stanford-ssi/Aerolotl_KiCAD/README.md

# Aerolotl_KiCAD, make sure to only one person works on it at a time

## Boards in this repo

- Aerolotl SRAD flight computer: the KiCad project at the top level.
- [Battery PCB](BatteryPCB/README.md): the AV bay battery, arming and camera board, with its ordering BOM and Gerbers in `BatteryPCB/fab/`.
