stanford-ssi/Aerolotl_KiCAD/BatteryPCB_30pin/README.md

# Battery PCB, 30-pin ESP32 version — AV bay power, arming and camera board

> **This folder is a copy of [`../BatteryPCB`](../BatteryPCB) made on 11 Oct 2026 for a 30-pin ESP32 DevKit V1**
> (DOIT layout, ESP-WROOM-32, 2 × 15 pins, rows 25.4 mm apart) instead of the 38-pin ESP32-DevKitC. Only the ESP32
> sockets and what connects to them changed: J1/J2 are 1×15 with pin 1 exactly where the DevKitC's was, the six used
> pins (5 V, GND, GPIO34, GPIO17, GPIO16, GPIO2) are re-routed, R7/R8 and C9/C10 moved next to their new pins,
> and the silk and antenna keep-out follow the new board. Same GPIOs, so the firmware is unchanged.
> See [`LAYOUT_NOTES.md`](LAYOUT_NOTES.md), "30-pin version".

The battery board for the SSI IREC AV bay: it holds the cells for both flight computers
(each with its own pin-switch arming plug) and a 2S pack that powers an ESP32 and a
RunCam Split 4 camera on the back. Formerly called CamControl.

Open `battery_pcb_30pin.kicad_pro` in KiCad 10. The board is a 5.72 in (145.3 mm) round, 2-layer disc
for the AV bay, placed and fully routed.

**Status (30-pin version, 11 Oct 2026):** ERC 0 errors · DRC 0 violations (warnings included) under the strict rules below, with full schematic parity
(3 documented exclusions, as on `BatteryPCB`; checked with KiCad 10.0.6, see `battery_pcb_30pin.kicad_dru`) · `tools/layoutA/verify_A.py` ALL PASS (36 checks; its cut-out check now counts the 7 rim
notches and Koichi's 4 square zip-tie cut-outs). Ready to order: see [Ordering](#ordering).
[`LAYOUT_NOTES.md`](LAYOUT_NOTES.md) has the history of every layout decision.

---

## What's on it

| Block | Parts |
|---|---|
| 2S pack for camera + ESP32 | BT1, BT2 in series → 7.4 V nom / 8.4 V max |
| Input protection | F1 2 A polyfuse → SW1 (camera power switch plug) → Q1 AO3407A reverse-polarity PMOS (gate to GND, ~0.05 V drop) → D1 SMBJ12A TVS |
| Buck 8.4 V → 5.0 V | U1 LMR51430 (500 kHz) + L1 6.8 µH + FB divider; input caps C1 100 nF (at U1's pins) + C2, C11 10 µF |
| Low-battery cut-off | R9 402k / R10 100k on U1's EN: on above 6.2 V, off below 5.4 V at VIN (about 2.7 V per cell), so the 2S pack is never run flat |
| 30-pin ESP32 DevKit V1 socket | J1, J2 — 2 × 1×15 female headers |
| Camera harness | J3 — JST GH 5-pin (+5V, GND, RX, TX, VIDEO), on the back |
| Camera mount | H7–H10 — four M2 × 5 mm SMT standoffs on a 25.5 mm square, on the back |
| Status LED | R6 + D2 on GPIO2 |
| Pack voltage telemetry | R4 100k / R5 39k divider + C8 → GPIO34 (`VBAT_SENSE = VIN × 39/139`, ≤ 2.36 V) |
| Test points | 2 mm through-hole pads, open on both sides. **Right-edge block** (front, between the right rod and the lower zip-tie cut-out, top row / bottom row): TP1 +5V / TP3 GND, TP5 COTS cell + / TP6 COTS cell −, TP7 SRAD cell + / TP8 SRAD cell −. **Lower left** by the camera switch: TP2 VBAT+ (2S pack, before the fuse) / TP4 GND |
| COTS supply | BT3 → SW2 (COTS pin switch plug) → J5 XT30 to the TeleMetrum |
| SRAD supply | BT4 → SW3 (SRAD pin switch plug) → J6 XT30 to the Aerolotl |

Harness connectors are latching Molex Micro-Fit 3.0 for the switch leads (SW1–SW3) and JST GH for the
camera (J3). The two battery outputs, J5 and J6, are **AMASS XT30** (male XT30UPB-M on the board):
**pin 1 is minus, pin 2 is plus**, as moulded on the housing and printed beside each one. The cables take an
XT30U-F female plug. The footprint retains its legacy XT30UPB-F name; order XT30UPB-M (C428721). XT30 holds by friction, so tape or tie the plugs for flight. The male pins are exposed and plus is live when its arming switch closes; keep the mating plug connected or cover the pins when armed.

---

## Three design decisions worth knowing

### 1. The Split 4 has no GPIO shutter line

Its harness is **VCC / GND / Video**. Recording start/stop is done over **UART**
using the RunCam Device Protocol on the TX/RX pads, not a single logic pin.

So the schematic wires **UART2** (GPIO17 TX, GPIO16 RX) to the camera through
series resistors: R7 100 Ω on the ESP32's TX, R8 1 kΩ on the camera's TX (so a 5 V camera
output can't push more than about 1 mA into GPIO16). UART0 is left free so you can still
program and debug over USB. On the original DOIT DevKit V1 design, VIN is fed from USB through an SS14 Schottky, so
USB and this board's 5 V can be connected at the same time. Clones vary: until you have checked yours (USB only:
VIN should read about 4.6–4.8 V, one diode drop below USB), switch the camera pack off before plugging USB in.

The camera connects to this board through the 5-pin J3 harness only (no
button-pad wiring).

**The camera harness is a straight cable.** The Split 4 has five solder pads, in this order with Side B
facing you: RX, TX, Video, GND, VCC. J3 is in the same order (pin 5 … pin 1), so each wire goes straight across,
no crossing (J3's pins 3 and 5 were swapped on 11 Oct 2026 to make this so):

| J3 pin | Net | Camera pad |
|---|---|---|
| 1 | +5V | VCC |
| 2 | GND | GND |
| 3 | VIDEO | Video, or leave unconnected (nothing on this board uses it) |
| 4 | CAM_TX (to ESP32 RX through R8) | TX |
| 5 | CAM_RX (ESP32 TX through R7) | RX |

Note: the original `BatteryPCB` still has the old order (3 = RX, 5 = Video), so its harness is wired by label.

### 2. Everything runs off one 5 V buck

The camera accepts 5–20 V, so 2S could feed it directly — but RunCam explicitly
warns to power it from a regulator rather than a raw battery bus.

Feeding the ESP32 8.4 V directly would also be a problem: the devkit's onboard
AMS1117 would drop 8.4 → 3.3 V and burn about **1.3 W** in a SOT-223. It would
run very hot.

One LMR51430 at 5 V solves both. The ESP32's regulator then only drops 5 → 3.3 V,
and the camera gets a clean supply.

Feedback divider: `Vout = 0.6 × (1 + 100k / 13k) = 5.22 V` (5.05–5.39 V worst case over resistor and reference tolerance, so the camera always sees ≥ 5.0 V)

### 3. COTS and SRAD grounds are deliberately isolated

`COTS_BAT-` and `SRAD_BAT-` are **not** tied to `GND`.

DTEG §6.9.1 requires completely independent recovery systems — separate power
supplies included. Tying the returns together would create a shared failure path
and defeat that. Each of those two cells is its own island: own cell, own switch,
own two-wire output.

Do not "clean this up" by merging the grounds.

---

## Which ESP32

A **30-pin ESP32 DevKit V1** with the DOIT pinout and a WROOM module (the team's USB-C / CP2102 board is one): 2 × 15 pins,
rows 1.0 in (25.4 mm) apart, header order EN, VP, VN, D34 … D13, GND, VIN on one side and D23, D22, TX0 … D15, GND, 3V3 on
the other (antenna at the top). The sockets are wired to that order pin for pin.

- **Check the row spacing before you solder the sockets:** 25.4 mm between the centres of two facing pins. A few narrow
  clones are 22.9 mm; they won't fit.
- **Not a WROVER module:** it uses GPIO16/17 for its PSRAM, and this board uses them for the camera UART.
- **Not the 38-pin ESP32-DevKitC:** that one needs `../BatteryPCB` (2 × 19 sockets).
- It plugs in from the **back**, components facing away from this board, antenna end toward the top: **EN** and **D23**
  go at the "ANTENNA END" silkscreen, **VIN** and **3V3** at the USB end (both labelled on the back silk).
- The board sits inside the area the DevKitC used (51.3 × 28 mm vs 54.3 × 27.9 mm), so nothing new is in its way. Its
  module doesn't overhang: the antenna ends about 5.4 mm past pin 1, about 1.9 mm further in than the DevKitC's.
- **Antenna clearance.** Espressif recommends at least 15 mm of clearance in every direction around the module's PCB
  antenna. The devkit hangs about 13.4 mm under this board, so the back copper has a keep-out (no pour, tracks or vias)
  15 mm to each side of the antenna and past its end, outlined on the back silk (extended 1.9 mm toward the centre for
  this board's antenna). Everything on the front, cells and pin-switch stack included, is at least 15 mm away through
  the board. **Use a nylon M3 bolt and nut in H5**: it is the pin-switch stack bolt right over the antenna.
  [Espressif: positioning a module on a base board](https://docs.espressif.com/projects/esp-hardware-design-guidelines/en/latest/esp32/pcb-layout-design.html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)
- The AVBay1 Onshape model already shows a 2 × 15 DevKit, which matches this version.

## ESP32 pin map

| Function | Pin | Net |
|---|---|---|
| 5 V in | J1-15 (VIN) | `+5V` |
| GND | J1-14, J2-14 | `GND` |
| Camera UART TX | J2-9 (TX2, GPIO17) | `ESP_TX2` → R7 → `CAM_RX` |
| Camera UART RX | J2-10 (RX2, GPIO16) | `ESP_RX2` → R8 → `CAM_TX` |
| Status LED | J2-12 (D2, GPIO2) | `LED_GPIO` → R6 → D2 |
| Pack voltage | J1-4 (D34, GPIO34, ADC1) | `VBAT_SENSE` |

J1 is the devkit's EN … VIN header and J2 its D23 … 3V3 header,
both counted from the **antenna end**, which faces the top of the board. Same GPIOs as the DevKitC version.

Every unused header pin is broken out to a named net (`L06_IO35`, `R09_IO18`, …)
so you can see what's free. Those produce 24 `isolated_pin_label` ERC warnings —
expected and harmless, they're spare breakouts by design.

The 30-pin board doesn't break out GPIO6–11 (the module's SPI flash) or GPIO0. Of the strapping pins it does break out,
keep GPIO12 (`L12_IO12`) low at boot; GPIO2 (the LED, pulled low through R6/D2) and GPIO15 are fine as wired.

---

## Camera mounting

The RunCam Split 4 board (29 × 29 mm, M2 holes on a 25.5 mm square) sits on four Würth
9774050243R M2 × 5 mm SMT standoffs (H7–H10) on the back of this board, next to its J3 harness.
Each standoff has a 1.4 mm locating pin on its base that drops into a 3.0 mm hole in the board (Würth's land pattern);
the pin stays inside the 1.6 mm board, so nothing reaches the battery side. Use M2 screws 4–6 mm long.
`battery_pcb.pretty/RunCam_Split4_OnStandoffs.kicad_mod` places its 3D outline; it has no pads
and is excluded from the BOM.

Source: [RunCam Split 4 manual](https://www.runcam.com/download/split4k/RC_Split_4k_Manual_EN.pdf)

---

## Open items

1. **The ESP32's Bluetooth is a 2.4 GHz transmitter.** DTEG §4.3.5 forbids
   powering transmitting electronics in the pit area without authorization, and
   2.4 GHz is not in ESRA's Student Band Plan. SW1 exists partly so you can keep
   it off until the pad. Declare this radio in your progress reports.
2. **No SD card module** is on this schematic — you mentioned one for the plate
   but didn't list it in the brief. Easy to add on SPI (GPIO5/18/19/23).
3. **Confirm the camera's logic level** before connecting RX/TX: power the camera and
   measure its TX pad to GND. About 3.3 V: wire it straight on. About 5 V: R8 (1 kΩ)
   protects the ESP32's input, but the camera may not read the ESP32's 3.3 V TX; add a
   level shifter then.

Layout-specific items are in [`LAYOUT_NOTES.md`](LAYOUT_NOTES.md).

---

## Mechanical dimensions

Front view (battery side), origin at the board centre, **x right, y up toward the pin-switch stack** (the Onshape frame).
All in mm unless noted.

| Feature | Size | Position |
|---|---|---|
| Board | Ø 145.29 (5.720 in), 1.6 thick FR-4 | centred |
| Rod holes H1/H2 (3/8 in threaded rod) | Ø 10.32 (13/32 in) | (−60, 0), (60, 0): 120 apart |
| Rod washer keep-out (no copper, both faces) | Ø 21.2 | around H1/H2 |
| TeleMetrum sled screw holes H3/H4 (M4) | Ø 4.5 | (−8.7, −50), (8.7, −50): 17.4 apart |
| Sled screw keep-out (no copper) | Ø 9.6 | around H3/H4 |
| Pin-switch stack bolt holes H5/H6 (M3) | Ø 3.2 | (18.5, 41.88), (−18.5, 48.88) |
| Pin-switch stack footprint (silk outline) | 45 wide, from y 36.88 out to the pin faces at 68.88 | x −22.5 … 22.5 |
| Camera standoffs H7–H10 (back, Würth M2 × 5 mm SMT) | 25.5 square | centre (−35.5, 30): upper left, near the rim |
| Battery holders BT1–BT4 (Keystone 1042) | 14.9 tall | centres x −36.5, −14.3, 11.1, 36.5; y −2.25 |
| ESP32 sockets J1/J2 (back, 1×15, 8.5 tall) | columns 25.4 apart | x 23.8 and −1.6; pin 1 at y 35.12, pin 15 at y −0.44 |
| ESP32 antenna (devkit hangs ~14 mm below) | 18 × 6 | x 2.1 … 20.1, y 34.5 … 40.5; back-copper keep-out 15 mm around |
| Edge cut-outs (W × D, centre angle CCW from +x) | 40 × 14 at 270° (COTS mount); 10 × 6 at 230° and 327°; 12 × 7 at 30°, 120°, 150°, 200° | on the rim |

Connectors (pad centres): J5 XT30 COTS OUT (22.5/27.5, −51.5), J6 XT30 SRAD OUT (37.5/42.5, −51.5), SW1 CAM PWR
(−30.5/−27.5, −55.1), SW2 COTS ARM (28.3/31.3, 50.4), SW3 SRAD ARM (39.6/42.6, 50.4), J3 camera on the back
(pins −1.5 … −6.5, −20.45). Test points: block at x 51.5 / 56.5 / 61.5, y −15.5 (top row) / −20.5: TP1 +5V, TP5 COTS +, TP7 SRAD +
over TP3 GND, TP6 COTS −, TP8 SRAD −; TP2 VBAT+ (−36.5, −49.5), TP4 GND (−40.5, −49.5).

Heights above the board: front: holder 14.9 (the cell sits a little higher), pin-switch stack ~20.4 (two 10 mm
carriers + 0.4 shim), Micro-Fit 10.2, XT30 about 11. Back: ESP32 socket 8.5, the 30-pin DevKit about 14–16 including its module,
camera standoffs 5 + the camera, JST GH 4.2.

## Design rules

Stricter than the fab's minimums, to leave margin (all in `battery_pcb_30pin.kicad_pro`):

| Rule | Value |
|---|---|
| Copper clearance | 0.25 mm signals, 0.3 mm power and ground, 0.4 mm for the isolated COTS/SRAD battery nets |
| Track width (min) | 0.25 mm; pyro paths ≥ 1.0 mm, 2S power ≥ 1.5 mm (checked by `verify_A.py`) |
| Copper to board edge | 0.5 mm |
| Hole clearance / hole to hole | 0.3 mm / 0.5 mm |
| Via | ≥ 0.6 mm pad, 0.3 mm drill (0.15 mm ring); power vias 0.8 / 0.4 mm |
| Silkscreen | 0.15 mm to other silk and to the edge; text ≥ 0.8 mm |

DRC runs with every check as an error (`tools/drc.sh`).

---

## Ordering

Everything to order is in `fab/`:

| File | What it is |
|---|---|
| `fab/battery_pcb_30pin_BOM.csv` | Ordering BOM: every soldered part with manufacturer + MPN (paste the MPNs into the DigiKey or Mouser BOM tool), plus the camera standoffs, plug-in modules, cells, cable-side connectors and the PCB. "Order qty" covers 2 boards plus spares. The "LCSC #" column has a checked LCSC part for everything LCSC sells; "Other supplier" covers the rest (battery holders, camera standoffs, ESP32). |
| `fab/battery_pcb_30pin_JLCPCB_BOM.csv`, `fab/battery_pcb_30pin_JLCPCB_CPL.csv` | Only if JLCPCB assembles it: their BOM (LCSC part numbers) and placement files. Parts on both sides; check rotations in JLC's preview. The battery holders and camera standoffs are not at LCSC, so solder those yourself. |
| `fab/battery_pcb_30pin_gerbers.zip` | Gerbers + drill files (plated and non-plated separately). Upload as-is to JLCPCB (or any fab): 2 layers, 1.6 mm FR-4, 1 oz copper. |
| `fab/battery_pcb_30pin_schematic.pdf` | The schematic, for review and for soldering. |
| `fab/battery_pcb_30pin_kicad_project.zip` | The whole KiCad project in one file, to share: unzip it and open `battery_pcb_30pin.kicad_pro` (KiCad 10). Downloading only `battery_pcb_30pin.kicad_sch` gives a blank schematic, because its six pages live in `sheets/`. |

`cad/battery_pcb_30pin.step` is the board with all parts for CAD.
`cad/avbay1_board_30pin_and_pin_switch_stack.step` is the board plus the exact pin-switch stack,
raised 18 mm into the Onshape stack frame; it is what the SSI AVBay1 Onshape document imports.

---

## Hand assembly

Everything is hand-solderable (0603 passives, SOT-23-6, one 1.25 mm-pitch JST GH). Use flux, a fine conical tip for the
small parts and a big chisel tip at ~400 °C for the holder tabs and connector pins. **The order matters**: the ESP32
socket pins come up on the front in narrow channels between the battery holders, so solder them before the holders.

1. Back, small SMD: U1, the buck caps/resistors, R4/R5/C8, R6/D2, R7/R8, R9/R10, C9/C10/C11, D1, Q1, F1, then L1
   (hot air helps; its pads run under the body).
2. Back: J3 (JST GH, fine pitch: tack one mounting tab, then the pins), then the four camera standoffs H7–H10 (steel:
   drop each pin into its 3 mm hole, then solder paste + hot air, or flux and the big tip around the base; keep them square).
3. J1/J2 sockets: insert from the back, solder on the front. **Before the holders.** Plug the ESP32 board in while
   soldering so the two rows stay parallel.
4. Front through-hole connectors (soldered on the back): SW1–SW3 Micro-Fit, J5/J6 XT30 (XT30 pins need a lot of heat).
5. Battery holders BT1–BT4 last (big tip, plenty of solder; check the + marks).
6. Bench test before cells or modules: 7–8 V, ~0.3 A limit into TP2 (+) / TP4 (GND); TP1 should read ~5.0 V against TP3.
   With cells in: the COTS cell reads across TP5 (+) / TP6 (−) and the SRAD cell across TP7 (+) / TP8 (−), whether or not
   their pin switches are armed. Those two cells are isolated from GND: always measure each across its own pair, never to TP3/TP4.

## Rebuilding

The layout is generated by scripts so it can be rebuilt after a change. Close KiCad first
(it rewrites project files when it quits), and use KiCad 10 on macOS (the scripts call its
bundled Python and `kicad-cli`).

```
tools/layoutA/build_A.sh /tmp/new.kicad_pcb   # place, route, labels, fields, refill, DRC, verify
cp /tmp/new.kicad_pcb battery_pcb_30pin.kicad_pcb
python3 tools/annotate_mpn.py                 # after changing a part: edit PARTS in it first
python3 tools/make_bom.py                     # rewrites fab/battery_pcb_30pin_BOM.csv
tools/make_fab.sh                             # BOM, schematic PDF, Gerbers + drills, project zip
tools/make_step.sh                            # cad/ STEPs (board centred) for Onshape AVBay1
```

`tools/layoutA/` starts from `seed_user_1224.kicad_pcb`, the hand-placed version, so hand edits
to `battery_pcb_30pin.kicad_pcb` are lost on the next rebuild: make changes in the scripts instead.
`tools/kc.py` holds the shared dimensions (disc size, battery and connector offsets). The one-shot
generators that made the very first versions are archived in `tools/obsolete/`; don't re-run them.

## Final order comparison — 11 October 2026

Use `fab/order-package/` for the partial back-side assembly quote: 5 fabricated boards, 2 assembled, 27 placements per assembled board. Upload its Gerber ZIP, `BOM-quote.csv` and `CPL-bottom.csv`. The legacy full `fab/battery_pcb_30pin_JLCPCB_BOM.csv` includes additional hand-fit connectors and is not the partial assembly BOM.

C1 is now C49678, C4/C5 C45783 (22 uF / 25 V), and D2 C84256. The schematic and PCB part fields are synchronized. Q1 remains AO3407A. JLC matched all 18 part types: $33.51 bare boards or $75.10 with two partially assembled, before shipping/tax. See the package README for substitutions and remaining mechanical/placement review limitations, including U1's DDC land-pattern compatibility.

The saved board includes the current square zip-tie cutouts. Previous CAD/renders/project-sharing archives may predate these latest edits; use the current KiCad project and current fabrication ZIP for ordering.
