stanford-ssi/Aerolotl_KiCAD/BatteryPCB_30pin/renders/battery_pcb_top.png

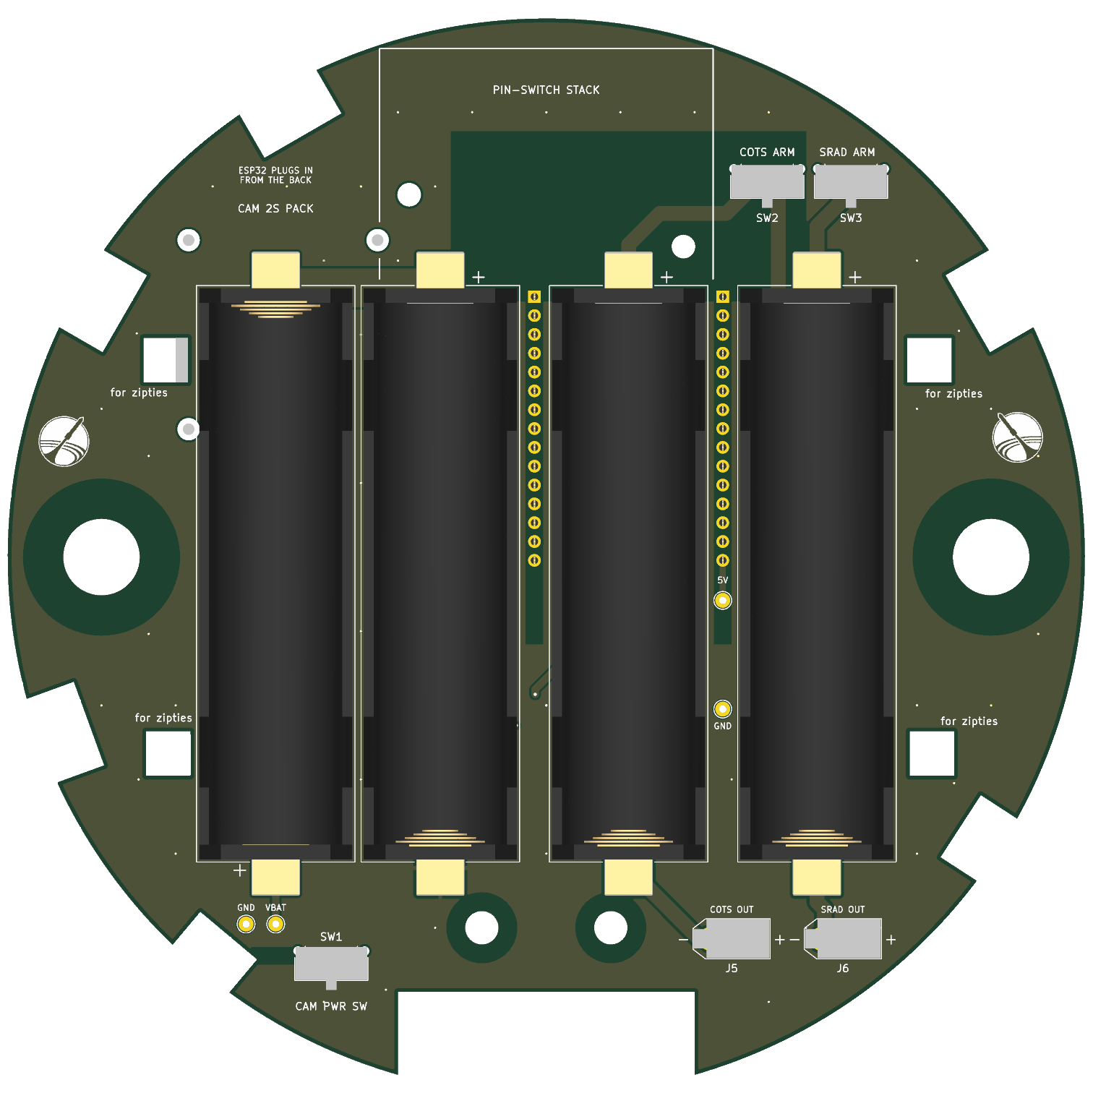
BatteryPCB_30pin/renders/battery_pcb_top.png
