stanford-ssi/Aerolotl_KiCAD/BatteryPCB/3dmodels/AMASS_XT30UPB-F_1x02_P5.0mm_Vertical.step

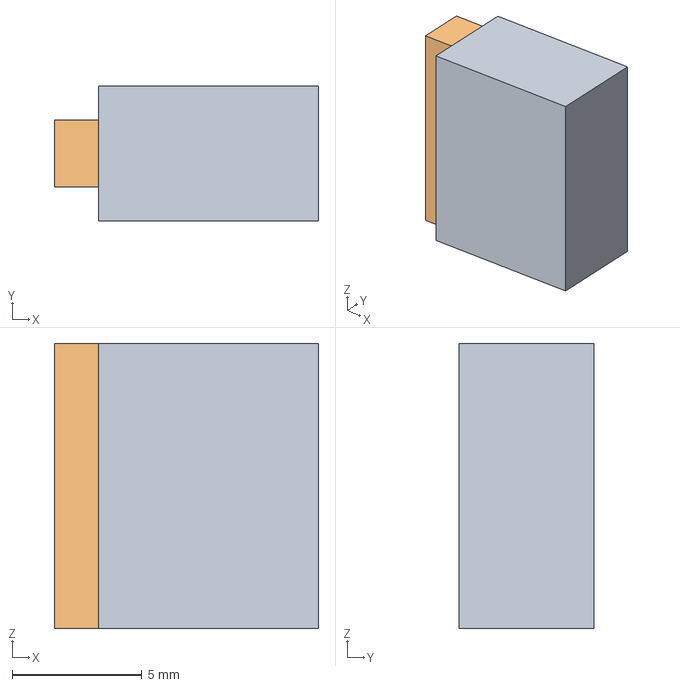
[picture p3: CAD file, 2026-10-08]
BatteryPCB/3dmodels/AMASS_XT30UPB-F_1x02_P5.0mm_Vertical.step
10.2 x 5.20 x 11.0 mm
