stanford-ssi/Aerolotl_KiCAD/BatteryPCB_30pin/3dmodels/Molex_Micro-Fit_3.0_43650-0215_1x02_P3.00mm_Vertical.step

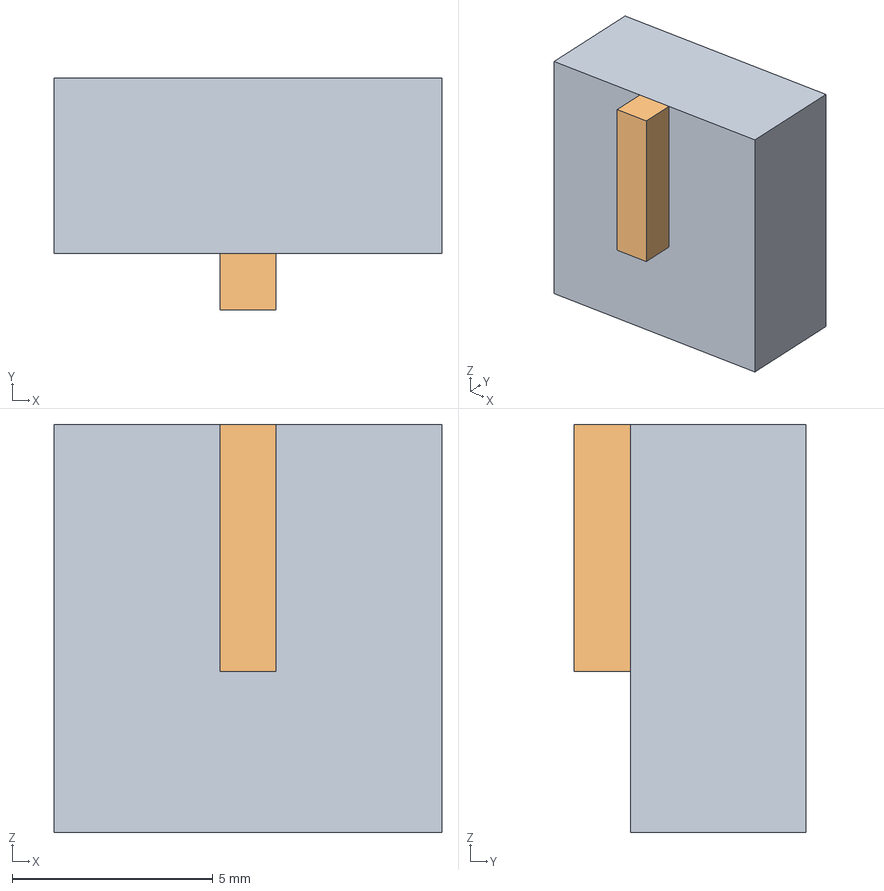
[picture p5: CAD file, 2026-10-06]
BatteryPCB_30pin/3dmodels/Molex_Micro-Fit_3.0_43650-0215_1x02_P3.00mm_Vertical.step
9.65 x 5.77 x 10.2 mm
