stanford-ssi/Aerolotl_KiCAD/BatteryPCB/3dmodels/RunCam_Split4_placeholder.step

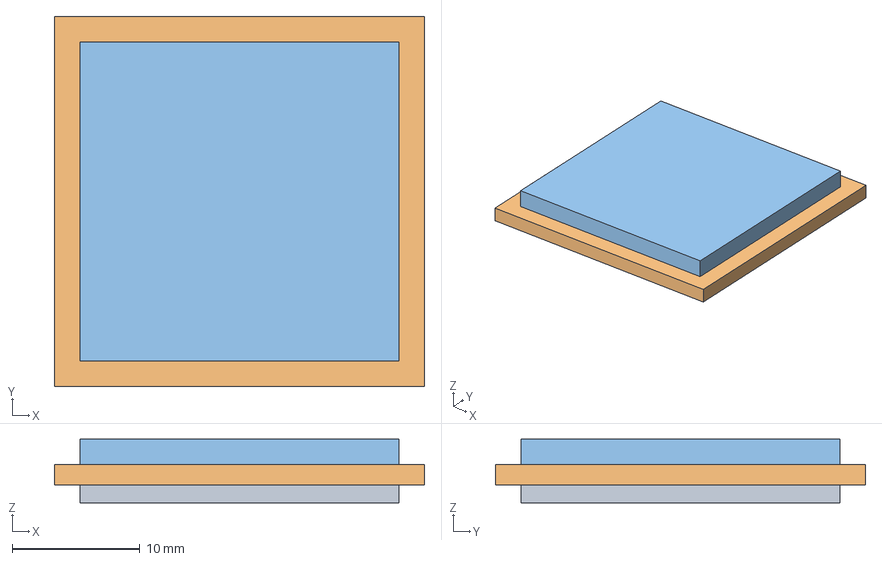
[picture p7: CAD file, 2026-10-06]
BatteryPCB/3dmodels/RunCam_Split4_placeholder.step
29.0 x 29.0 x 5.00 mm
