stanford-ssi/Aerolotl_KiCAD/BatteryPCB/cad/avbay1_board_and_pin_switch_stack.step

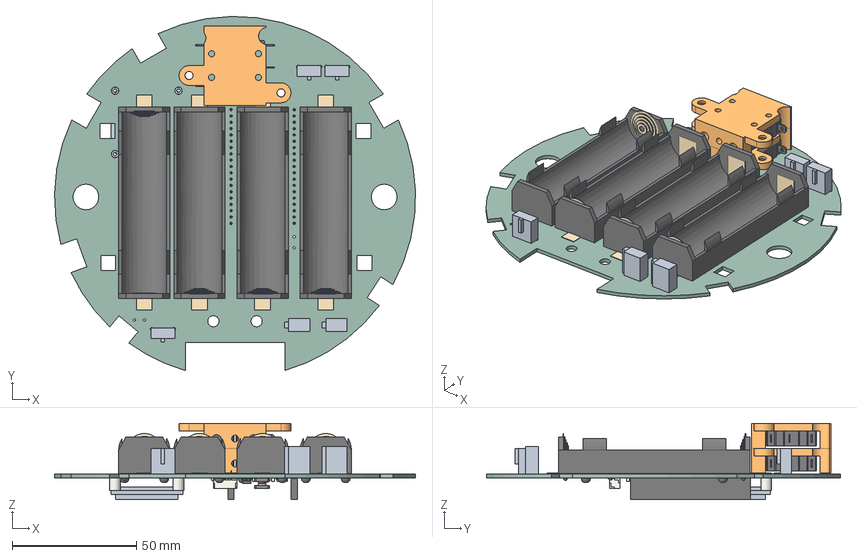
[picture p8: CAD file, 2026-10-12]
BatteryPCB/cad/avbay1_board_and_pin_switch_stack.step
145.2 x 142.5 x 30.6 mm
Molex_Micro-Fit_3.0_43650-0215_1x02_P3.00mm_Vertical x 3
BatteryHolder_Keystone_1042_1x18650 x 4
AMASS_XT30UPB-F_1x02_P5.0mm_Vertical x 2
C_0805_2012Metric x 6
Mounting_Wuerth_WA-SMSI-M2_H5mm_9774050243 x 4
JST_GH_BM05B-GHS-TBT_1x05-1MP_P1.25mm_Vertical
LED_0805_2012Metric
C_0603_1608Metric x 5
R_0603_1608Metric x 9
PinSocket_1x19_P2.54mm_Vertical x 2
SOT-23-3
RunCam_Split4_placeholder
D_SMB
SOT-23-6
L_Bourns_SRN6045TA
battery_pcb_PCB
