stanford-ssi/Aerolotl_KiCAD/BatteryPCB/cad/pin_switch_stack_8parts_mm.step

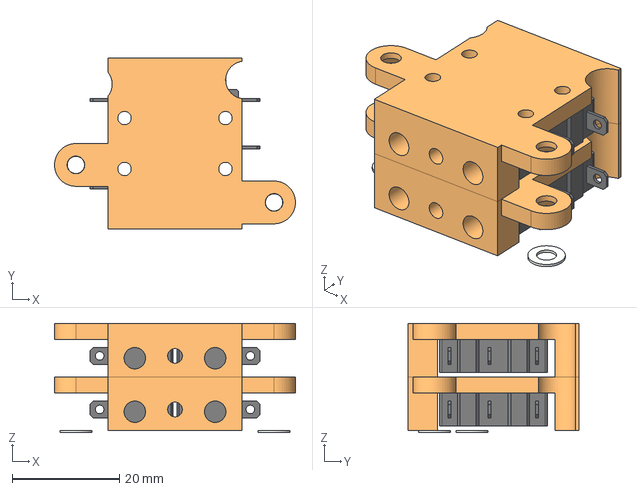
[picture p9: CAD file, 2026-10-06]
BatteryPCB/cad/pin_switch_stack_8parts_mm.step
45.0 x 32.0 x 20.4 mm
