stanford-ssi/Aerolotl_KiCAD/(list of files, cad)

Other CAD files:
BatteryPCB_30pin/cad/avbay1_board_30pin_and_pin_switch_stack.step
