stanford-ssi/Aerolotl_KiCAD/BatteryPCB/fab/battery_pcb_schematic.pdf

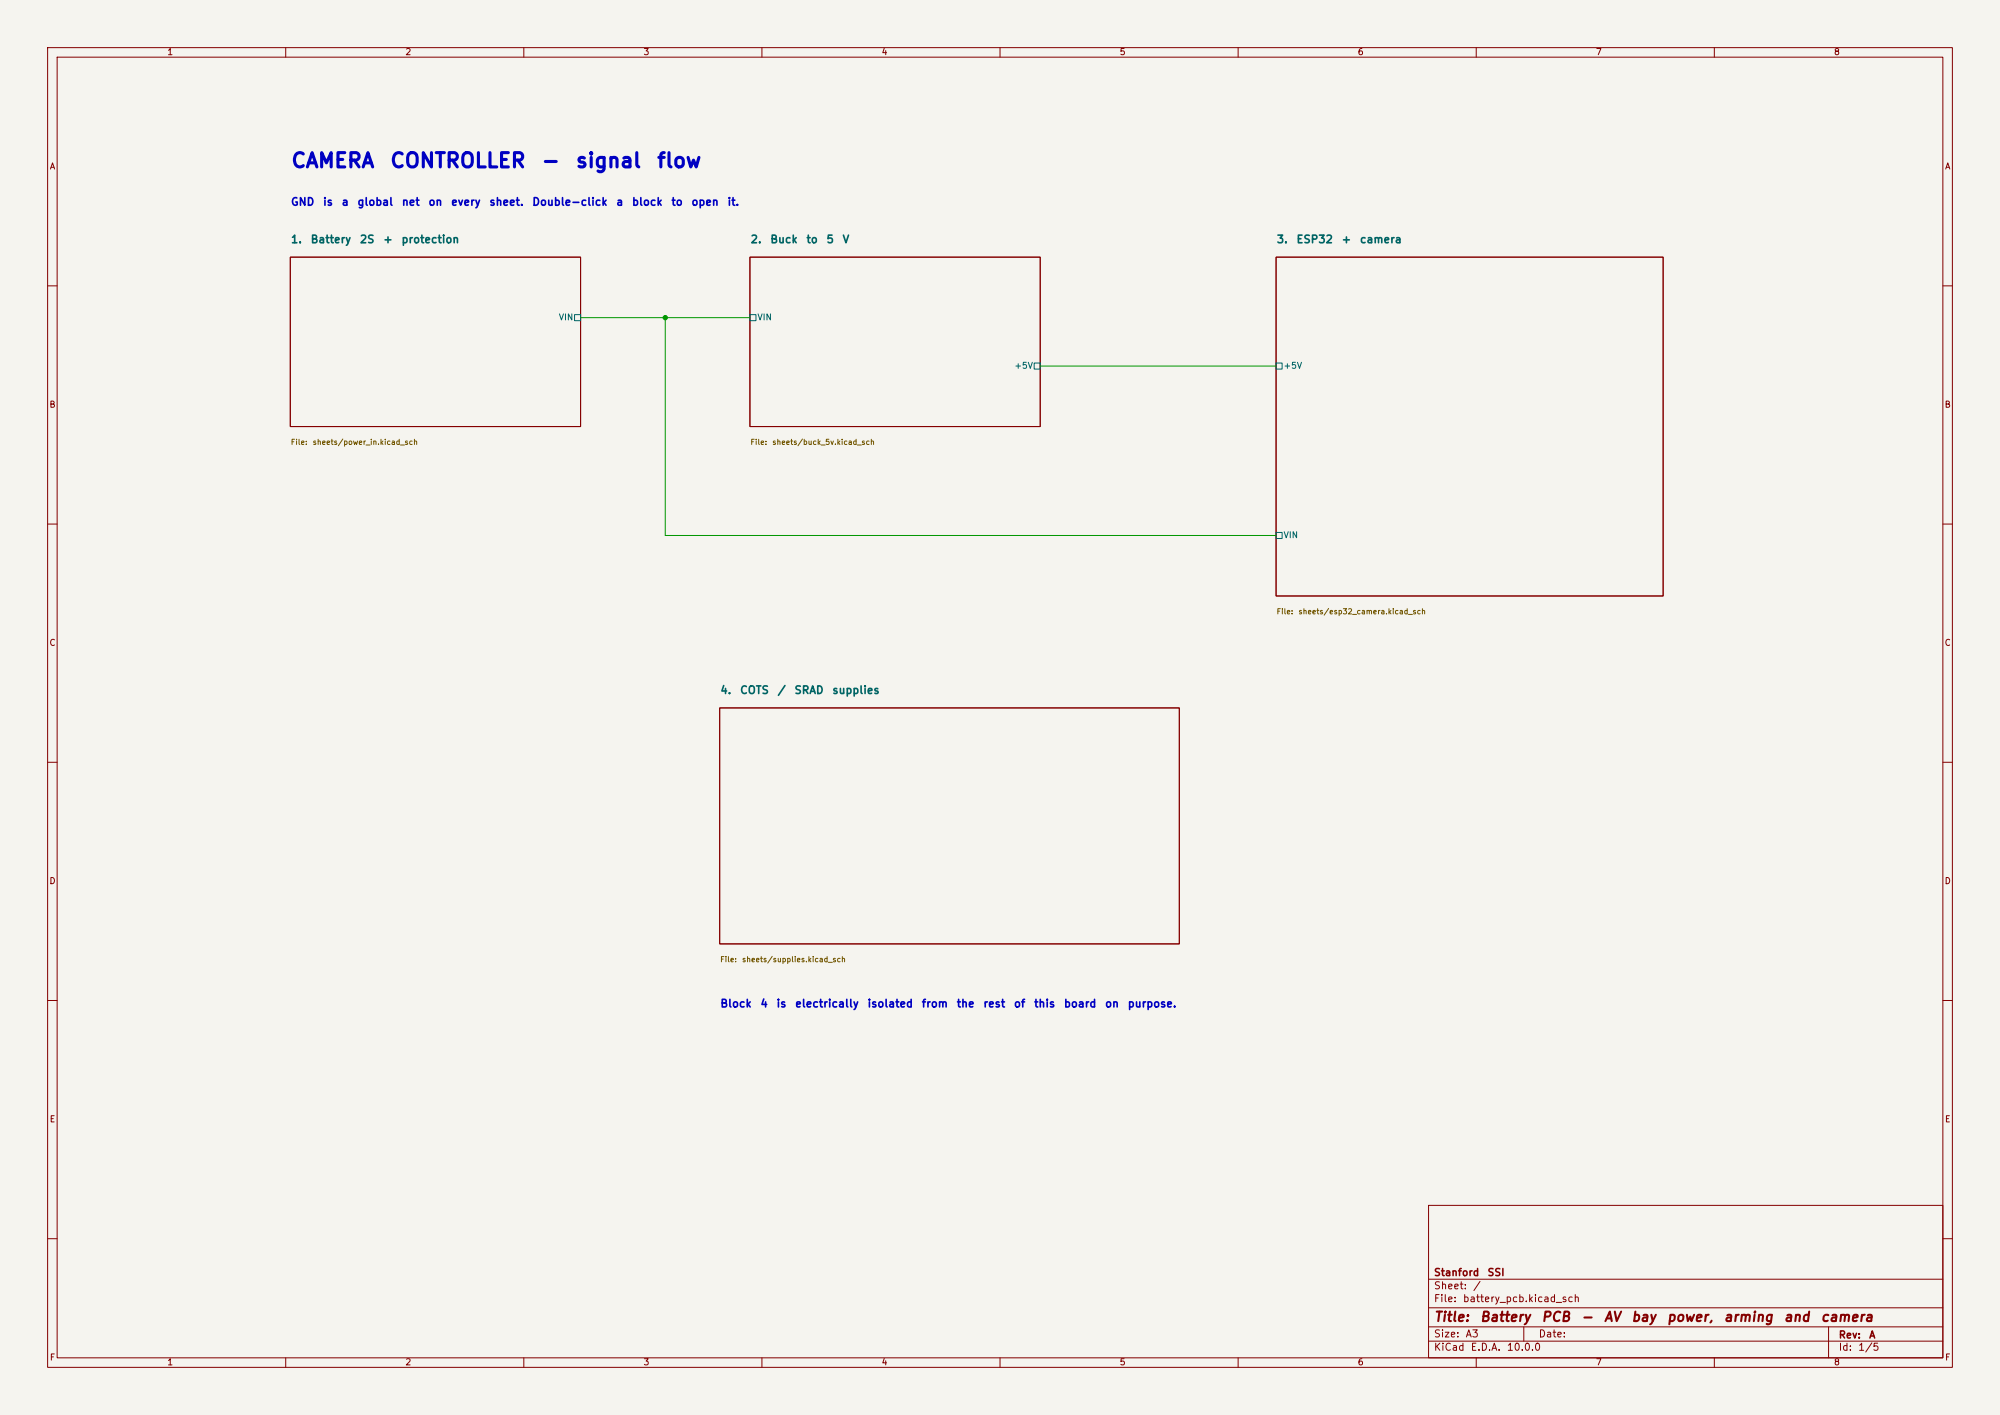
[picture p15: page 1]

File: sheets/supplies.kicad_sch CAMERA CONTROLLER - signal flow

GND is a global net on every sheet. Double-click a block to open it.

File: sheets/esp32_camera.kicad_sch 4. COTS / SRAD supplies

Block 4 is electrically isolated from the rest of this board on purpose.

Stanford SSI
Sheet: /
File: battery_pcb.kicad_sch
Title: Battery PCB - AV bay power, arming and camera

Size: A3 | Rev: A | F Date:
KiCad E.D.A. 10.0.0 | Id: 1/5


2 x 18650 in series: 7.4 V nominal, 8.4 V full. Charge the cells off the board, one at a time, in a Li-ion charger. TP2

D1: TVS, 12 V standoff (above the 8.4 V full pack), clamps below 20 V; everything on VIN is rated 25 V or more. Low-battery cut-off: U1's EN divider on sheet 2 (about 2.7 V per cell).

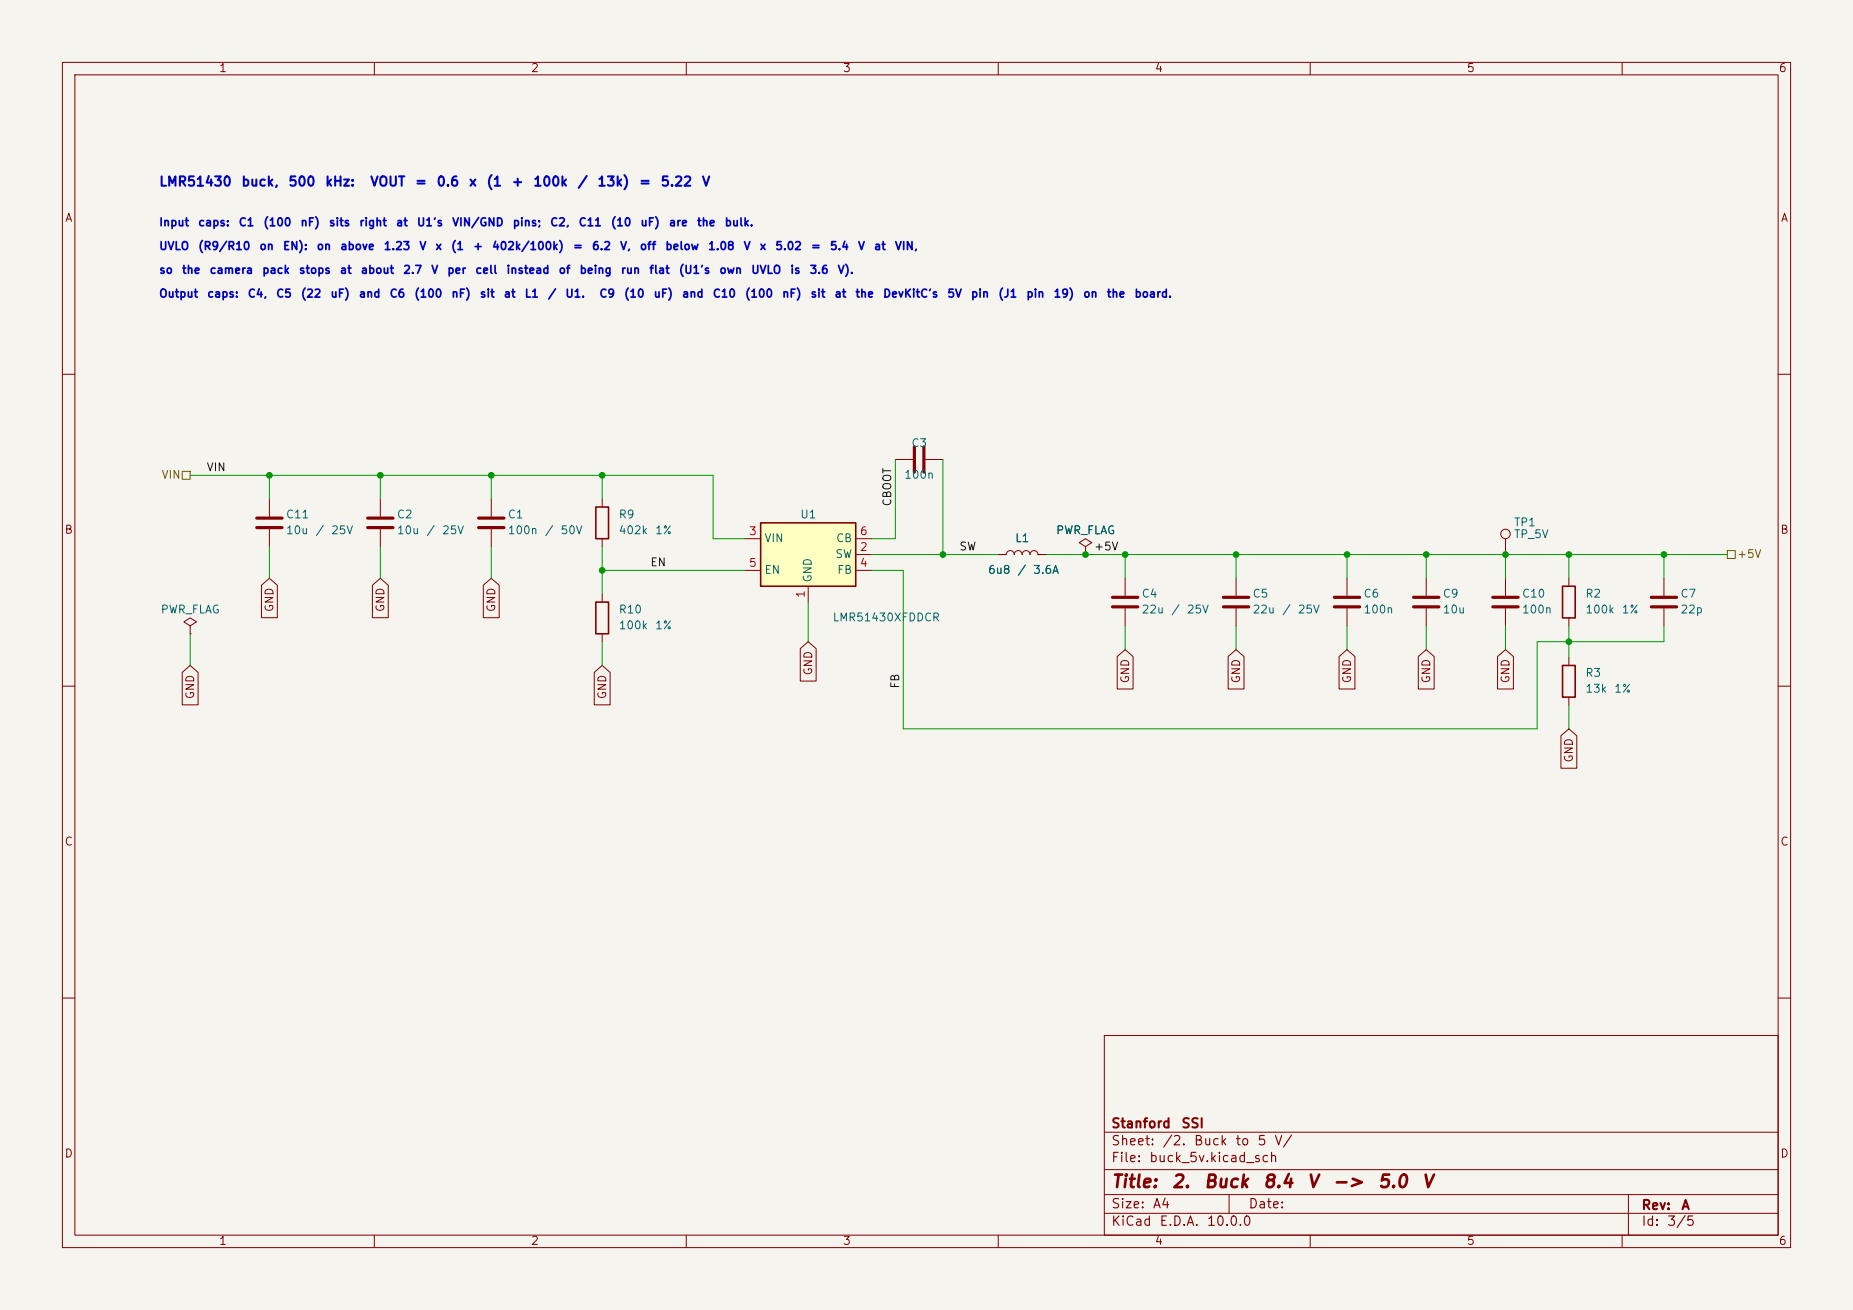
[picture p16: page 3]

Input caps: C1 (100 nF) sits right at U1's VIN/GND pins; C2, C11 (10 uF) are the bulk. so the camera pack stops at about 2.7 V per cell instead of being run flat (U1's own UVLO is 3.6 V).

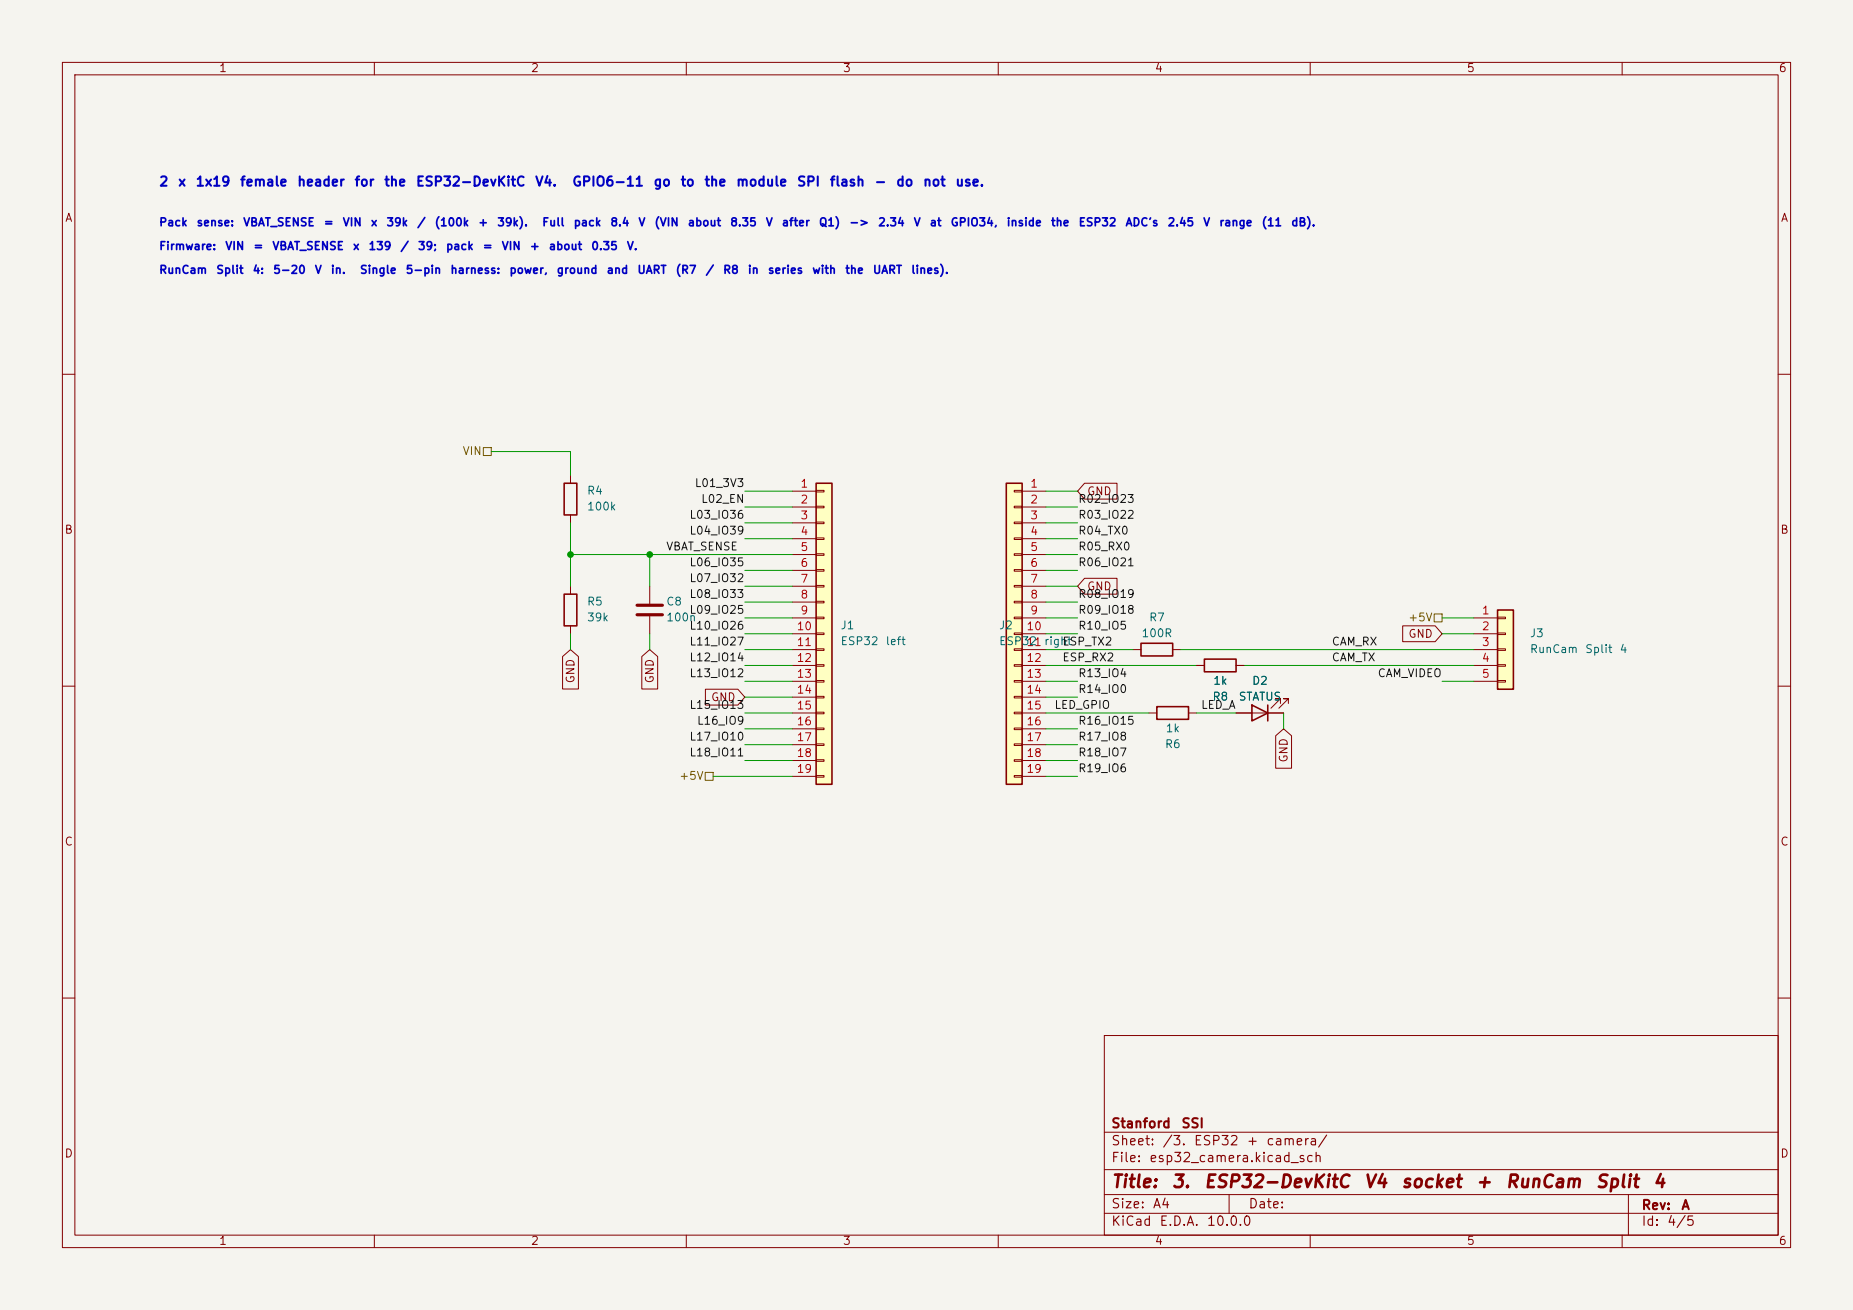
[picture p17: page 4]

Sheet: /3. ESP32 + camera/
File: esp32_camera.kicad_sch
Title: 3. ESP32-DevKitC V4 socket + RunCam Split 4

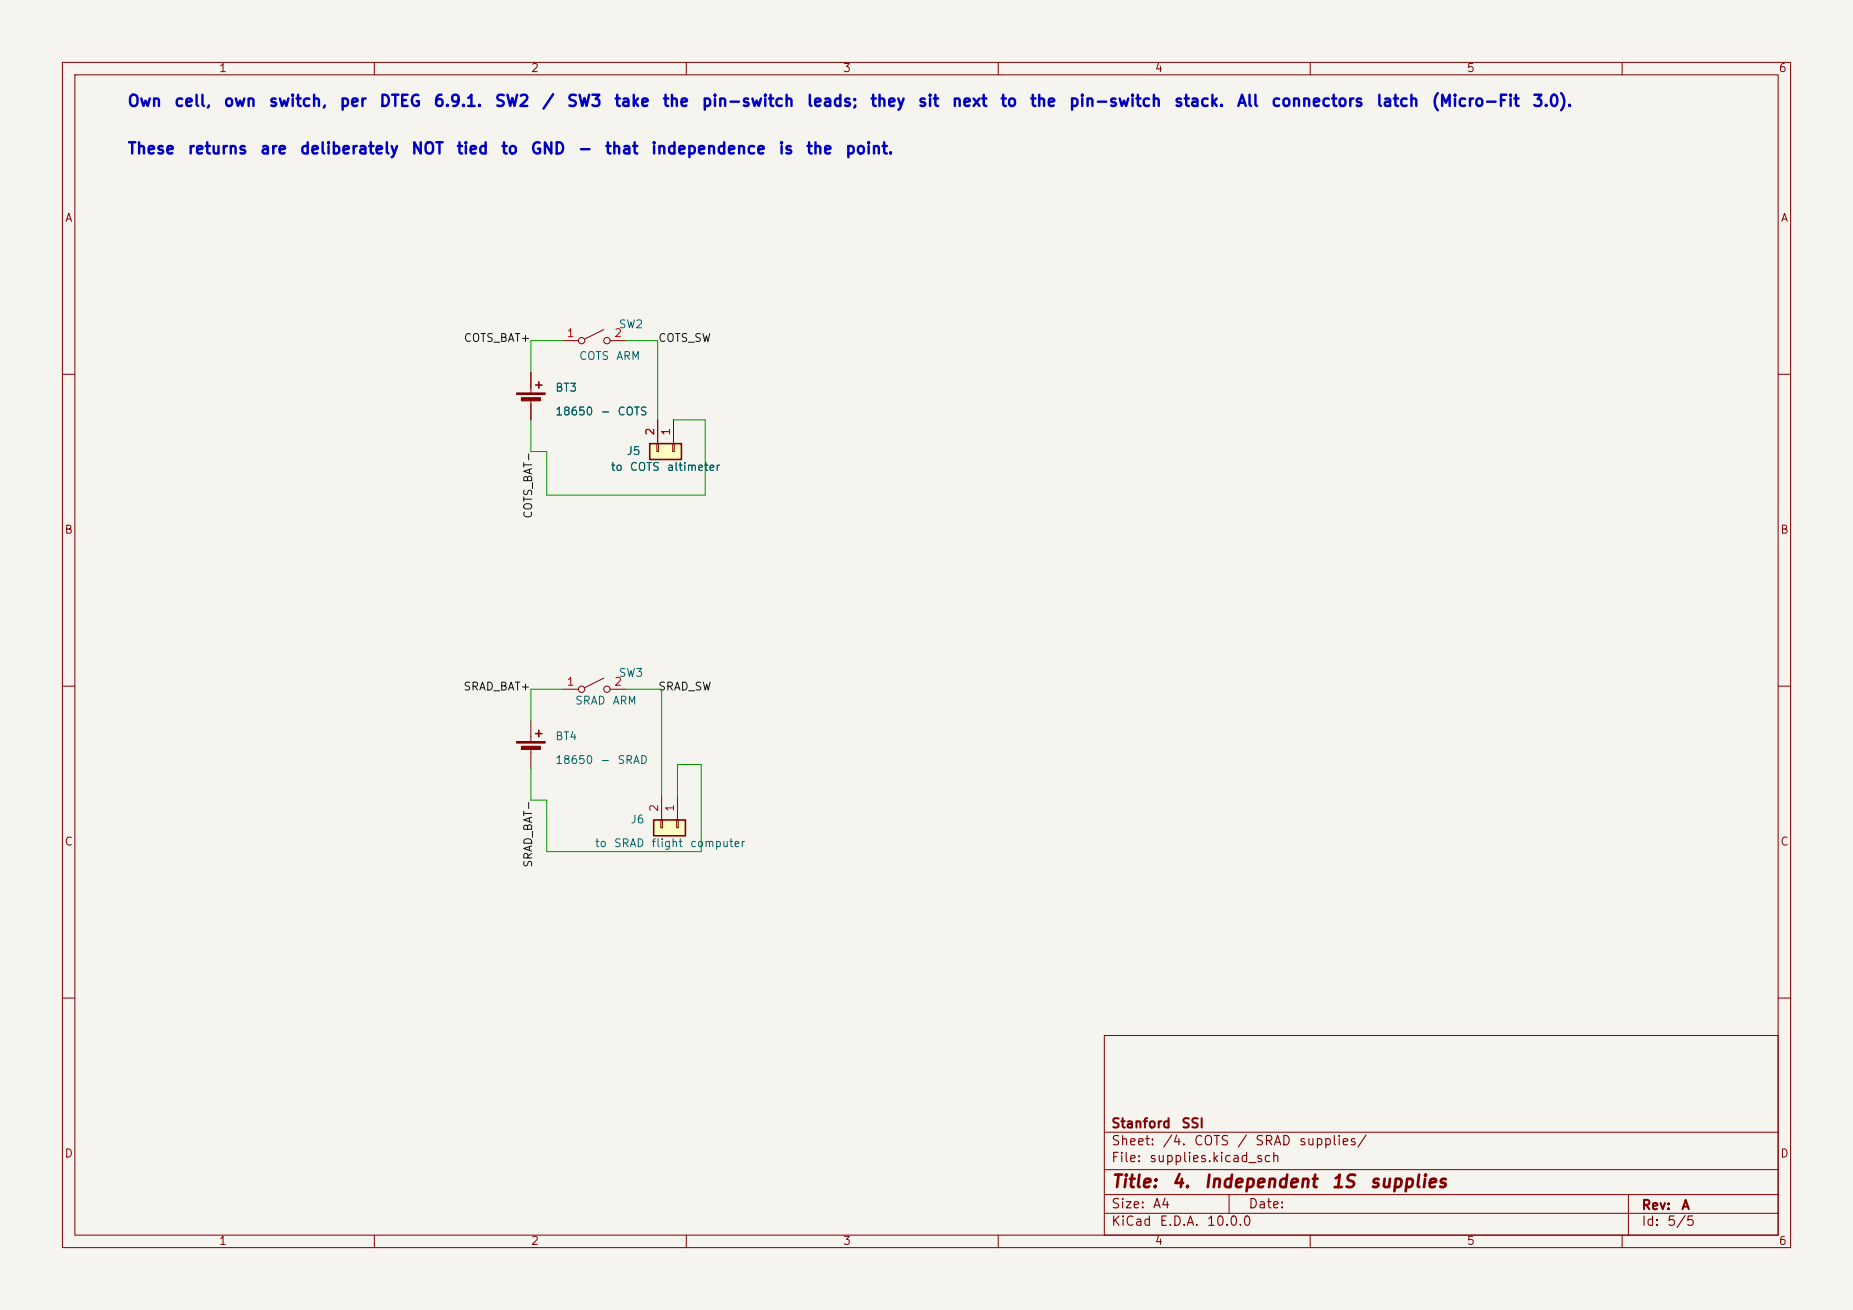
[picture p18: page 5]

Own cell, own switch, per DTEG 6.9.1. SW2 / SW3 take the pin-switch leads; they sit next to the pin-switch stack. All connectors latch (Micro-Fit 3.0). BT3

These returns are deliberately NOT tied to GND - that independence is the point.

to SRAD flight computer SRAD_BAT-

Sheet: /4. COTS / SRAD supplies/
File: supplies.kicad_sch
Title: 4. Independent 1S supplies
