stanford-ssi/Aerolotl_KiCAD/revs/aerolotl.pdf

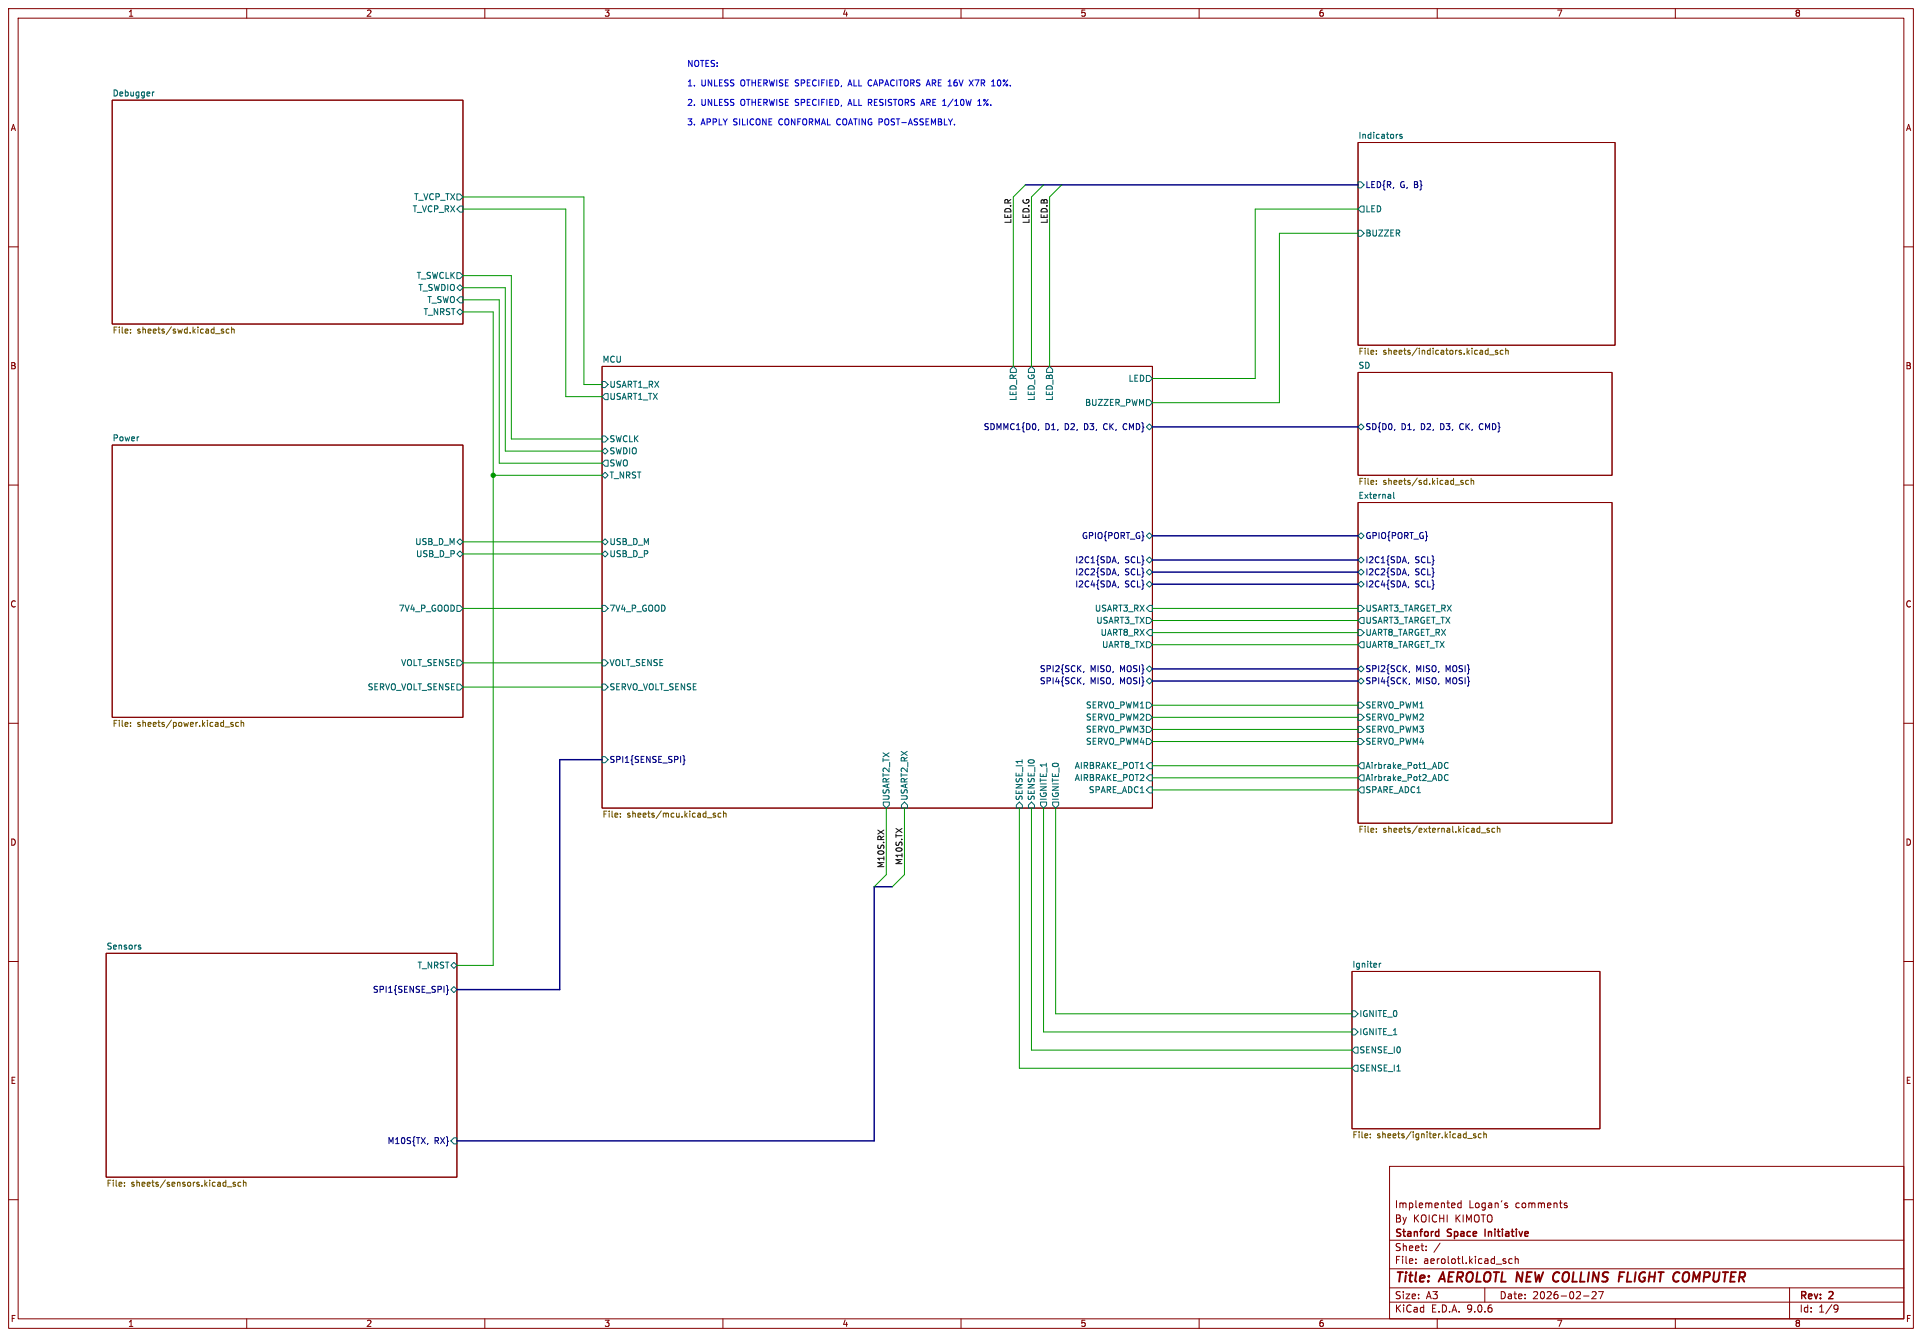
[picture p19: page 1]

T_NRST Debugger File: sheets/swd.kicad_sch

Power File: sheets/power.kicad_sch

SD{D0, D1, D2, D3, CK, CMD} SD
I2C1{SDA, SCL} SERVO_PWM3 SERVO_PWM4 External File: sheets/external.kicad_sch
I2C4{SDA, SCL} Airbrake_Pot1_ADC

SPI4{SCK, MISO, MOSI} UART8_TARGET_RX UART8_TARGET_TX USART3_TARGET_RX USART3_TARGET_TX GPIO{PORT_G}

M10S{TX, RX} T_NRST Sensors File: sheets/sensors.kicad_sch

Igniter File: sheets/igniter.kicad_sch

Id: 1/9 Title: AEROLOTL NEW COLLINS FLIGHT COMPUTER

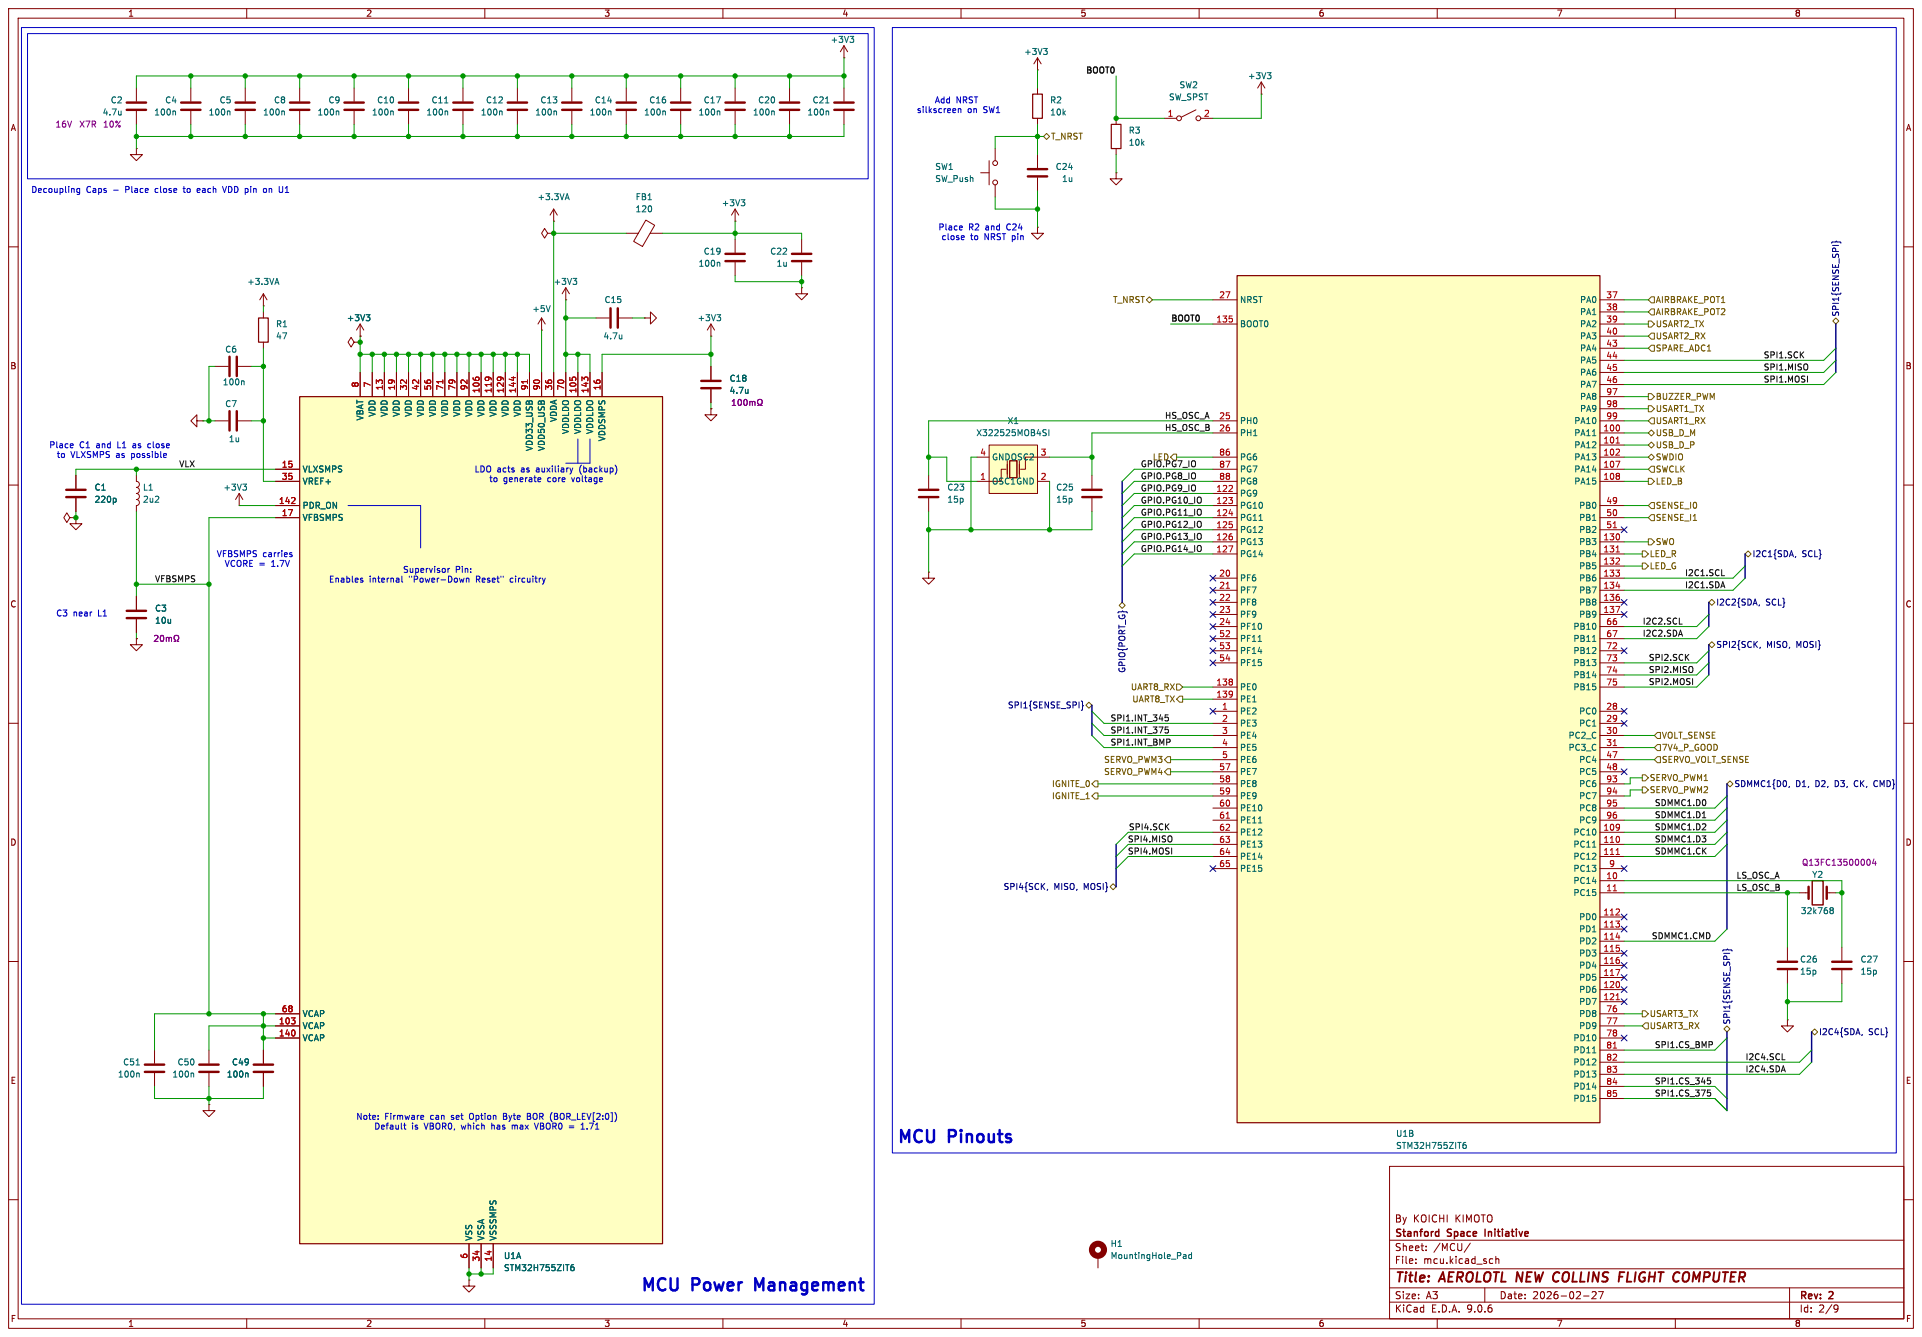
[picture p20: page 2]

7 VDD 13 VDD 19 VDD 32 VDD 42 VDD 56 VDD 71 VDD 79 VDD 92 VSS

6 VDD 106 VSSA 34 VDD 119 VSSSMPS 14 VDD 129 VDD 144 VDD33_USB 91 VDD50_USB 90 VDDA 36 VDDLDO 70 VDDLDO 105 VDDLDO 143 VDDSMPS 16 U1A

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

to generate core voltage C3 near L1 Place C1 and L1 as close

Id: 2/9 Title: AEROLOTL NEW COLLINS FLIGHT COMPUTER

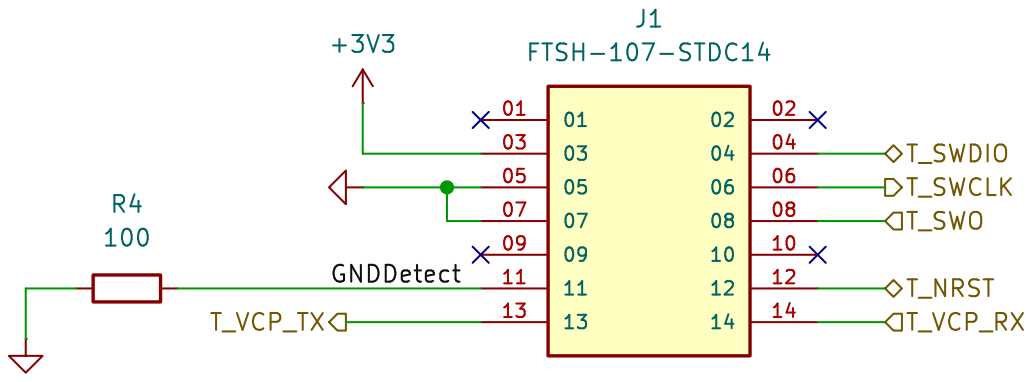
[picture p21: page 3]

Id: 3/9 Title: File: swd.kicad_sch Sheet: /Debugger/

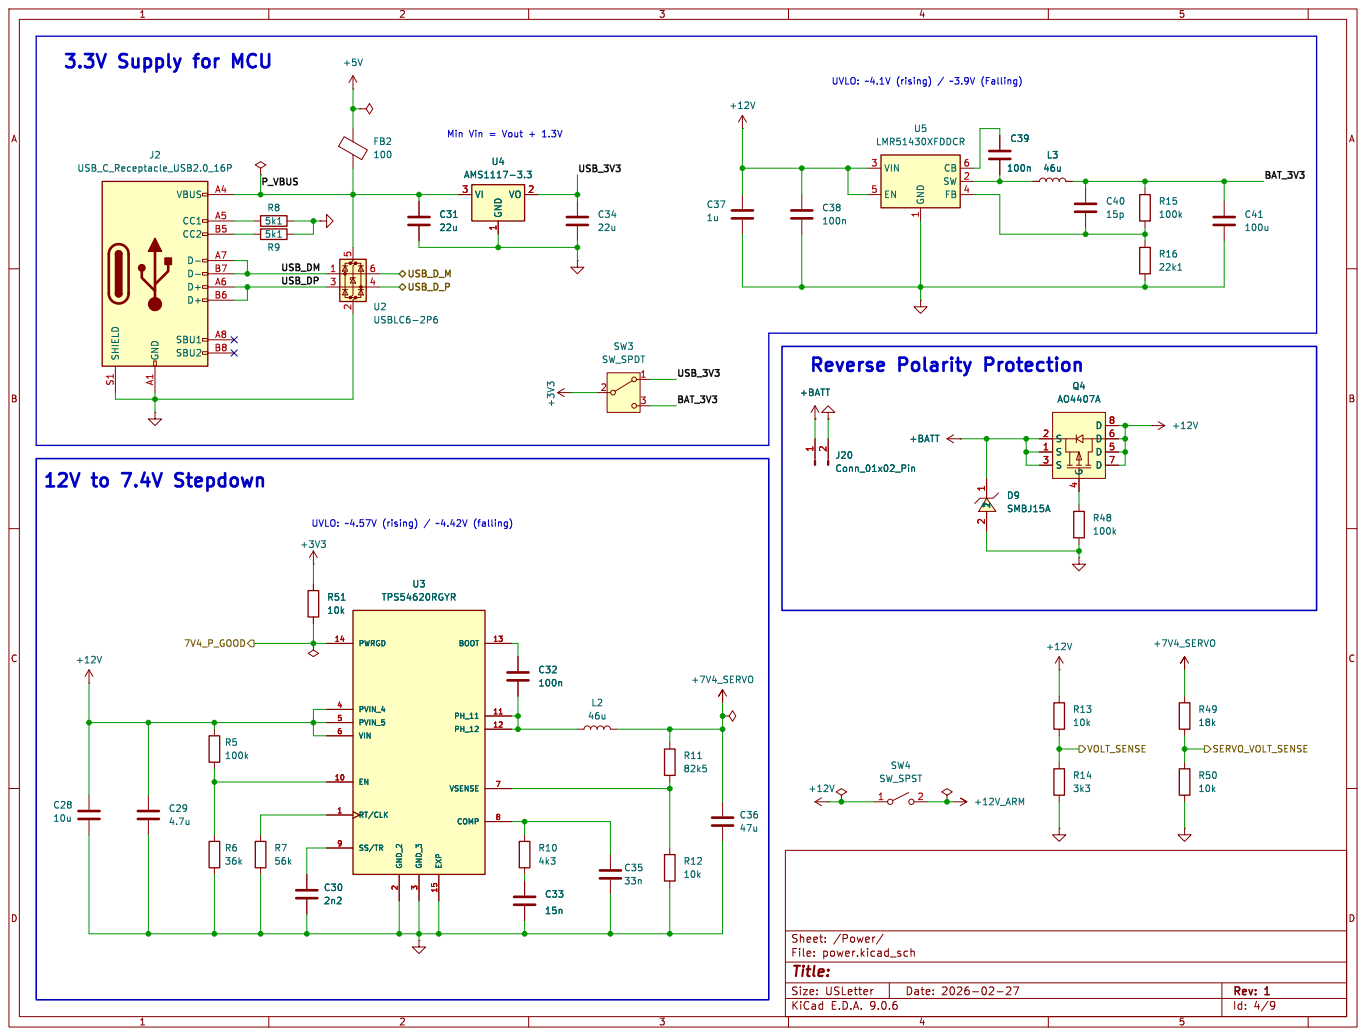
[picture p22: page 4]

3 EXP 15 BOOT 13 PH_11 11 VSENSE 7 COMP 8 PH_12 12 U3 TPS54620RGYR

3 EXP 15 BOOT 13 PH_11 11 VSENSE 7 COMP 8 PH_12 12 R51

Id: 4/9 Title: File: power.kicad_sch Sheet: /Power/

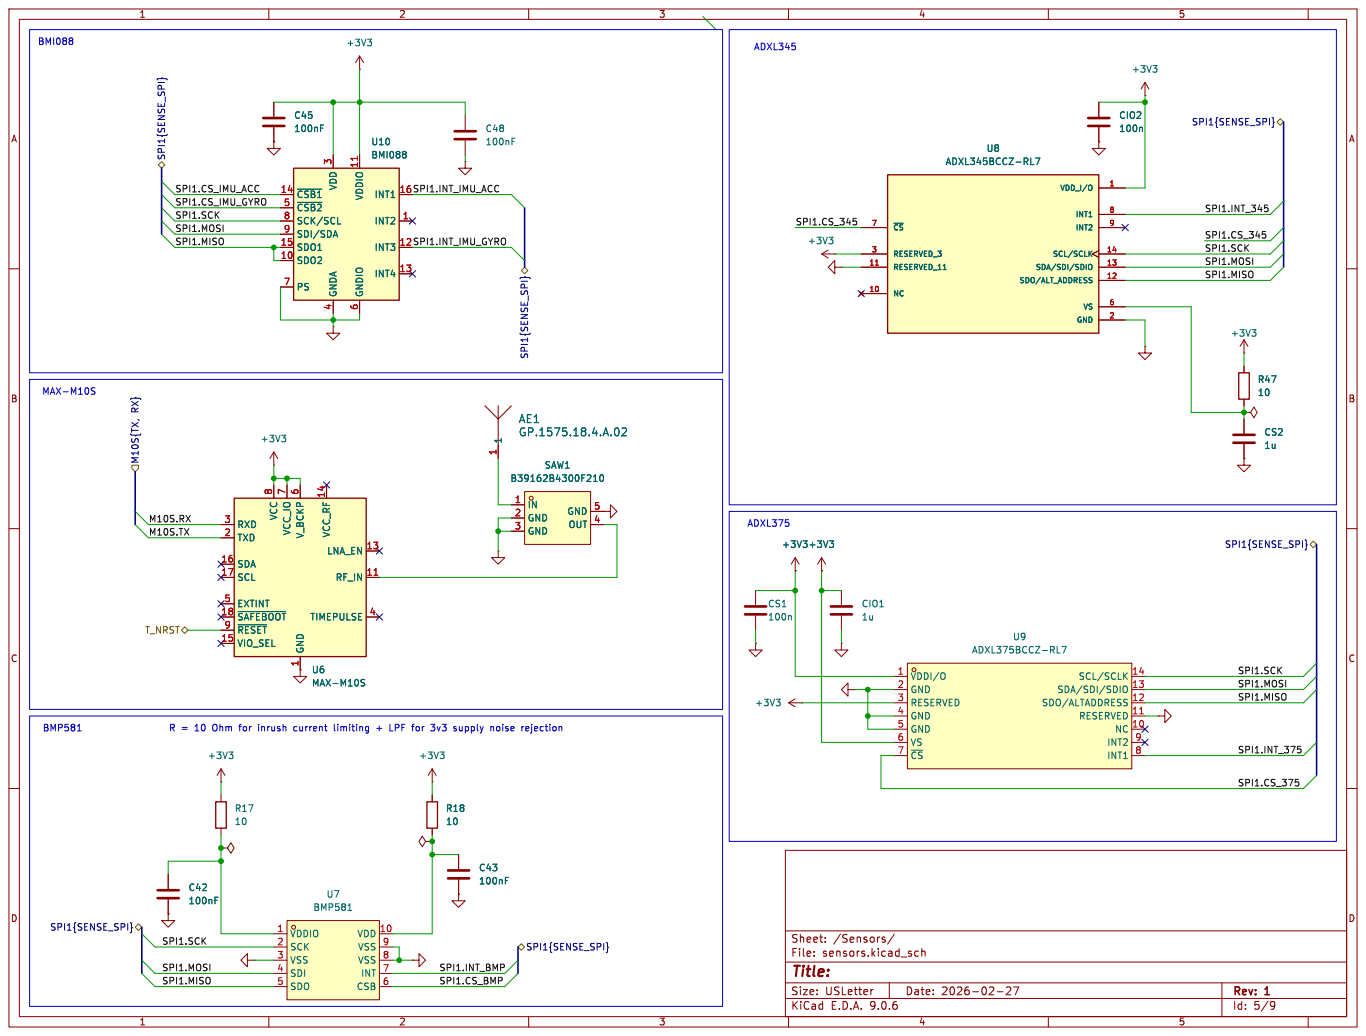
[picture p23: page 5]

Id: 5/9 Title: File: sensors.kicad_sch Sheet: /Sensors/ +3V3 R17

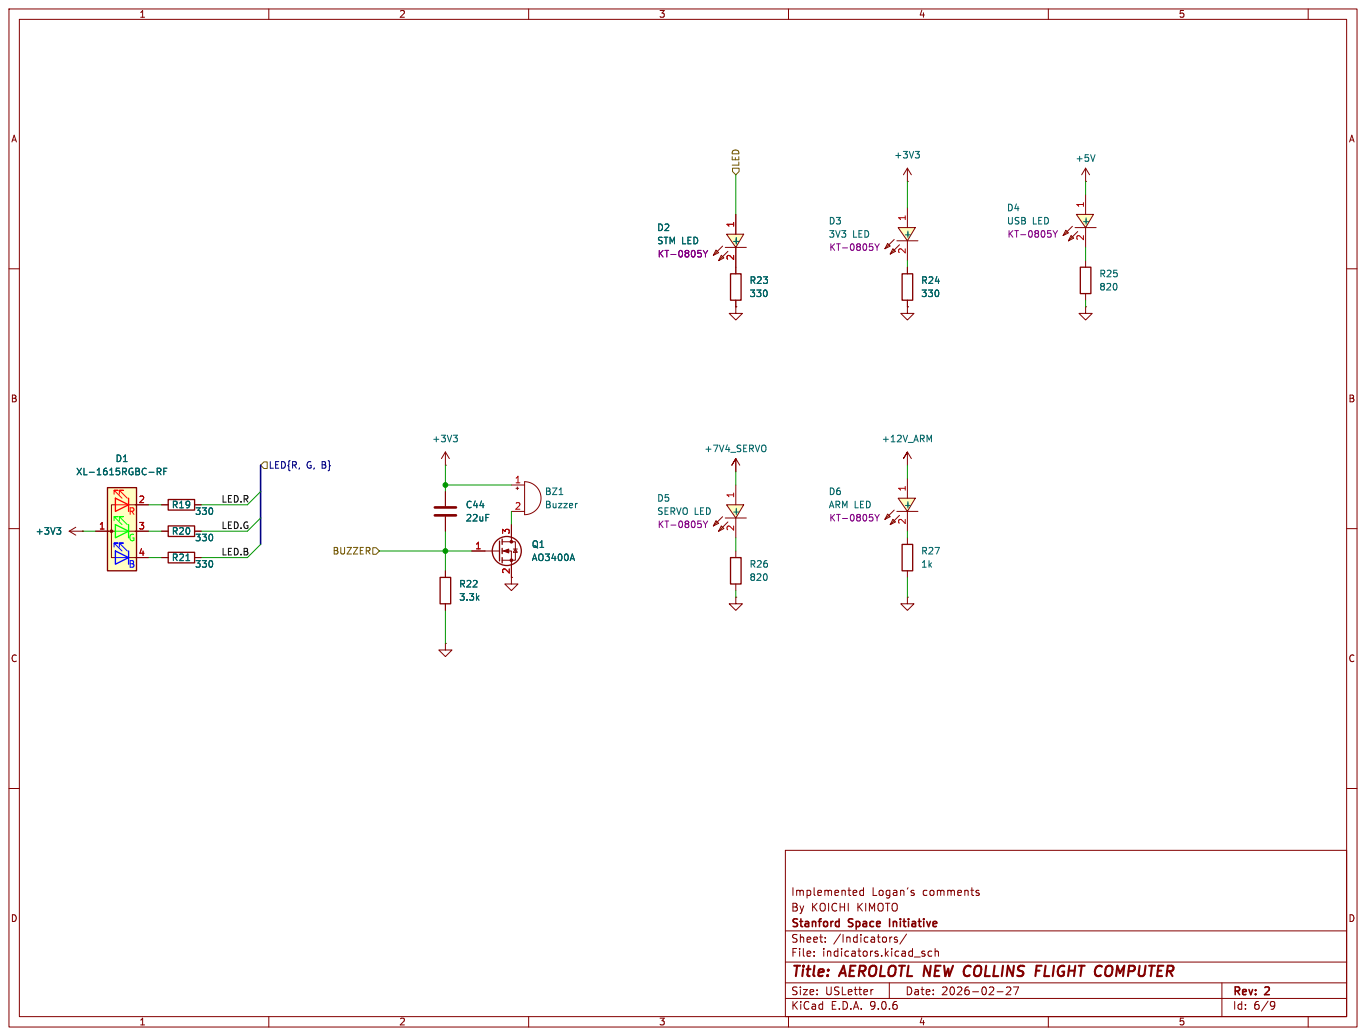
[picture p24: page 6]

Id: 6/9 Title: AEROLOTL NEW COLLINS FLIGHT COMPUTER

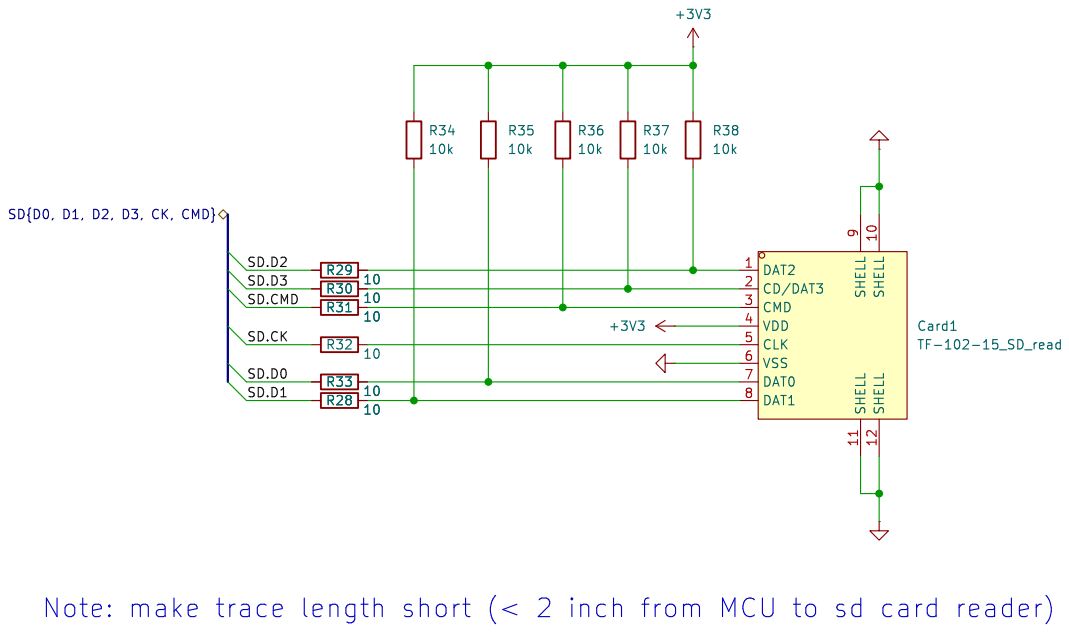
[picture p25: page 7]

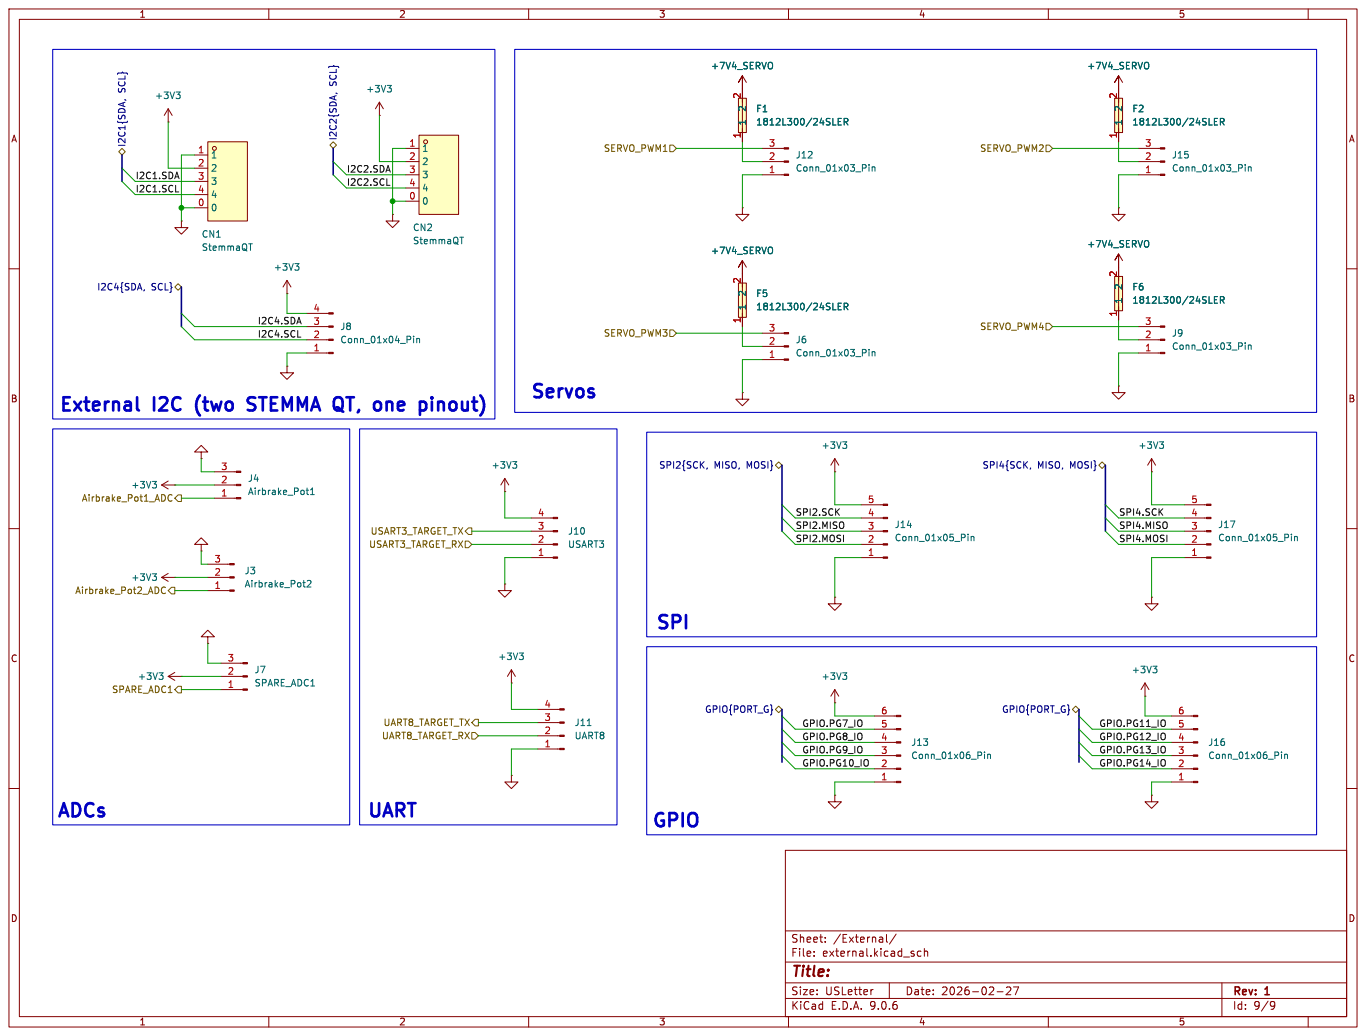
[picture p26: page 8]

External I2C (two STEMMA QT, one pinout)

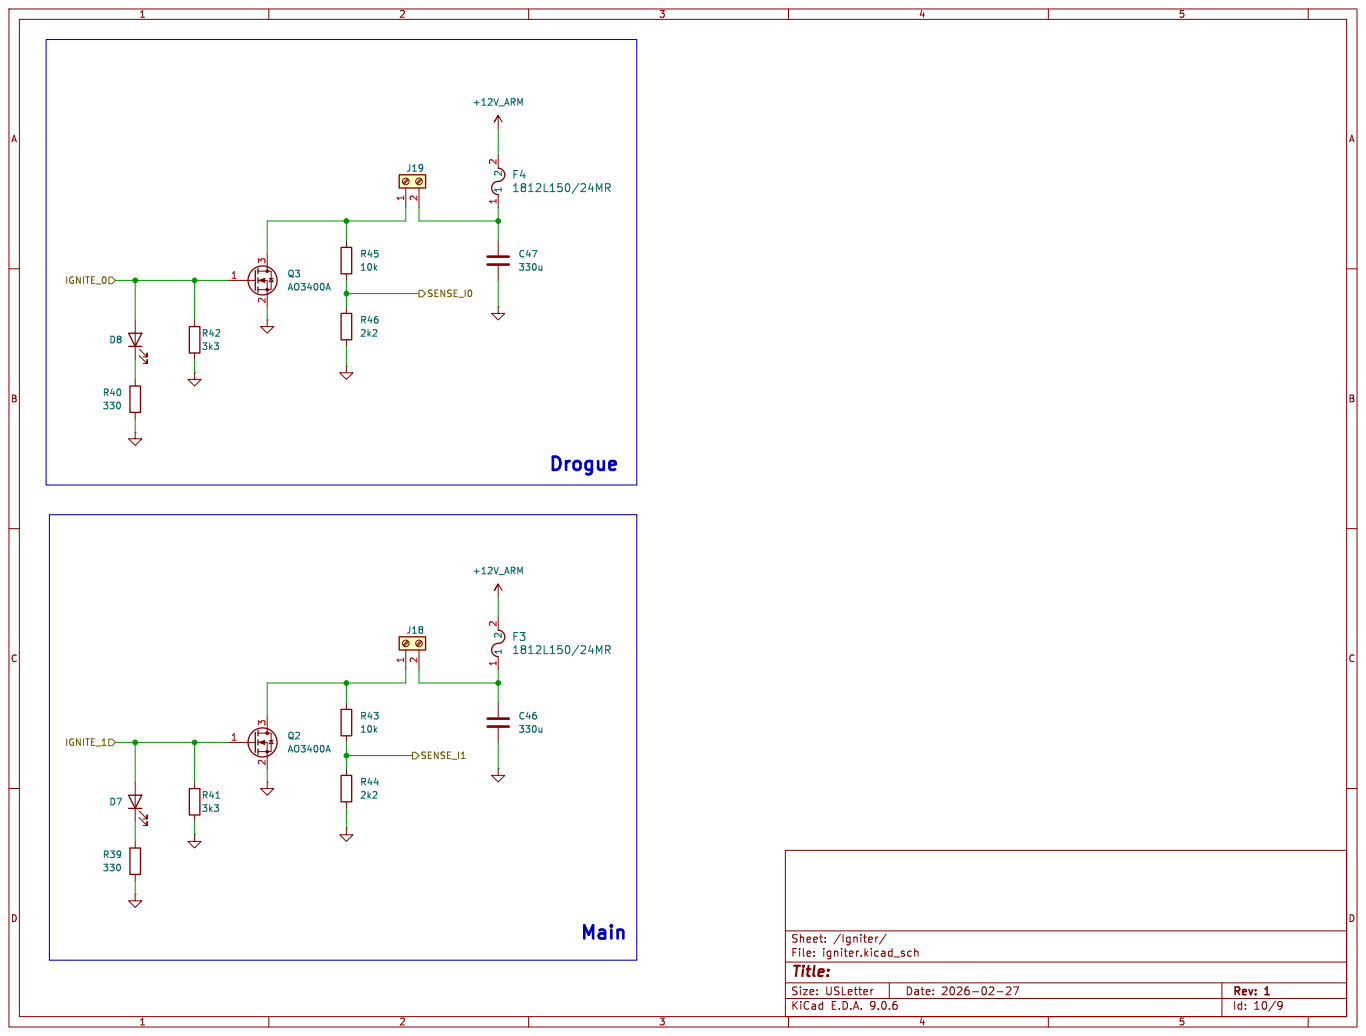
[picture p27: page 9]

Id: 10/9 Title: File: igniter.kicad_sch Sheet: /Igniter/ C46
