stanford-ssi/Aerolotl_KiCAD/revs/aerolotl_rev1.pdf

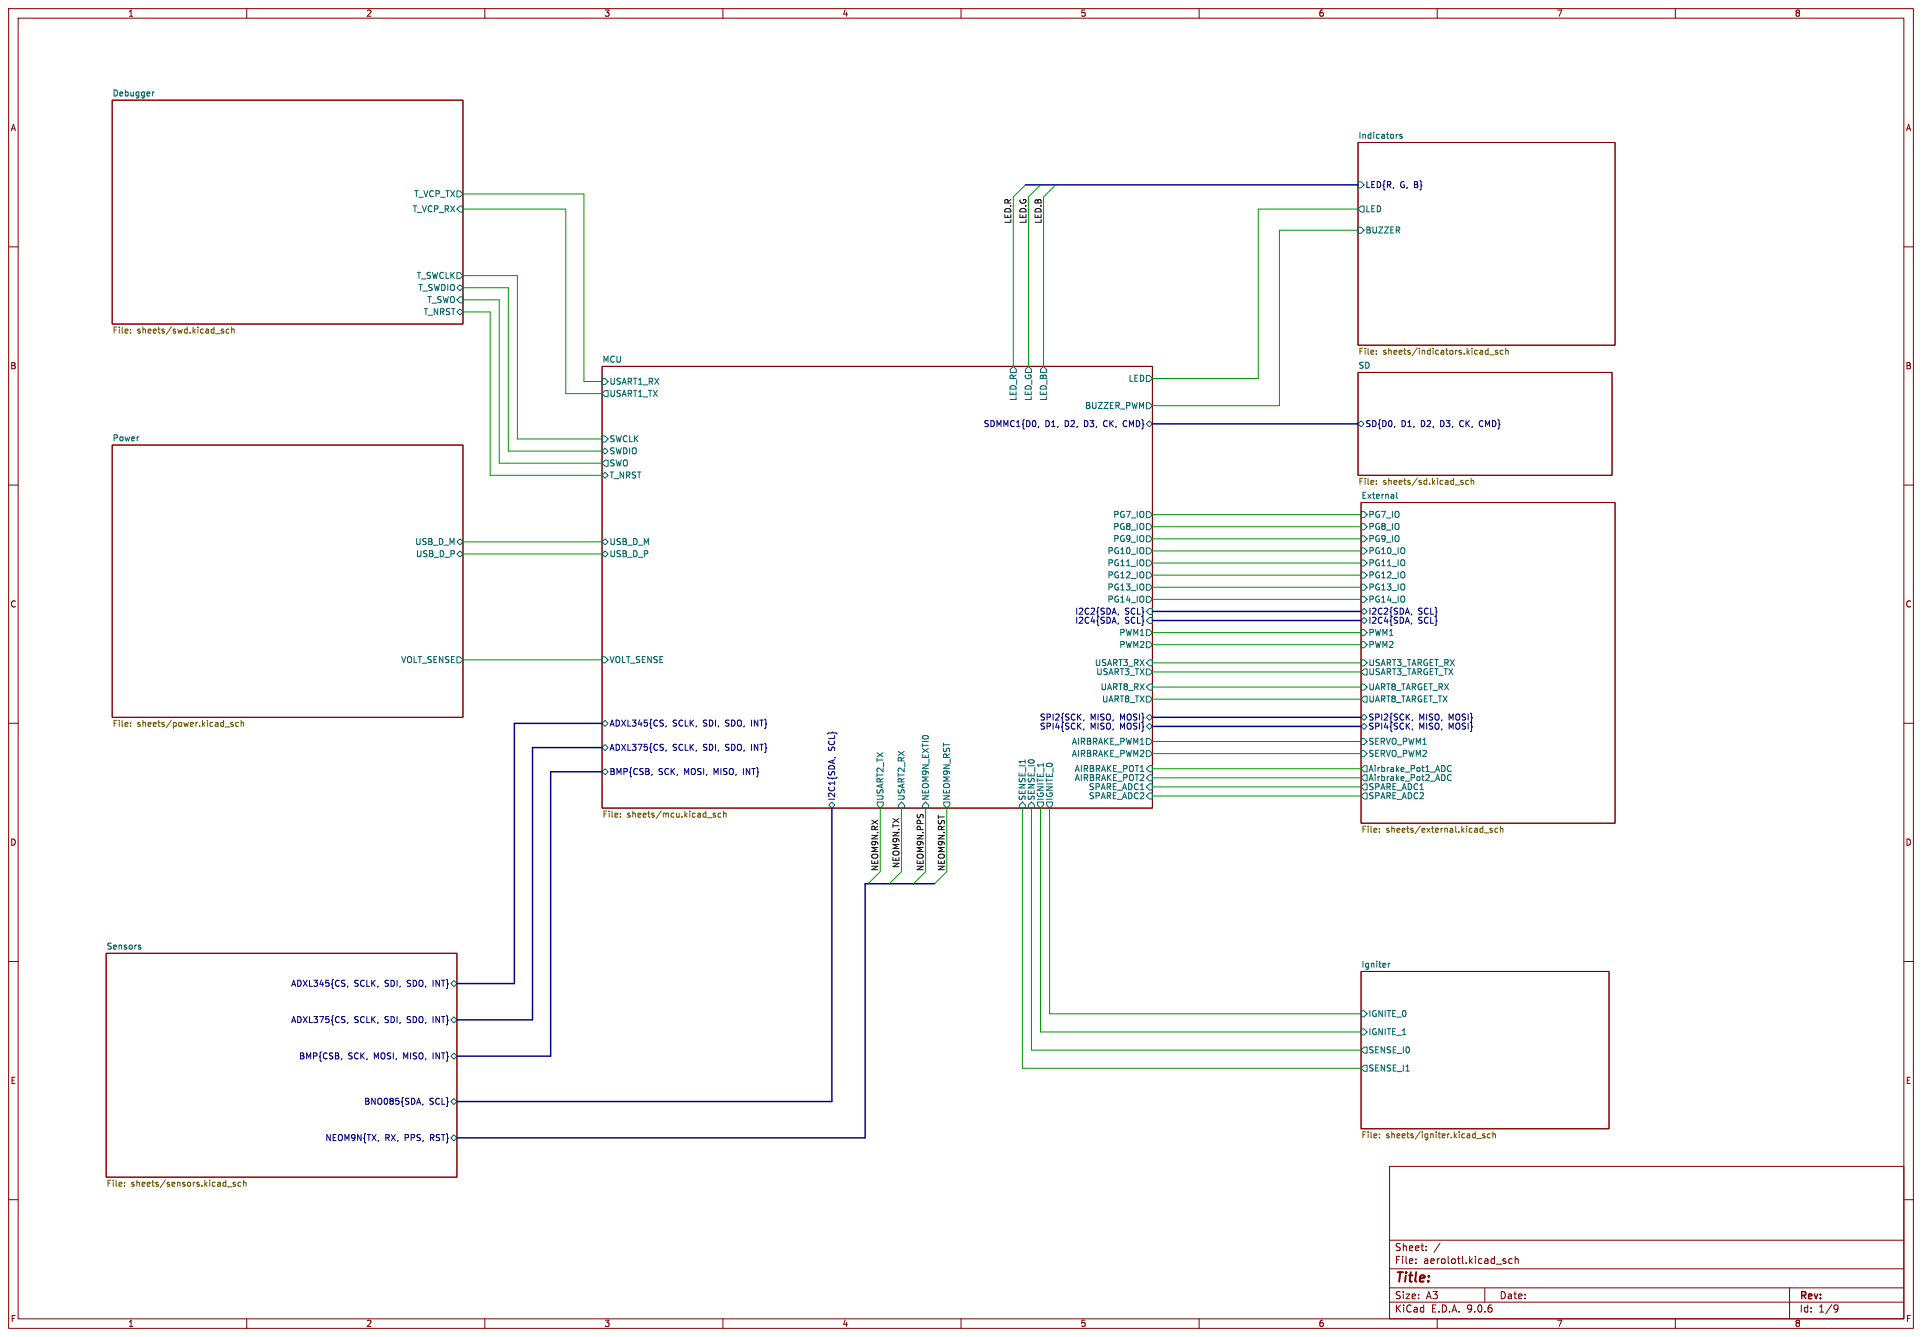
[picture p28: page 1]

Indicators File: sheets/indicators.kicad_sch SD{D0, D1, D2, D3, CK, CMD} SD
SPI4{SCK, MISO, MOSI} LED_R LED_G LED_B
AIRBRAKE_PWM1 AIRBRAKE_PWM2 BUZZER_PWM
SDMMC1{D0, D1, D2, D3, CK, CMD} SENSE_I1 SENSE_I0

ADXL375{CS, SCLK, SDI, SDO, INT} SWCLK
SWDIO
SWO

ADXL345{CS, SCLK, SDI, SDO, INT}

BMP{CSB, SCK, MOSI, MISO, INT}

File: sheets/mcu.kicad_sch BNO085{SDA, SCL}

NEOM9N{TX, RX, PPS, RST} Sensors File: sheets/sensors.kicad_sch

Igniter File: sheets/igniter.kicad_sch

ADXL375{CS, SCLK, SDI, SDO, INT}

Id: 1/9 Title: File: aerolotl.kicad_sch Sheet: /

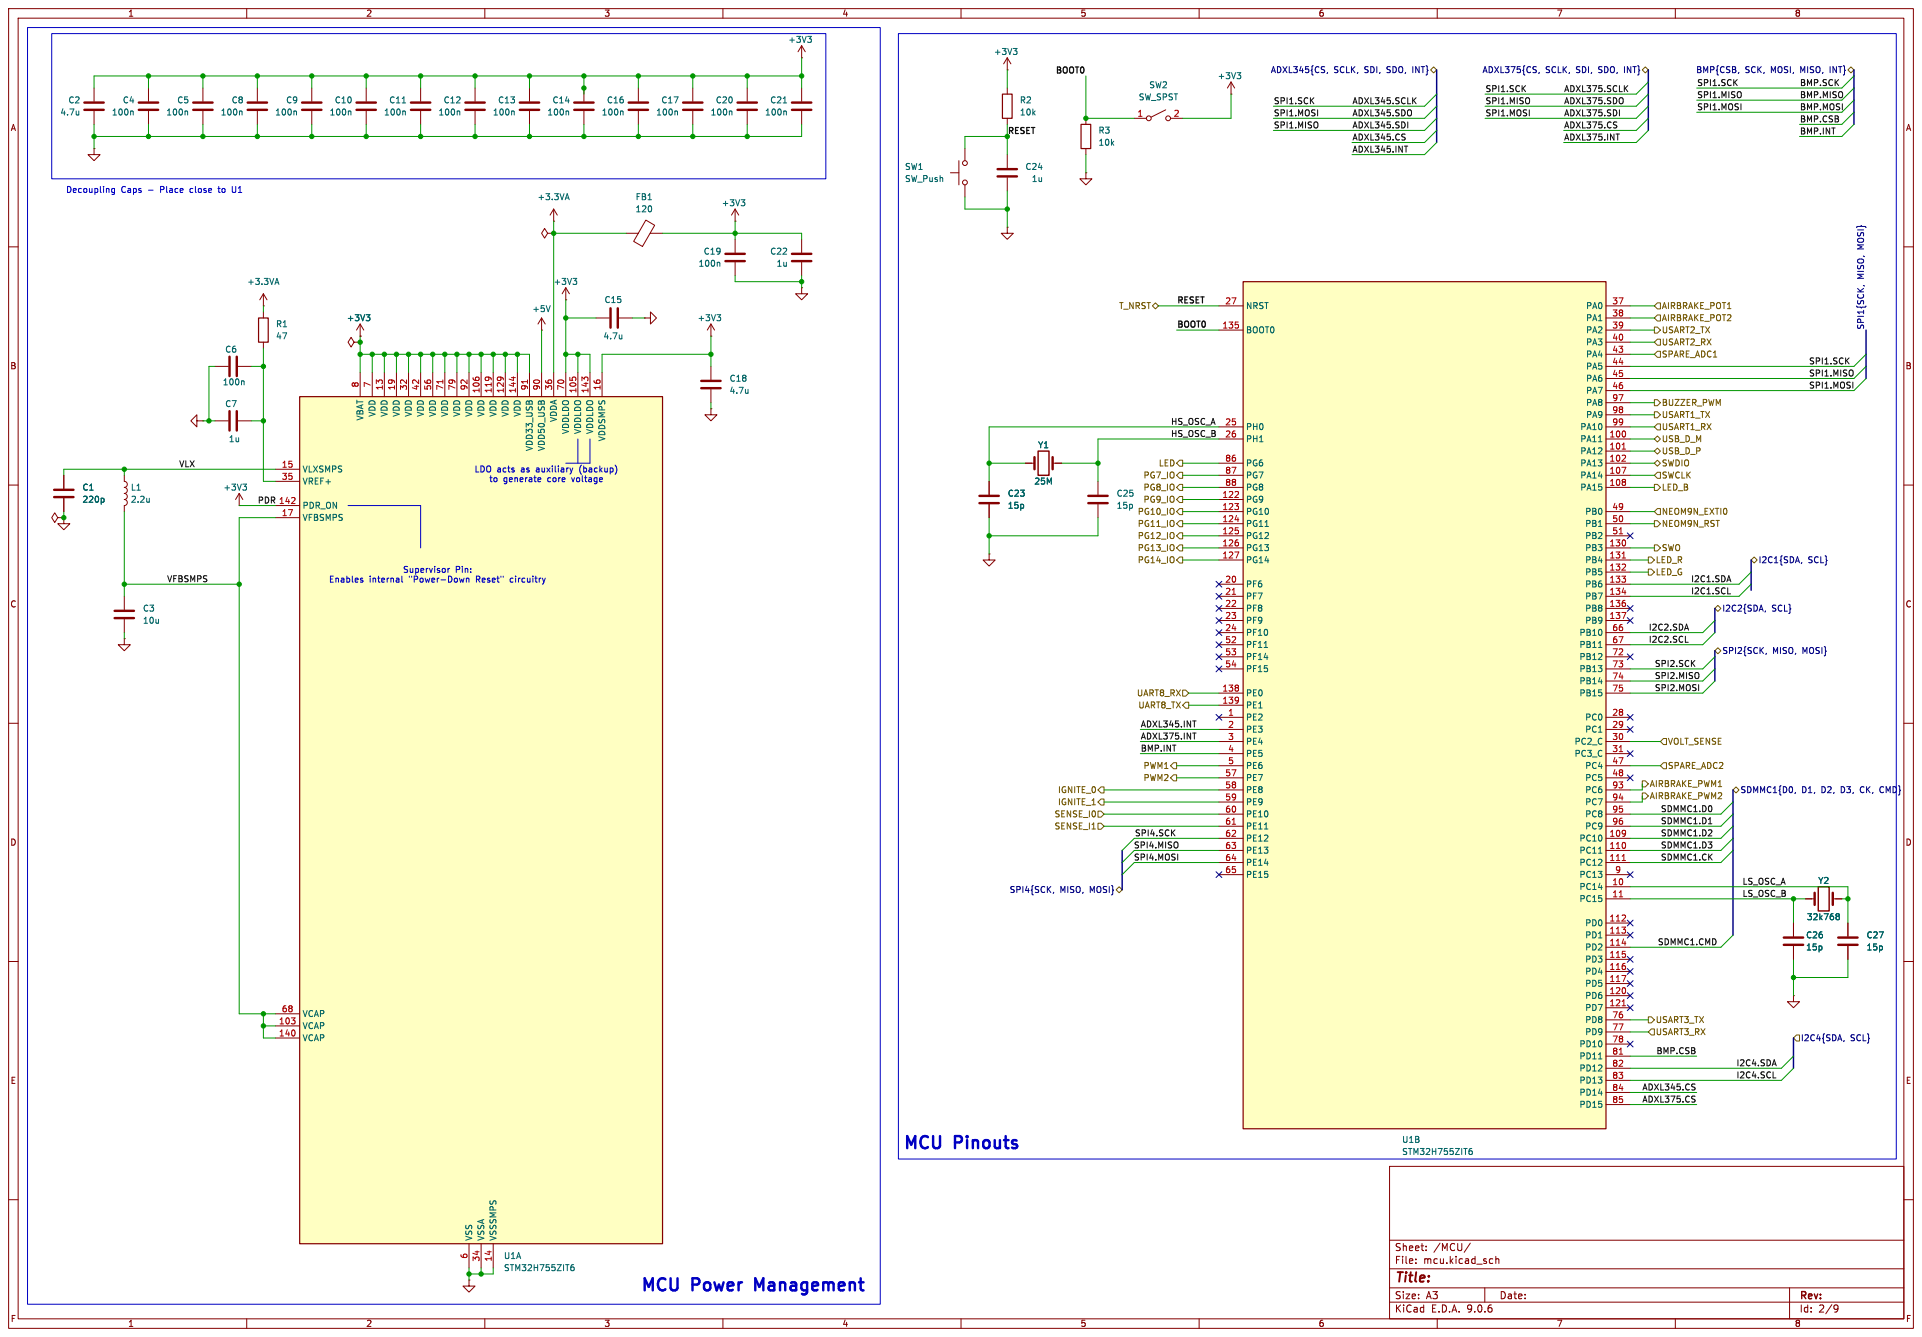
[picture p29: page 2]

ADXL345{CS, SCLK, SDI, SDO, INT} PG7_IO

ADXL375{CS, SCLK, SDI, SDO, INT}
SPI1.SCK
SPI1.MISO

BMP{CSB, SCK, MOSI, MISO, INT} AIRBRAKE_POT1 SWO

7 VDD 13 VDD 19 VDD 32 VDD 42 VDD 56 VDD 71 VDD 79 VDD 92 VSS

6 VDD 106 VSSA 34 VDD 119 VSSSMPS 14 VDD 129 VDD 144 VDD33_USB 91 VDD50_USB 90 VDDA 36 VDDLDO 70 VDDLDO 105 VDDLDO 143 VDDSMPS 16 U1A

to generate core voltage

Id: 2/9 Title: File: mcu.kicad_sch Sheet: /MCU/

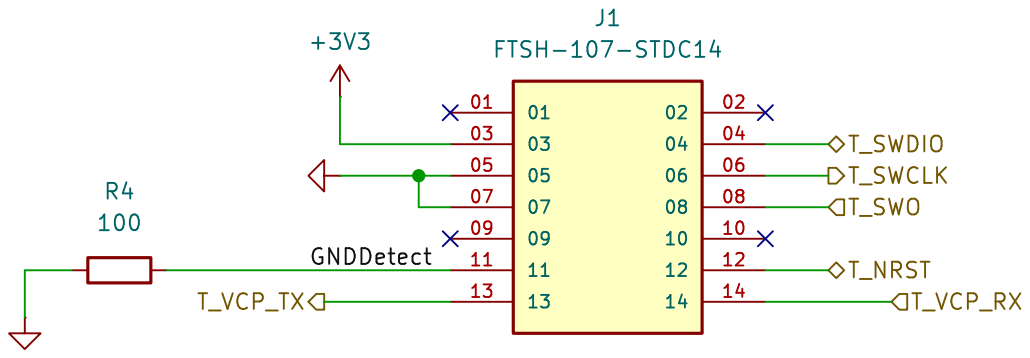
[picture p30: page 3]

Id: 3/9 Title: File: swd.kicad_sch Sheet: /Debugger/

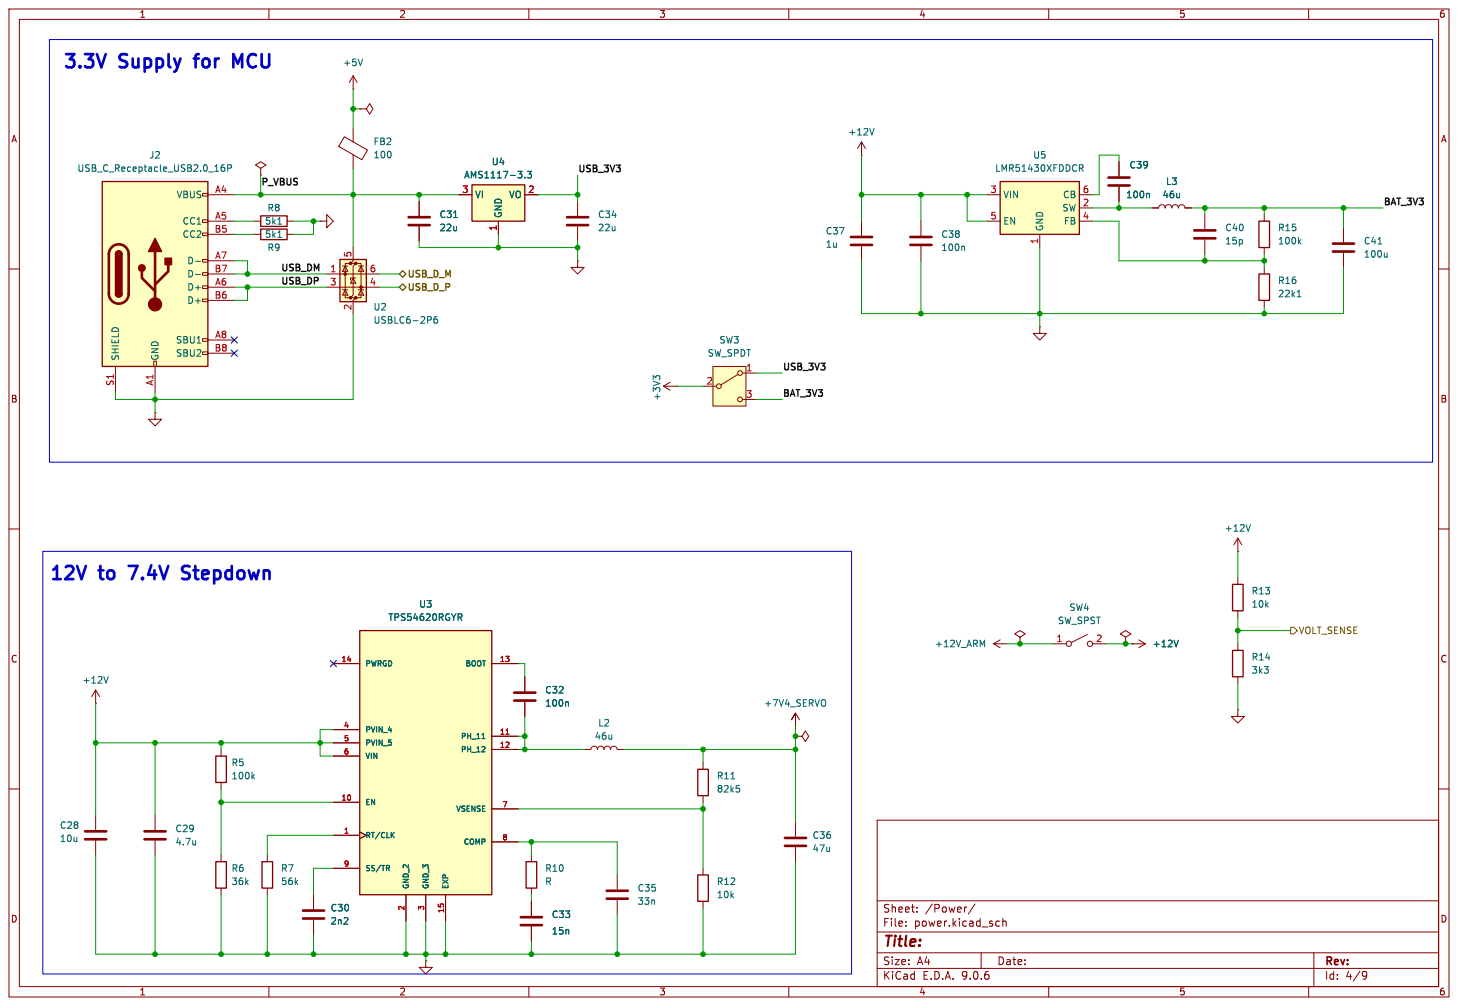
[picture p31: page 4]

3 EXP 15 BOOT 13 PH_11 11 VSENSE 7 COMP 8 PH_12 12 U3 TPS54620RGYR

3 EXP 15 BOOT 13 PH_11 11 VSENSE 7 COMP 8 PH_12 12 C32

Id: 4/9 Title: File: power.kicad_sch Sheet: /Power/

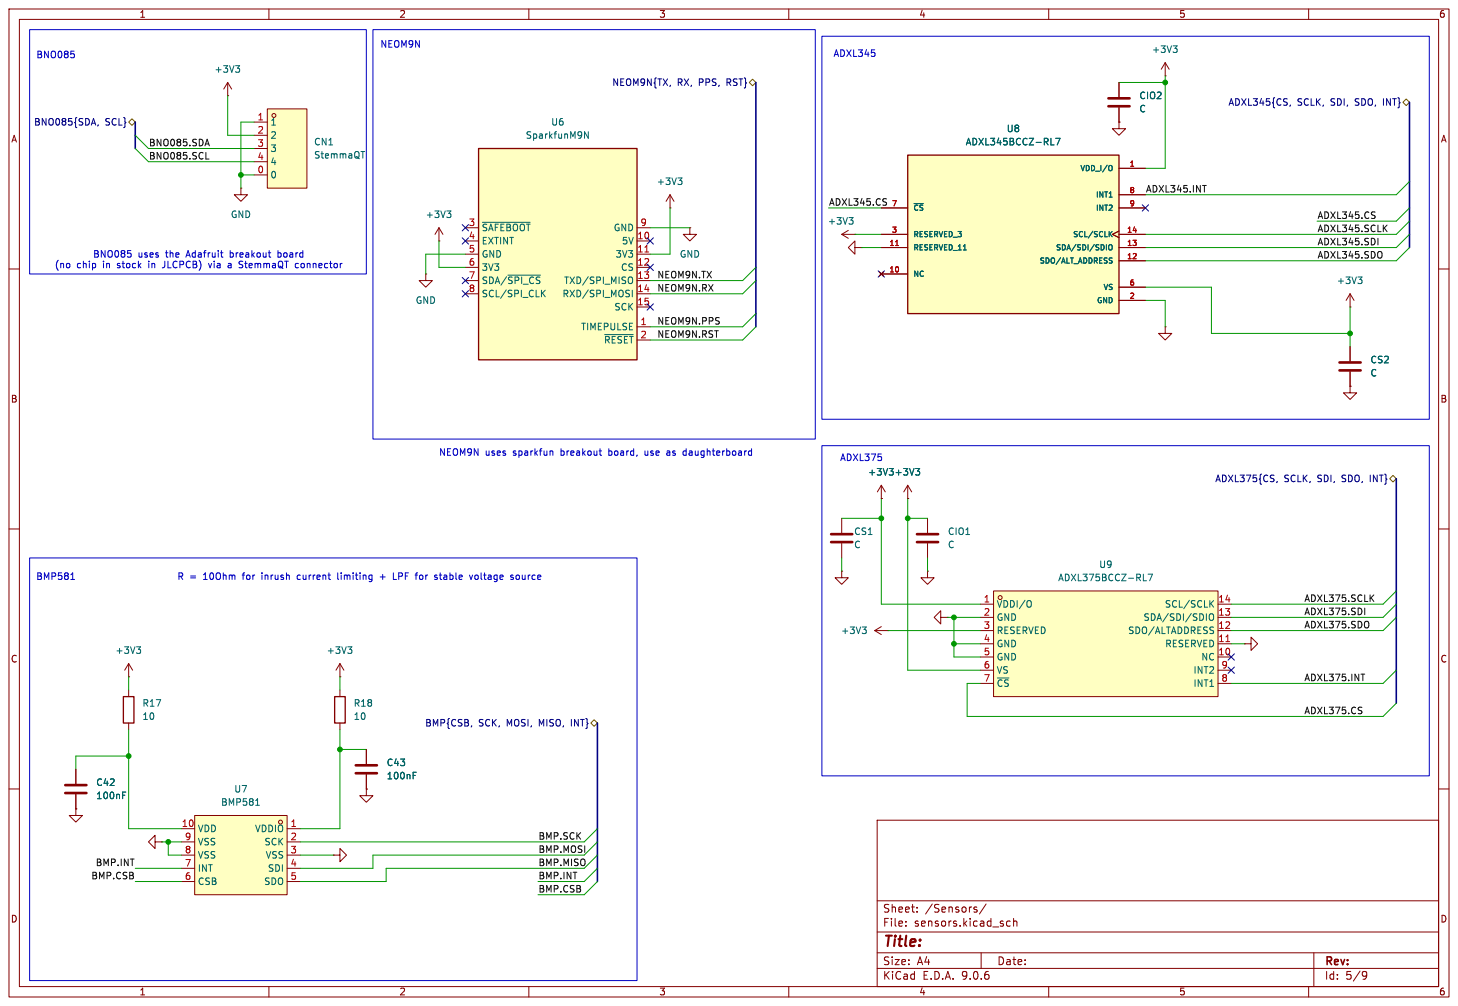
[picture p32: page 5]

ADXL345{CS, SCLK, SDI, SDO, INT}

ADXL375{CS, SCLK, SDI, SDO, INT}

ADXL375.INT BMP.MOSI BMP.MISO

BMP{CSB, SCK, MOSI, MISO, INT}

Id: 5/9 Title: File: sensors.kicad_sch Sheet: /Sensors/

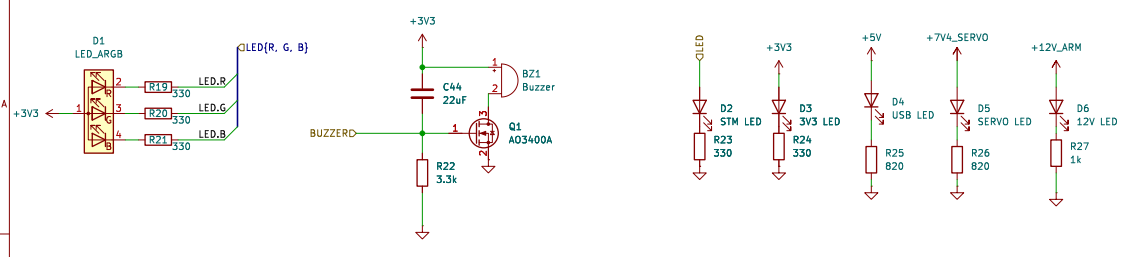
[picture p33: page 6]

Id: 6/9 Title: File: indicators.kicad_sch Sheet: /Indicators/

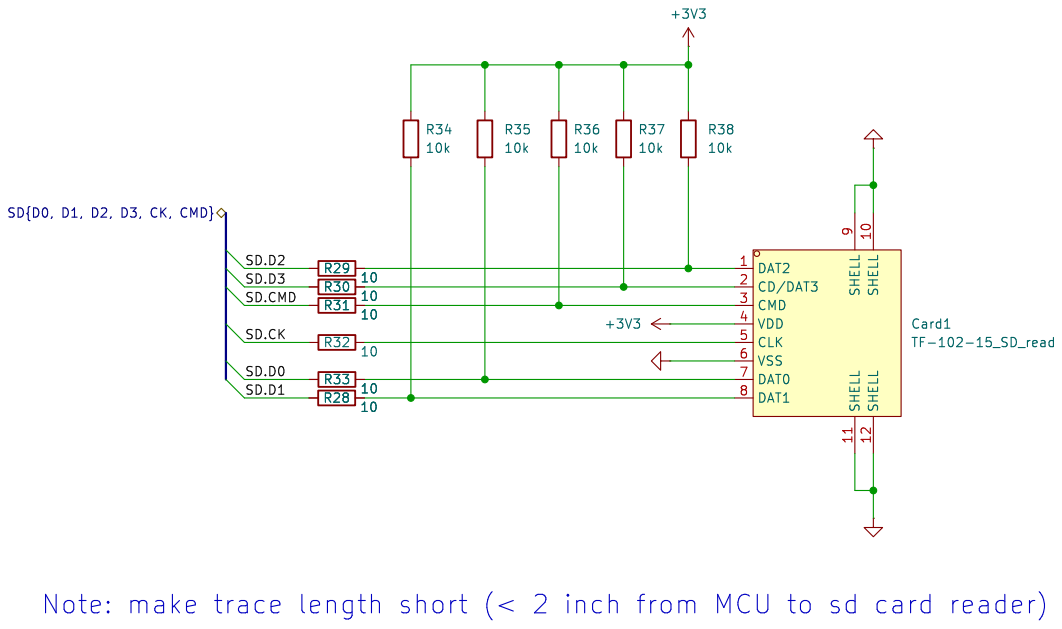
[picture p34: page 7]

9 SHELL 11 SHELL 10 SHELL 12 Card1 TF-102-15_SD_read R29
Id: 8/9 Title: File: sd.kicad_sch Sheet: /SD/ R31

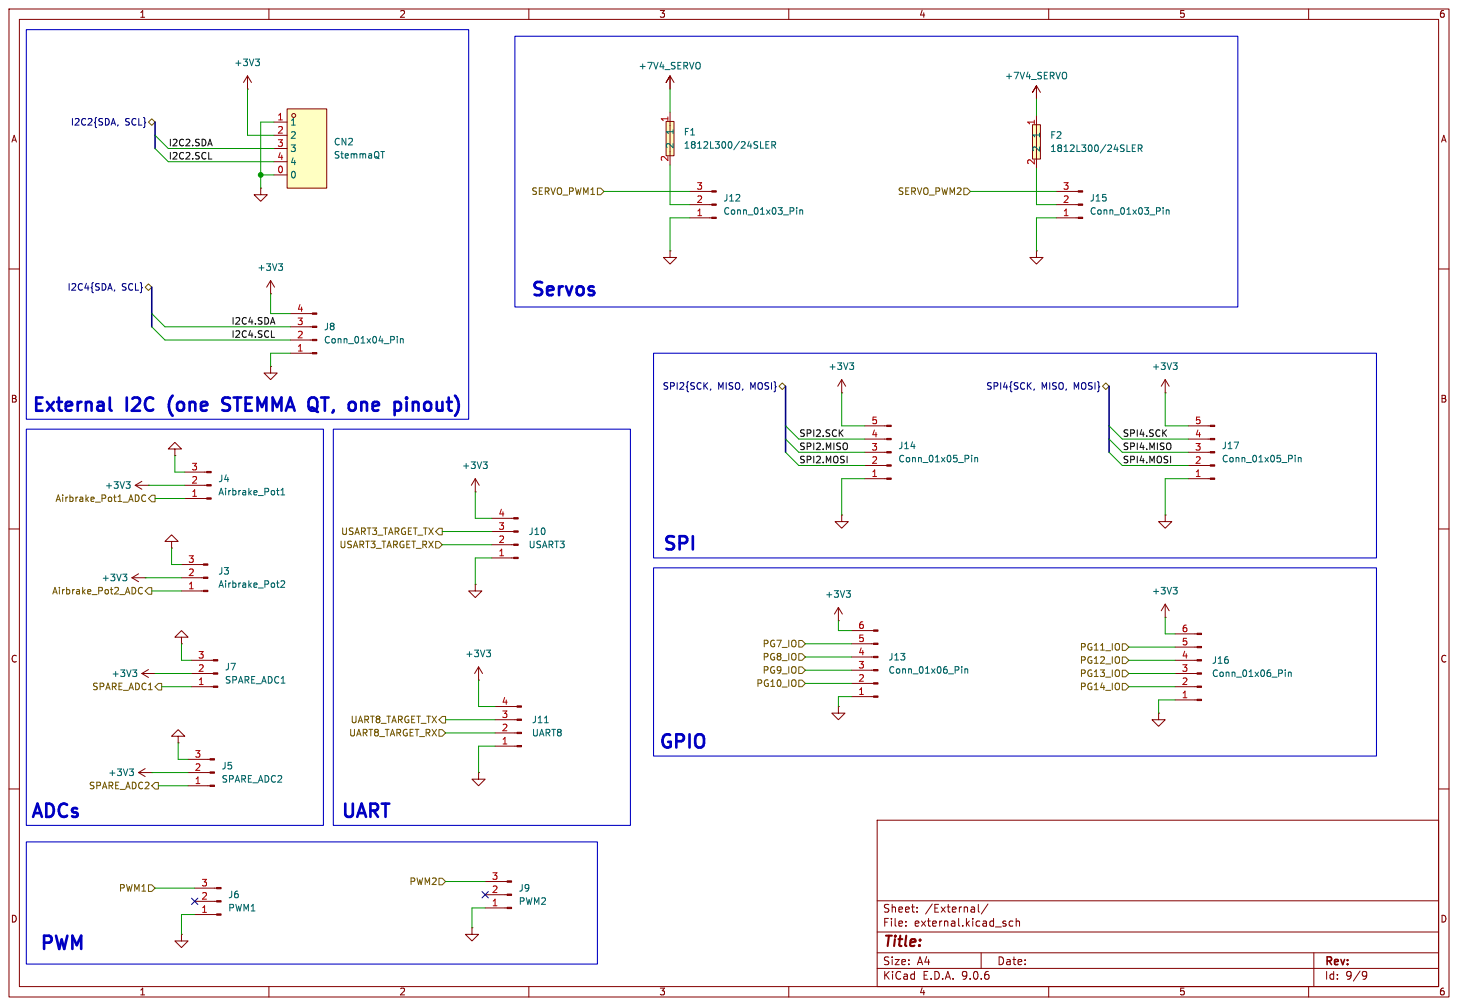
[picture p35: page 8]

External I2C (one STEMMA QT, one pinout)

Id: 9/9 Title: File: external.kicad_sch Sheet: /External/

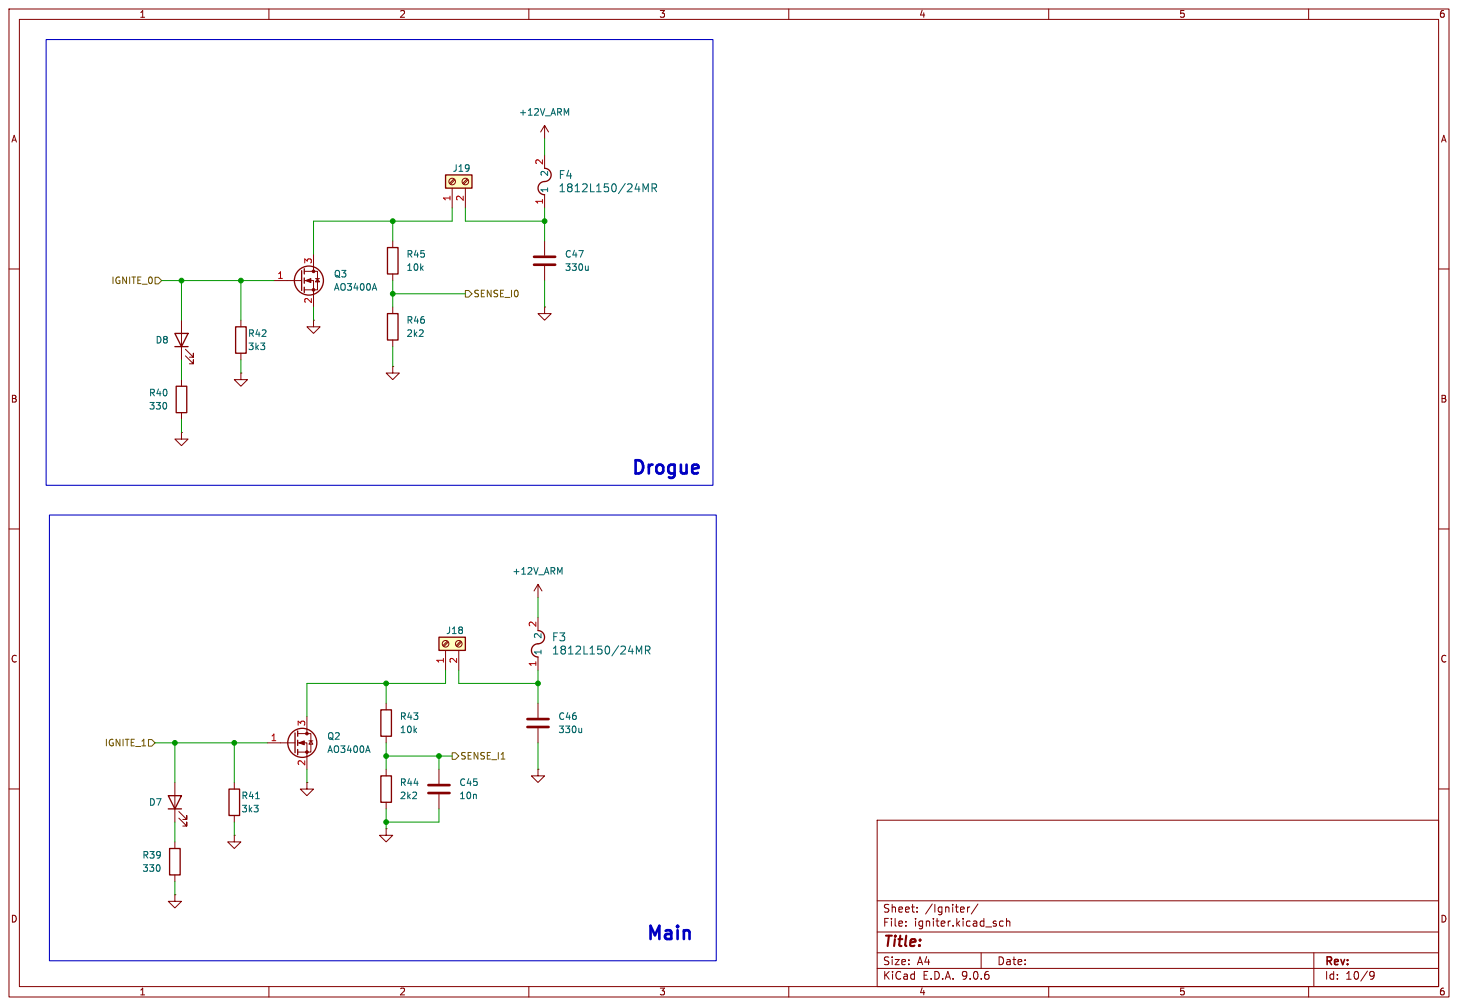
[picture p36: page 9]

Id: 10/9 Title: File: igniter.kicad_sch Sheet: /Igniter/
