stanford-ssi/Aerolotl_KiCAD/BatteryPCB_30pin/battery_pcb_30pin.kicad_pcb

## KiCad design BatteryPCB_30pin/battery_pcb_30pin.kicad_pcb (2026-10-12)

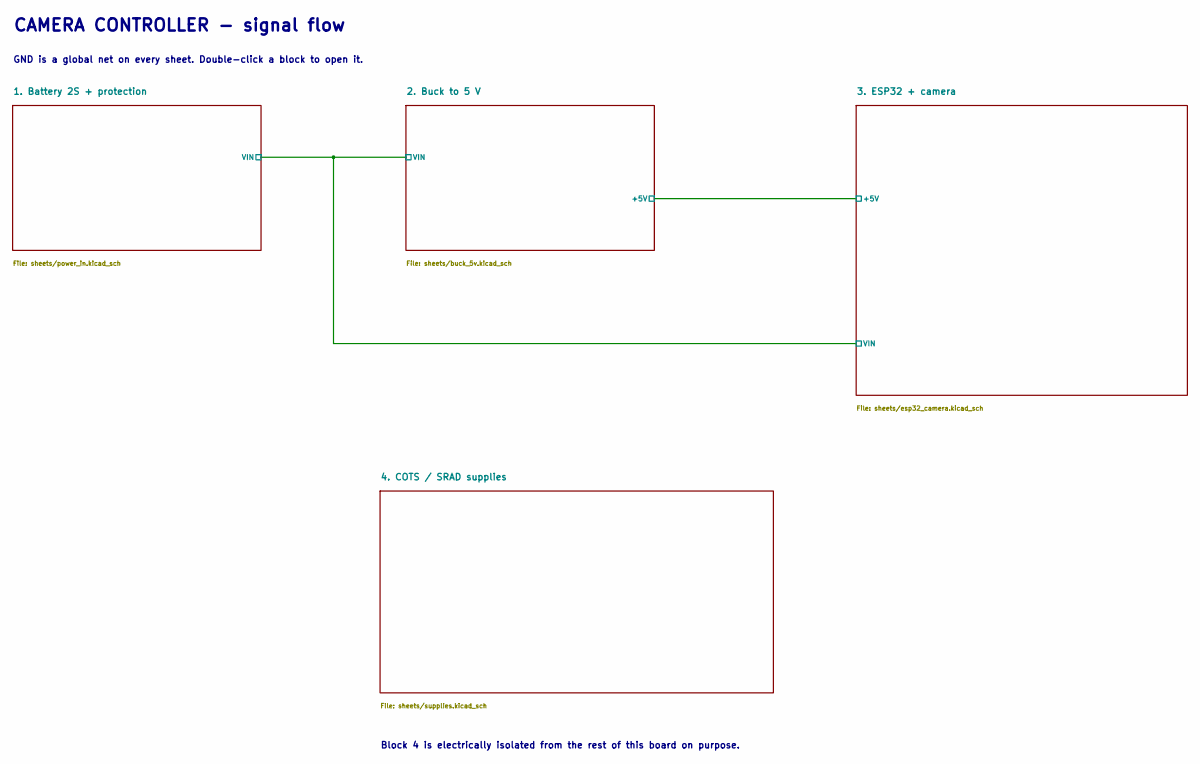
[picture p37: schematic battery_pcb_30pin.kicad_sch, Battery PCB - AV bay power, arming and camera]

Notes on the sheet:
CAMERA CONTROLLER - signal flow
GND is a global net on every sheet. Double-click a block to open it.
Block 4 is electrically isolated from the rest of this board on purpose.

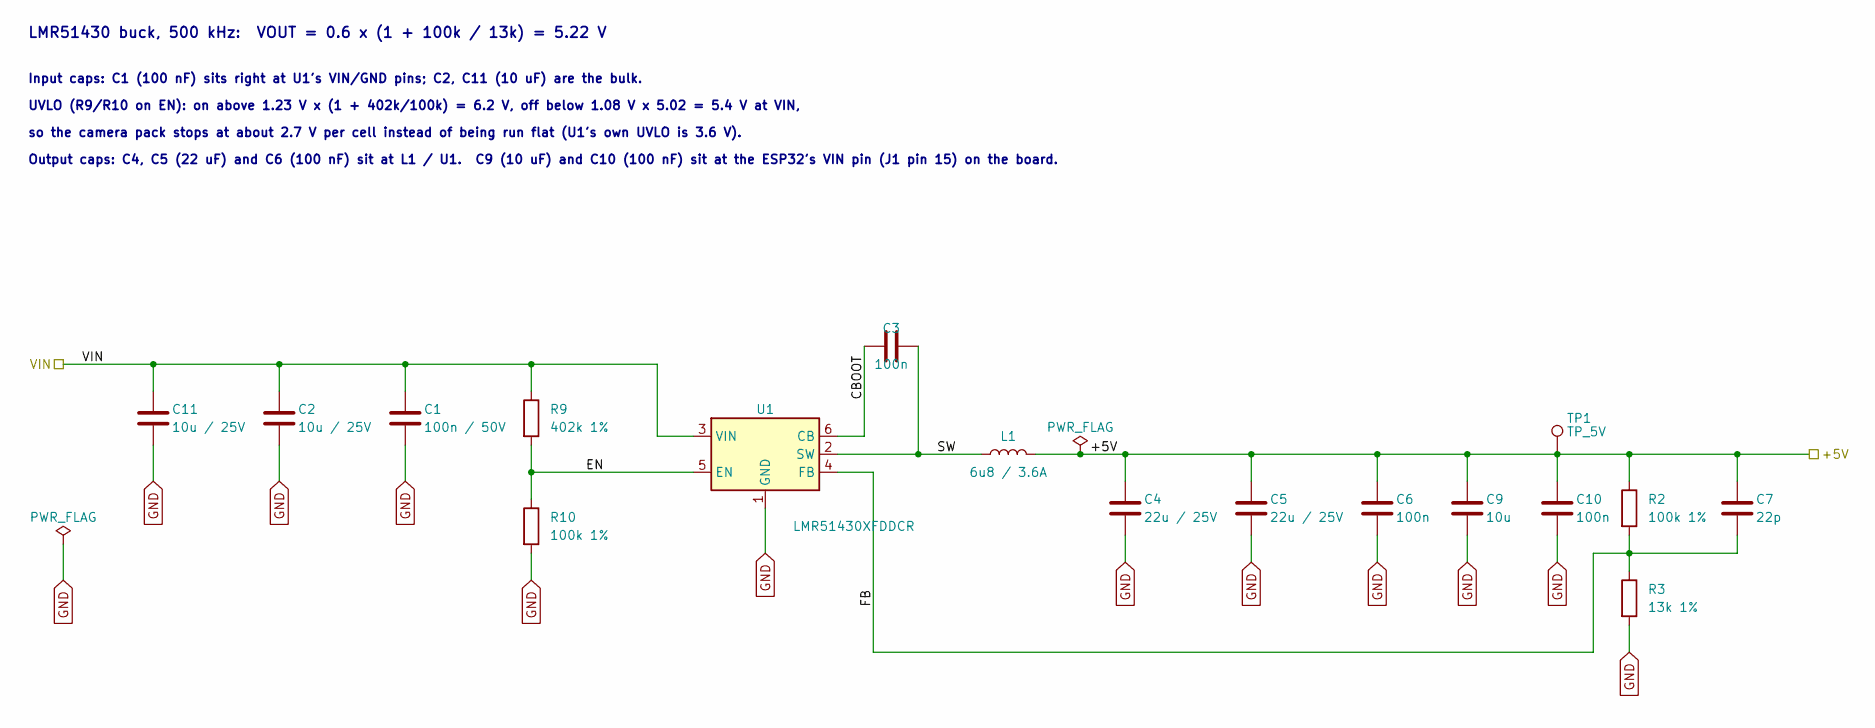
[picture p38: schematic buck_5v.kicad_sch, 2. Buck 8.4 V -> 5.0 V]

Parts:
C1: 100n / 50V; C_0805_2012Metric; MPN CC0805KRX7R9BB104; LCSC C49678
C2, C11: 10u / 25V; C_0805_2012Metric; MPN CL21A106KAYNNNE
C3, C6, C10: 100n; C_0603_1608Metric; MPN CL10B104KB8NNNC
C4, C5: 22u / 25V; C_0805_2012Metric; MPN CL21A226MAQNNNE; LCSC C45783
C7: 22p; C_0603_1608Metric; MPN CL10C220JB8NNNC
C9: 10u; C_0805_2012Metric; MPN CL21A106KAYNNNE
L1: 6u8 / 3.6A; L_Bourns_SRN6045TA; MPN SRN6045TA-6R8M
R2, R10: 100k 1%; R_0603_1608Metric; MPN RC0603FR-07100KL
R3: 13k 1%; R_0603_1608Metric; MPN RC0603FR-0713KL
R9: 402k 1%; R_0603_1608Metric; MPN RC0603FR-07402KL
TP1: TP_5V; TestPoint_THTPad_D2.0mm_Drill1.0mm
U1: LMR51430XFDDCR; SOT-23-6; MPN LMR51430XFDDCR

Connections:
/1. Battery 2S + protection/VIN: C1.1, C2.1, C11.1, R9.1, U1.3 (VIN); also elsewhere on the board
/2. Buck to 5 V/+5V: C4.1, C5.1, C6.1, C7.1, C9.1, C10.1, L1.2, R2.1, TP1.1 (1_1); also elsewhere on the board
/2. Buck to 5 V/CBOOT: C3.1, U1.6 (CB)
/2. Buck to 5 V/EN: R9.2, R10.1, U1.5 (EN)
/2. Buck to 5 V/FB: C7.2, R2.2, R3.1, U1.4 (FB)
/2. Buck to 5 V/SW: C3.2, L1.1, U1.2 (SW)
GND: C1.2, C2.2, C4.2, C5.2, C6.2, C9.2, C10.2, C11.2, R3.2, R10.2, U1.1 (GND); also elsewhere on the board

Notes on the sheet:
UVLO (R9/R10 on EN): on above 1.23 V x (1 + 402k/100k) = 6.2 V, off below 1.08 V x 5.02 = 5.4 V at VIN,
LMR51430 buck, 500 kHz: VOUT = 0.6 x (1 + 100k / 13k) = 5.22 V
Output caps: C4, C5 (22 uF) and C6 (100 nF) sit at L1 / U1. C9 (10 uF) and C10 (100 nF) sit at the ESP32's VIN pin (J1 pin 15) on the board.
so the camera pack stops at about 2.7 V per cell instead of being run flat (U1's own UVLO is 3.6 V).
Input caps: C1 (100 nF) sits right at U1's VIN/GND pins; C2, C11 (10 uF) are the bulk.

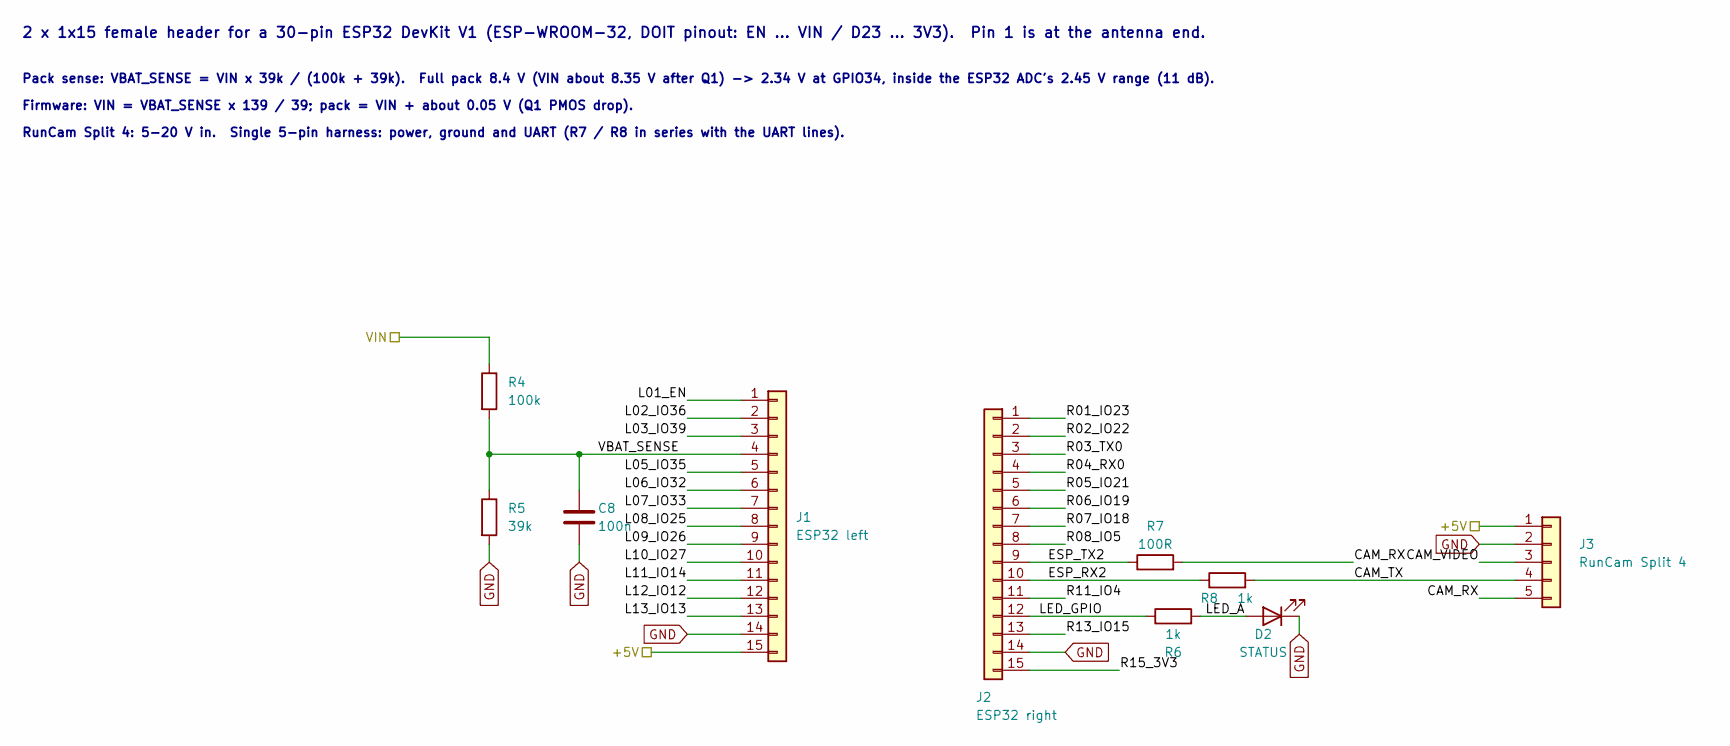
[picture p39: schematic esp32_camera.kicad_sch, 3. ESP32 DevKit V1 (30-pin) socket + RunCam Split 4]

Parts:
C8: 100n; C_0603_1608Metric; MPN CL10B104KB8NNNC
D2: STATUS; LED_0805_2012Metric; MPN NCD0805R1; LCSC C84256
J1: ESP32 left; PinSocket_1x15_P2.54mm_Vertical; MPN PPTC151LFBN-RC
J2: ESP32 right; PinSocket_1x15_P2.54mm_Vertical; MPN PPTC151LFBN-RC
J3: RunCam Split 4; JST_GH_BM05B-GHS-TBT_1x05-1MP_P1.25mm_Vertical; MPN BM05B-GHS-TBT
R4: 100k; R_0603_1608Metric; MPN RC0603FR-07100KL
R5: 39k; R_0603_1608Metric; MPN RC0603FR-0739KL
R6, R8: 1k; R_0603_1608Metric; MPN RC0603FR-071KL
R7: 100R; R_0603_1608Metric; MPN RC0603FR-07100RL

Connections:
/1. Battery 2S + protection/VIN: R4.1; also elsewhere on the board
/2. Buck to 5 V/+5V: J1.15, J3.1; also elsewhere on the board
/3. ESP32 + camera/CAM_RX: J3.5, R7.2
/3. ESP32 + camera/CAM_TX: J3.4, R8.2
/3. ESP32 + camera/CAM_VIDEO: J3.3
/3. ESP32 + camera/ESP_RX2: J2.10, R8.1
/3. ESP32 + camera/ESP_TX2: J2.9, R7.1
/3. ESP32 + camera/L01_EN: J1.1
/3. ESP32 + camera/L02_IO36: J1.2
/3. ESP32 + camera/L03_IO39: J1.3
/3. ESP32 + camera/L05_IO35: J1.5
/3. ESP32 + camera/L06_IO32: J1.6
/3. ESP32 + camera/L07_IO33: J1.7
/3. ESP32 + camera/L08_IO25: J1.8
/3. ESP32 + camera/L09_IO26: J1.9
/3. ESP32 + camera/L10_IO27: J1.10
/3. ESP32 + camera/L11_IO14: J1.11
/3. ESP32 + camera/L12_IO12: J1.12
/3. ESP32 + camera/L13_IO13: J1.13
/3. ESP32 + camera/LED_A: D2.2 (A), R6.2
/3. ESP32 + camera/LED_GPIO: J2.12, R6.1
/3. ESP32 + camera/R01_IO23: J2.1
/3. ESP32 + camera/R02_IO22: J2.2
/3. ESP32 + camera/R03_TX0: J2.3
/3. ESP32 + camera/R04_RX0: J2.4
/3. ESP32 + camera/R05_IO21: J2.5
/3. ESP32 + camera/R06_IO19: J2.6
/3. ESP32 + camera/R07_IO18: J2.7
/3. ESP32 + camera/R08_IO5: J2.8
/3. ESP32 + camera/R11_IO4: J2.11
/3. ESP32 + camera/R13_IO15: J2.13
/3. ESP32 + camera/R15_3V3: J2.15
/3. ESP32 + camera/VBAT_SENSE: C8.1, J1.4, R4.2, R5.1
GND: C8.2, D2.1 (K), J1.14, J2.14, J3.2, R5.2; also elsewhere on the board

Notes on the sheet:
Firmware: VIN = VBAT_SENSE x 139 / 39; pack = VIN + about 0.05 V (Q1 PMOS drop).
RunCam Split 4: 5-20 V in. Single 5-pin harness: power, ground and UART (R7 / R8 in series with the UART lines).
Pack sense: VBAT_SENSE = VIN x 39k / (100k + 39k). Full pack 8.4 V (VIN about 8.35 V after Q1) -> 2.34 V at GPIO34, inside the ESP32 ADC's 2.45 V range (11 dB).
2 x 1x15 female header for a 30-pin ESP32 DevKit V1 (ESP-WROOM-32, DOIT pinout: EN ... VIN / D23 ... 3V3). Pin 1 is at the antenna end.

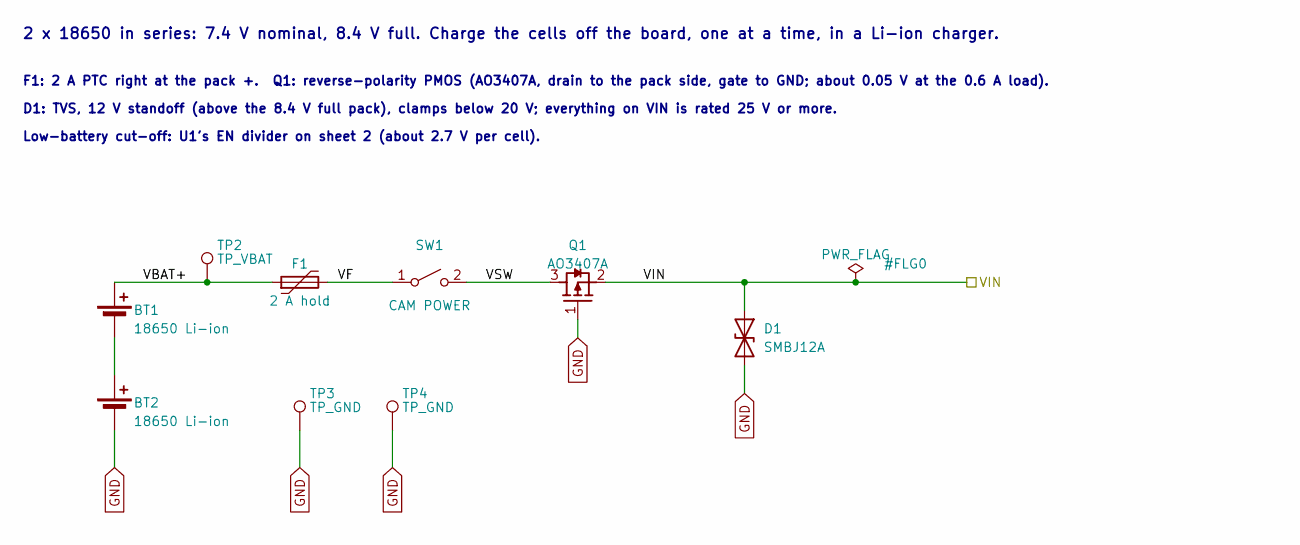
[picture p40: schematic power_in.kicad_sch, 1. Camera + ESP32 supply (2S)]

Parts:
BT1, BT2: 18650 Li-ion; BatteryHolder_Keystone_1042_1x18650; MPN 1042
D1: SMBJ12A; D_SMB; MPN SMBJ12A
F1: 2 A hold; Fuse_1812_4532Metric; MPN 1812L200/12DR
Q1: AO3407A; SOT-23-3; MPN AO3407A
SW1: CAM POWER; Molex_Micro-Fit_3.0_43650-0215_1x02_P3.00mm_Vertical; MPN 0436500215
TP2: TP_VBAT; TestPoint_THTPad_D2.0mm_Drill1.0mm
TP3, TP4: TP_GND; TestPoint_THTPad_D2.0mm_Drill1.0mm

Connections:
/1. Battery 2S + protection/VBAT+: BT1.1 (+), F1.1, TP2.1 (1_1)
/1. Battery 2S + protection/VF: F1.2, SW1.1 (A)
/1. Battery 2S + protection/VIN: D1.1 (A1), Q1.2 (S); also elsewhere on the board
/1. Battery 2S + protection/VSW: Q1.3 (D), SW1.2 (B)
GND: BT2.2 (-), D1.2 (A2), Q1.1 (G), TP3.1 (1_1), TP4.1 (1_1); also elsewhere on the board
unnamed: BT1.2 (-), BT2.1 (+)

Notes on the sheet:
2 x 18650 in series: 7.4 V nominal, 8.4 V full. Charge the cells off the board, one at a time, in a Li-ion charger.
Low-battery cut-off: U1's EN divider on sheet 2 (about 2.7 V per cell).
D1: TVS, 12 V standoff (above the 8.4 V full pack), clamps below 20 V; everything on VIN is rated 25 V or more.
F1: 2 A PTC right at the pack +. Q1: reverse-polarity PMOS (AO3407A, drain to the pack side, gate to GND; about 0.05 V at the 0.6 A load).

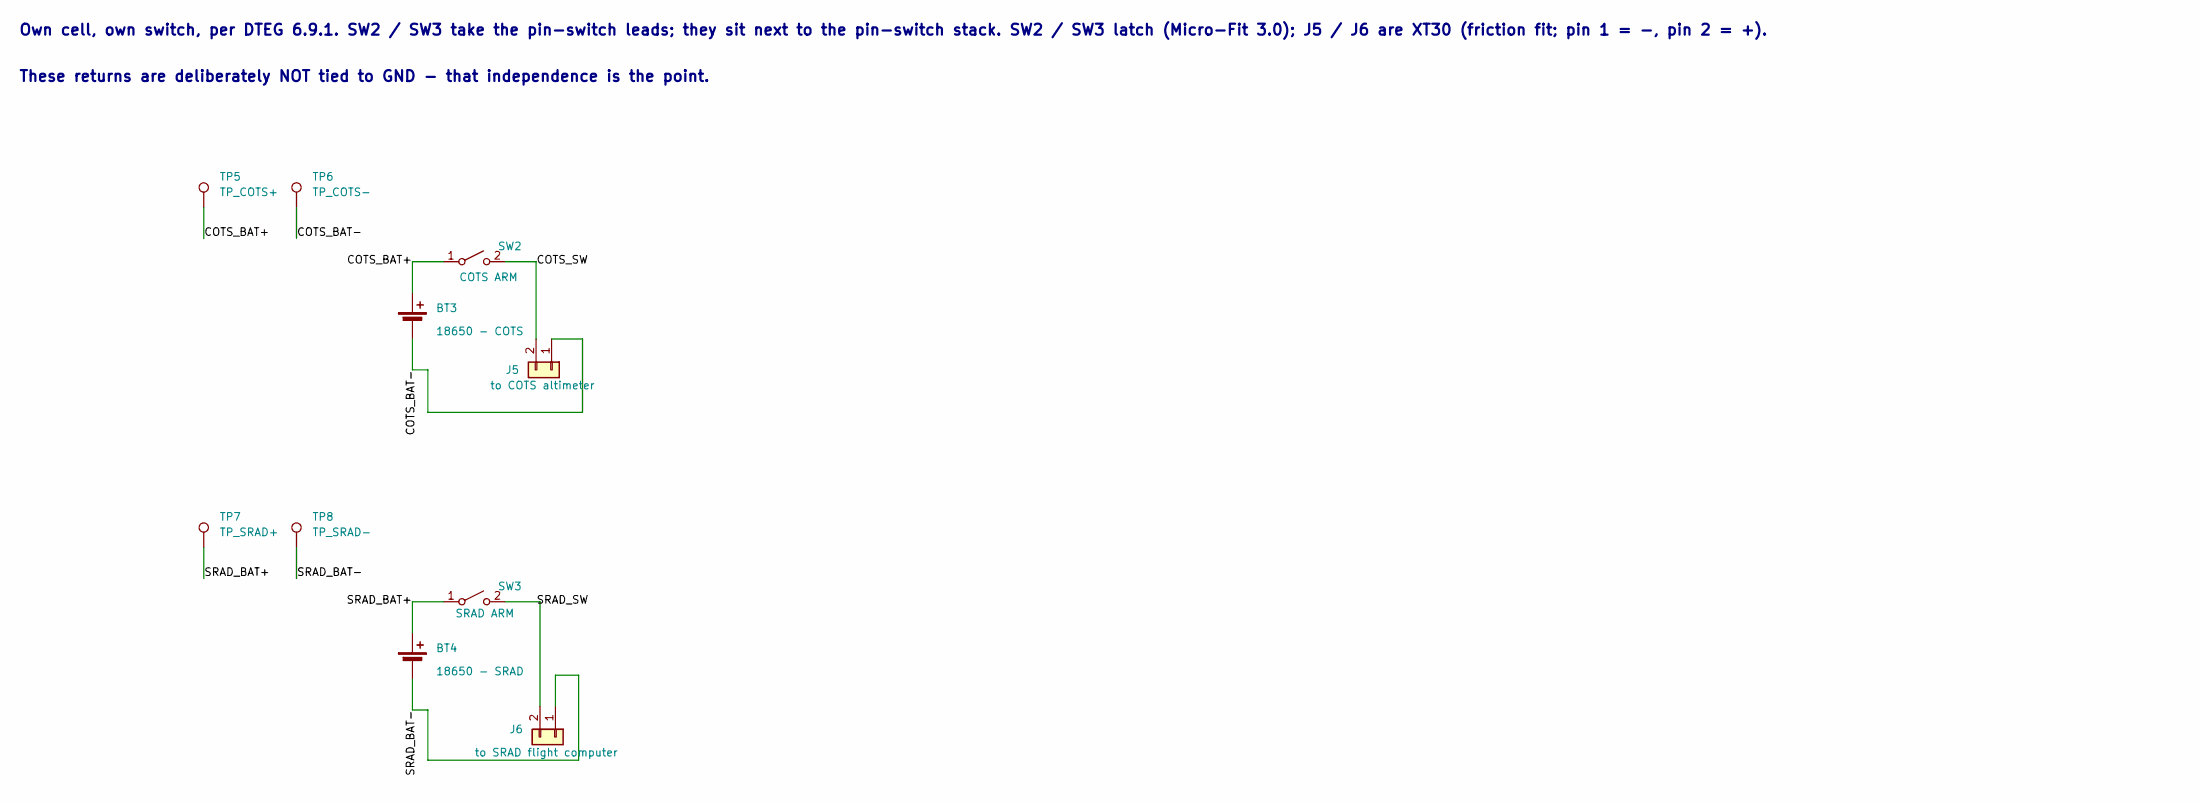
[picture p41: schematic supplies.kicad_sch, 4. Independent 1S supplies]

Parts:
BT3: 18650 - COTS; BatteryHolder_Keystone_1042_1x18650; MPN 1042
BT4: 18650 - SRAD; BatteryHolder_Keystone_1042_1x18650; MPN 1042
J5: to COTS altimeter; AMASS_XT30UPB-F_1x02_P5.0mm_Vertical; MPN XT30UPB-M
J6: to SRAD flight computer; AMASS_XT30UPB-F_1x02_P5.0mm_Vertical; MPN XT30UPB-M
SW2: COTS ARM; Molex_Micro-Fit_3.0_43650-0215_1x02_P3.00mm_Vertical; MPN 0436500215
SW3: SRAD ARM; Molex_Micro-Fit_3.0_43650-0215_1x02_P3.00mm_Vertical; MPN 0436500215
TP5: TP_COTS+; TestPoint_THTPad_D2.0mm_Drill1.0mm
TP6: TP_COTS-; TestPoint_THTPad_D2.0mm_Drill1.0mm
TP7: TP_SRAD+; TestPoint_THTPad_D2.0mm_Drill1.0mm
TP8: TP_SRAD-; TestPoint_THTPad_D2.0mm_Drill1.0mm

Connections:
/4. COTS / SRAD supplies/COTS_BAT+: BT3.1 (+), SW2.1 (A), TP5.1
/4. COTS / SRAD supplies/COTS_BAT-: BT3.2 (-), J5.1, TP6.1
/4. COTS / SRAD supplies/COTS_SW: J5.2, SW2.2 (B)
/4. COTS / SRAD supplies/SRAD_BAT+: BT4.1 (+), SW3.1 (A), TP7.1
/4. COTS / SRAD supplies/SRAD_BAT-: BT4.2 (-), J6.1, TP8.1
/4. COTS / SRAD supplies/SRAD_SW: J6.2, SW3.2 (B)

Notes on the sheet:
Own cell, own switch, per DTEG 6.9.1. SW2 / SW3 take the pin-switch leads; they sit next to the pin-switch stack. SW2 / SW3 latch (Micro-Fit 3.0); J5 / J6 are XT30 (friction fit; pin 1 = -, pin 2 = +).
These returns are deliberately NOT tied to GND - that independence is the point.

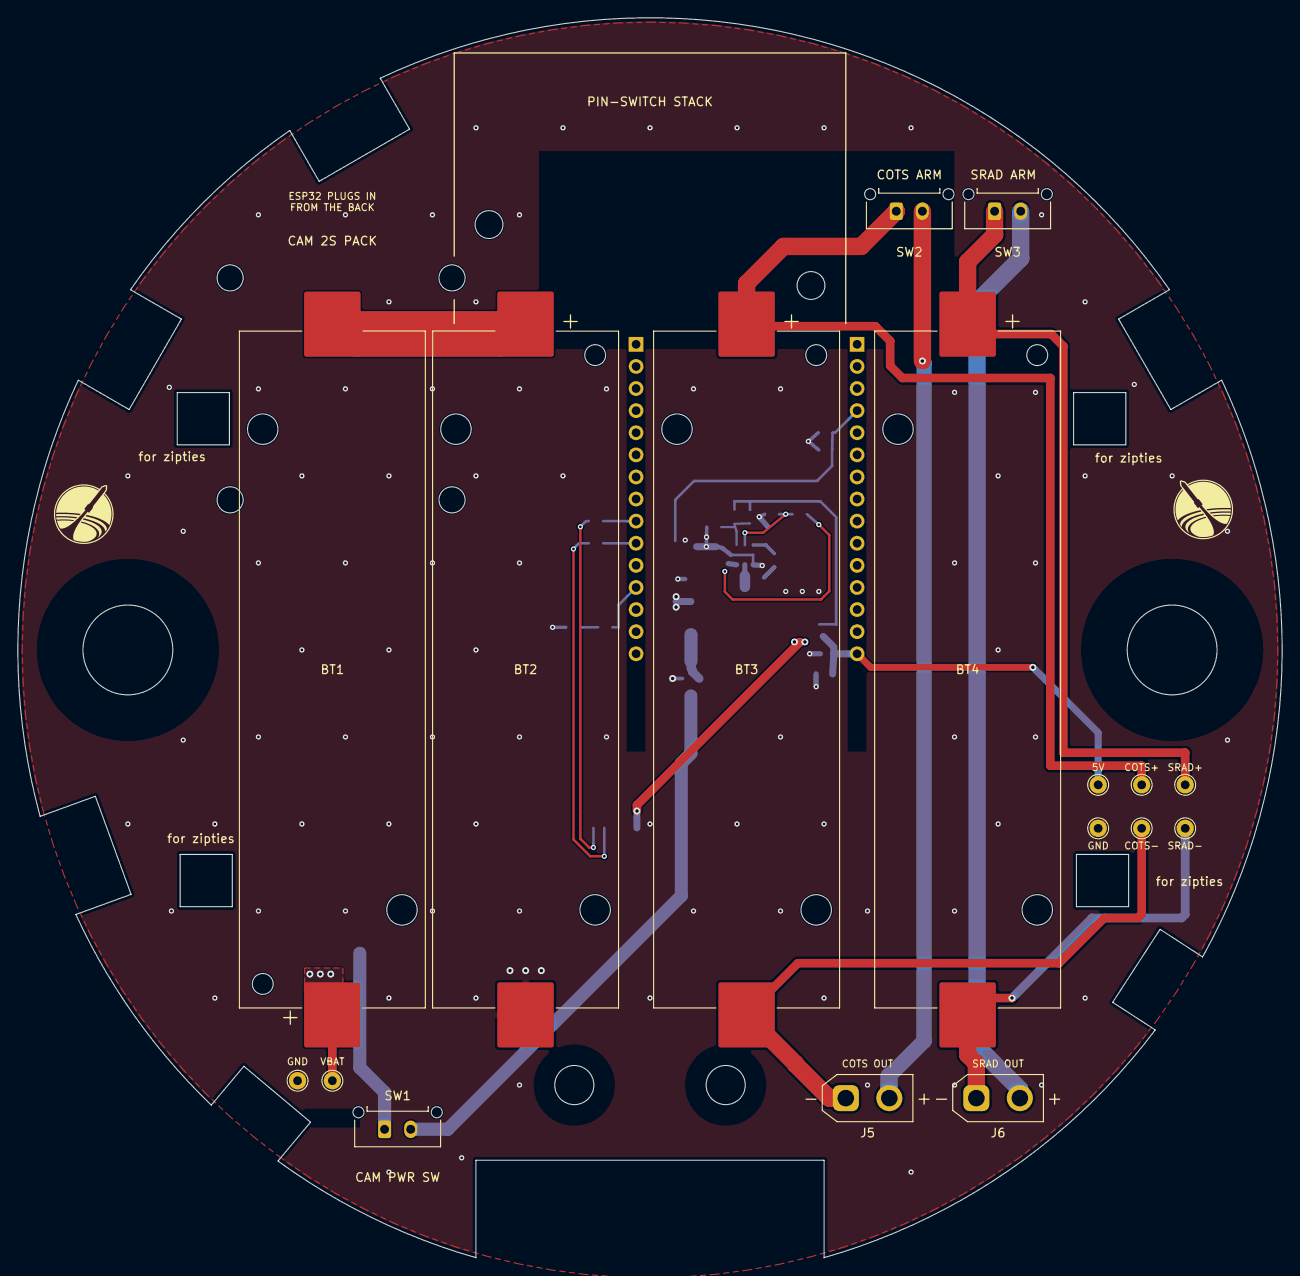
[picture p42: board battery_pcb_30pin.kicad_pcb from above]

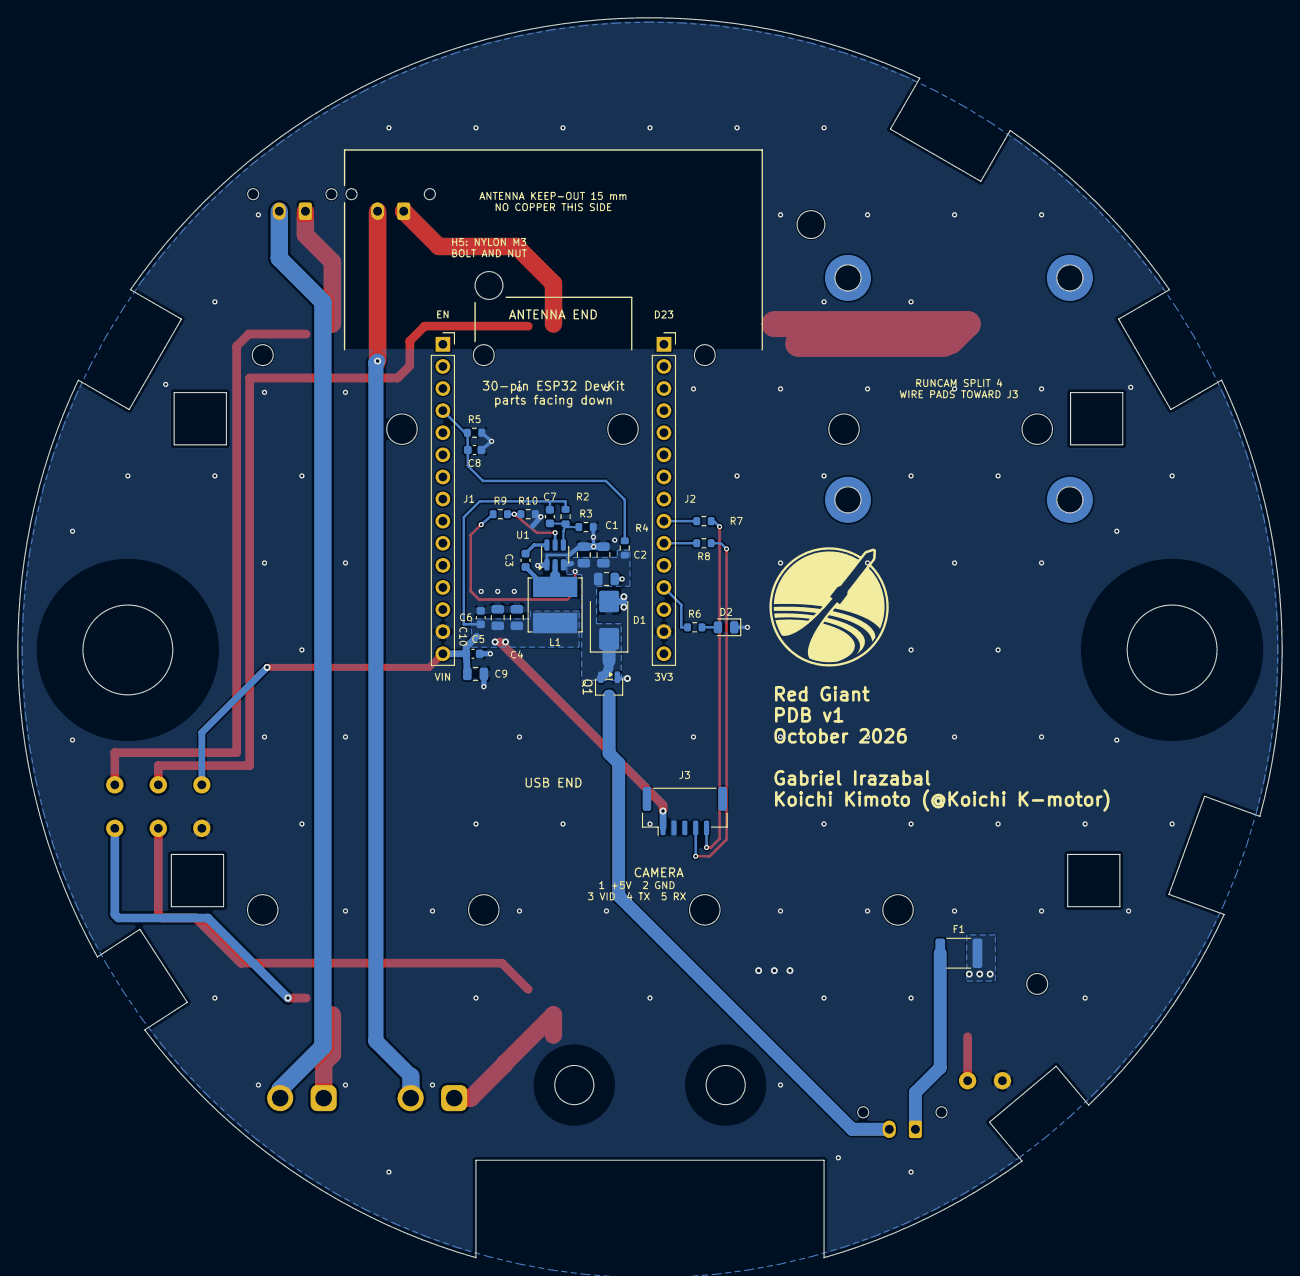
[picture p43: board battery_pcb_30pin.kicad_pcb from below]

Board: 2 copper layers, 145.3 x 142.5 mm, 57 parts (34 on the bottom side), 24 nets.

Other parts of the board:
CAM1: RunCam Split 4 (on standoffs); RunCam_Split4_OnStandoffs
H1, H2: 3/8 rod; MountingHole_10.3mm_3-8in_Rod
H3: TeleMetrum sled M4; MountingHole_4.5mm_TeleMetrum_Sled_L
H4: TeleMetrum sled M4; MountingHole_4.5mm_TeleMetrum_Sled_R
H5, H6: Pin switch stack M3; MountingHole_3.2mm_M3_RoundStandoff_D5
H7, H8, H9, H10: Wurth 9774050243 M2x5 standoff (camera); Mounting_Wuerth_WA-SMSI-M2_H5mm_9774050243
