stanford-ssi/Aerolotl_KiCAD/aerolotl.kicad_pcb

## KiCad design aerolotl.kicad_pcb (2026-09-05)

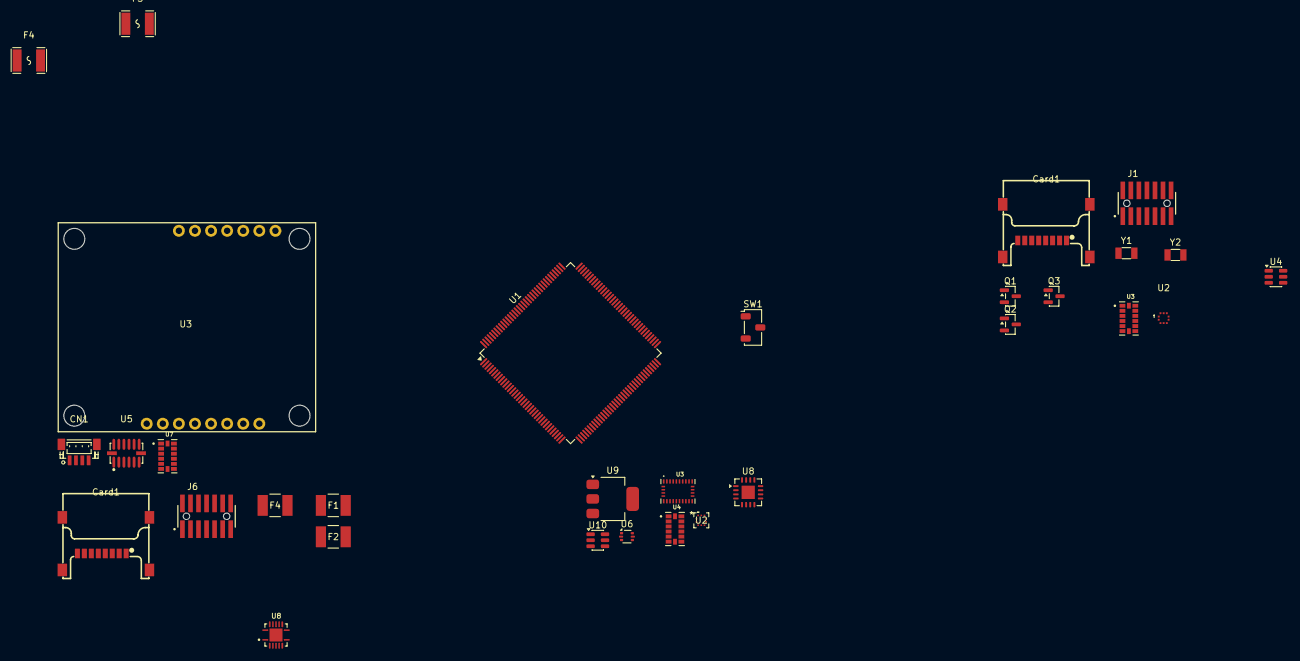
[picture p44: board aerolotl.kicad_pcb from above]

Board: 2 copper layers, 31 parts (0 on the bottom side), 33 nets, no tracks yet.

Parts:
CN1: StemmaQT; CONN-SMD_BM04B-SRSS-TB
Card1: TF-102-15_SD_read; TF-SMD_TF-102-15
Card1#2: TF-102-15; TF-SMD_TF-102-15
F1, F2, F4#2: 1812L150/24MR; FUSE_1812L150&slash_24_LTF
F3, F4: 1812L300/24SLER; F1812
J1: SWD; SAMTEC_FTSH-107-01-L-DV-K-A
J6: FTSH-107-STDC14; SAMTEC_FTSH-107-01-L-DV-K-A
Q1, Q2, Q3: AO3400A; SOT-23
SW1: SW_Nidec_CAS-120A1; Nidec_Copal_CAS-120A
U1: STM32H755ZIT6; LQFP-144_20x20mm_P0.5mm
U2: BMP581; LGA-10_L2.0-W2.0-P0.50-TL_BMP581
U2#2: BMP581; QFN10_BMP581_BOS
U3: BNO085; IC_BNO085
U3#2, U4#2: ADXL345BCCZ-RL7; PQFN80P500X300X100-14N
U3#3: SparkfunM9N
U4, U10: LMR51430XFDDCR; SOT-23-6
U5: ADXL375BCCZ-RL7; LGA-14_L5.0-W3.0-P0.80-BL
U6: USBLC6-2P6; SOT-666
U7: ADXL345BCCZ-RL7; ADXL345
U8: TPS54620RGYR; TPS54620_7v4buck
U8#2: FT230XQ; QFN-16-1EP_4x4mm_P0.65mm_EP2.1x2.1mm
U9: AMS1117-3.3; SOT-223-3_TabPin2
Y1: 25M; Crystal_SMD_3215-2Pin_3.2x1.5mm
Y2: 32k768; Crystal_SMD_3215-2Pin_3.2x1.5mm

Connections:
+3V3: Card1.4 (VDD), Card1#2.4 (VDD), J6.03, SW1.3 (A), U1.7 (VDD), U1.8 (VBAT), U1.13 (VDD), U1.16 (VDDSMPS), U1.19 (VDD), U1.32 (VDD), U1.42 (VDD), U1.56 (VDD), U1.70 (VDDLDO), U1.71 (VDD), U1.79 (VDD), U1.90 (VDD50_USB), U1.91 (VDD33_USB), U1.92 (VDD), U1.105 (VDDLDO), U1.106 (VDD), U1.119 (VDD), U1.129 (VDD), U1.142 (PDR_ON), U1.143 (VDDLDO), U1.144 (VDD), U3#3.6 (3V3), U3#3.11 (3V3)
+7V4_SERVO: F3.1, F4.1
+12V: U4.3 (VIN), U4.5 (EN)
+12V_ARM: F1.2, F2.2
/Debugger/T_SWCLK: J1.06, J6.06, U1.107 (PA14)
/Debugger/T_SWDIO: J1.04, J6.04, U1.102 (PA13)
/Debugger/T_SWO: J1.08, J6.08, U1.130 (PB3)
/Debugger/T_VCP_RX: J1.14, J6.14, U1.98 (PA9)
/Debugger/T_VCP_TX: J1.13, J6.13, U1.99 (PA10)
/IMUs/ADXL345.CS: U3#2.7 (~CS), U7.7 (~CS)
/IMUs/ADXL345.SCLK: U1.44 (PA5), U2.2 (SCK), U3#2.14 (SCL/SCLK), U5.14 (SCL/SCLK), U7.14 (SCL/SCLK)
/IMUs/ADXL345.SDI: U1.45 (PA6), U2.5 (SDO), U3#2.13 (SDA/SDI/SDIO), U5.12 (SDO/ALTADDRESS), U7.13 (SDA/SDI/SDIO)
/IMUs/ADXL345.SDO: U1.46 (PA7), U2.4 (SDI), U3#2.12 (SDO/ALT_ADDRESS), U5.13 (SDA/SDI/SDIO), U7.12 (SDO/ALT_ADDRESS)
/MCU/BOOT0: SW1.2 (B), U1.135 (BOOT0)
/MCU/HS_OSC_A: U1.25 (PH0), Y1.1
/MCU/HS_OSC_B: U1.26 (PH1), Y1.2
/MCU/LS_OSC_A: U1.10 (PC14), Y2.2
/MCU/LS_OSC_B: U1.11 (PC15), Y2.1
/MCU/RESET: J6.12, U1.27 (NRST)
/MCU/SDMMC1.CK: Card1.5 (CLK), Card1#2.5 (CLK), U1.111 (PC12)
/MCU/SDMMC1.CMD: Card1.3 (CMD), Card1#2.3 (CMD), U1.114 (PD2)
/MCU/SDMMC1.D0: Card1.7 (DAT0), Card1#2.7 (DAT0), U1.95 (PC8)
/MCU/SDMMC1.D1: Card1.8 (DAT1), Card1#2.8 (DAT1), U1.96 (PC9)
/MCU/SDMMC1.D2: Card1.1 (DAT2), Card1#2.1 (DAT2), U1.109 (PC10)
/MCU/SDMMC1.D3: Card1.2 (CD/DAT3), Card1#2.2 (CD/DAT3), U1.110 (PC11)
/MCU/USB_D_M: U1.100 (PA11), U6.6 (I/O1)
/MCU/USB_D_P: U1.101 (PA12), U6.4 (I/O2)
/MCU/VFBSMPS: U1.17 (VFBSMPS), U1.68 (VCAP), U1.103 (VCAP), U1.140 (VCAP)
/Power/P_VBUS: U6.5 (VBUS), U9.3 (VI)
/USB to UART/VCCIO: U8#2.1 (VCCIO), U8#2.8 (3V3OUT), U8#2.9 (~RESET)
GND: CN1.0, CN1.1, Card1.6 (VSS), Card1.9 (SHELL), Card1.10 (SHELL), Card1.11 (SHELL), Card1.12 (SHELL), Card1#2.6 (VSS), Card1#2.9 (SHELL), Card1#2.10 (SHELL), Card1#2.11 (SHELL), Card1#2.12 (SHELL), J1.05, J1.07, J6.05, J6.07, Q1.2 (S), Q2.2 (S), Q3.2 (S), U1.6 (VSS), U1.12 (VSS), U1.14 (VSSSMPS), U1.18 (VSS), U1.33 (VSS), U1.34 (VSSA), U1.41 (VSS), U1.55 (VSS), U1.69 (VSS), U1.80 (VSS), U1.89 (VSS), U1.104 (VSS), U1.118 (VSS), U1.128 (VSS), U1.141 (VSS), U2.3 (VSS), U2.8 (VSS), U2.9 (VSS), U3#2.2 (GND), U3#2.4 (GND), U3#2.5 (GND), U3#3.5 (GND), U3#3.9 (GND), U4.1 (GND), U4#2.2 (GND), U4#2.4 (GND), U4#2.5 (GND), U5.2 (GND), U5.4 (GND), U5.5 (GND), U5.11 (RESERVED), U6.2 (GND), U7.2 (GND), U7.4 (GND), U7.5 (GND), U7.11 (RESERVED_11), U8#2.3 (GND), U8#2.13 (GND), U8#2.17 (GND), U9.1 (GND)
VCC: CN1.2, F4#2.2
VDD: U3#2.1 (VDD_I/O), U3#2.6 (VS), U5.1 (VDDI/O), U5.3 (RESERVED), U5.6 (VS), U7.1 (VDD_I/O), U7.3 (RESERVED_3), U7.6 (VS)
