stanford-ssi/Aerolotl_KiCAD/BatteryPCB_30pin/tools/layoutA/seed_user_1224.kicad_pcb

## KiCad design BatteryPCB_30pin/tools/layoutA/seed_user_1224.kicad_pcb (2026-10-06)

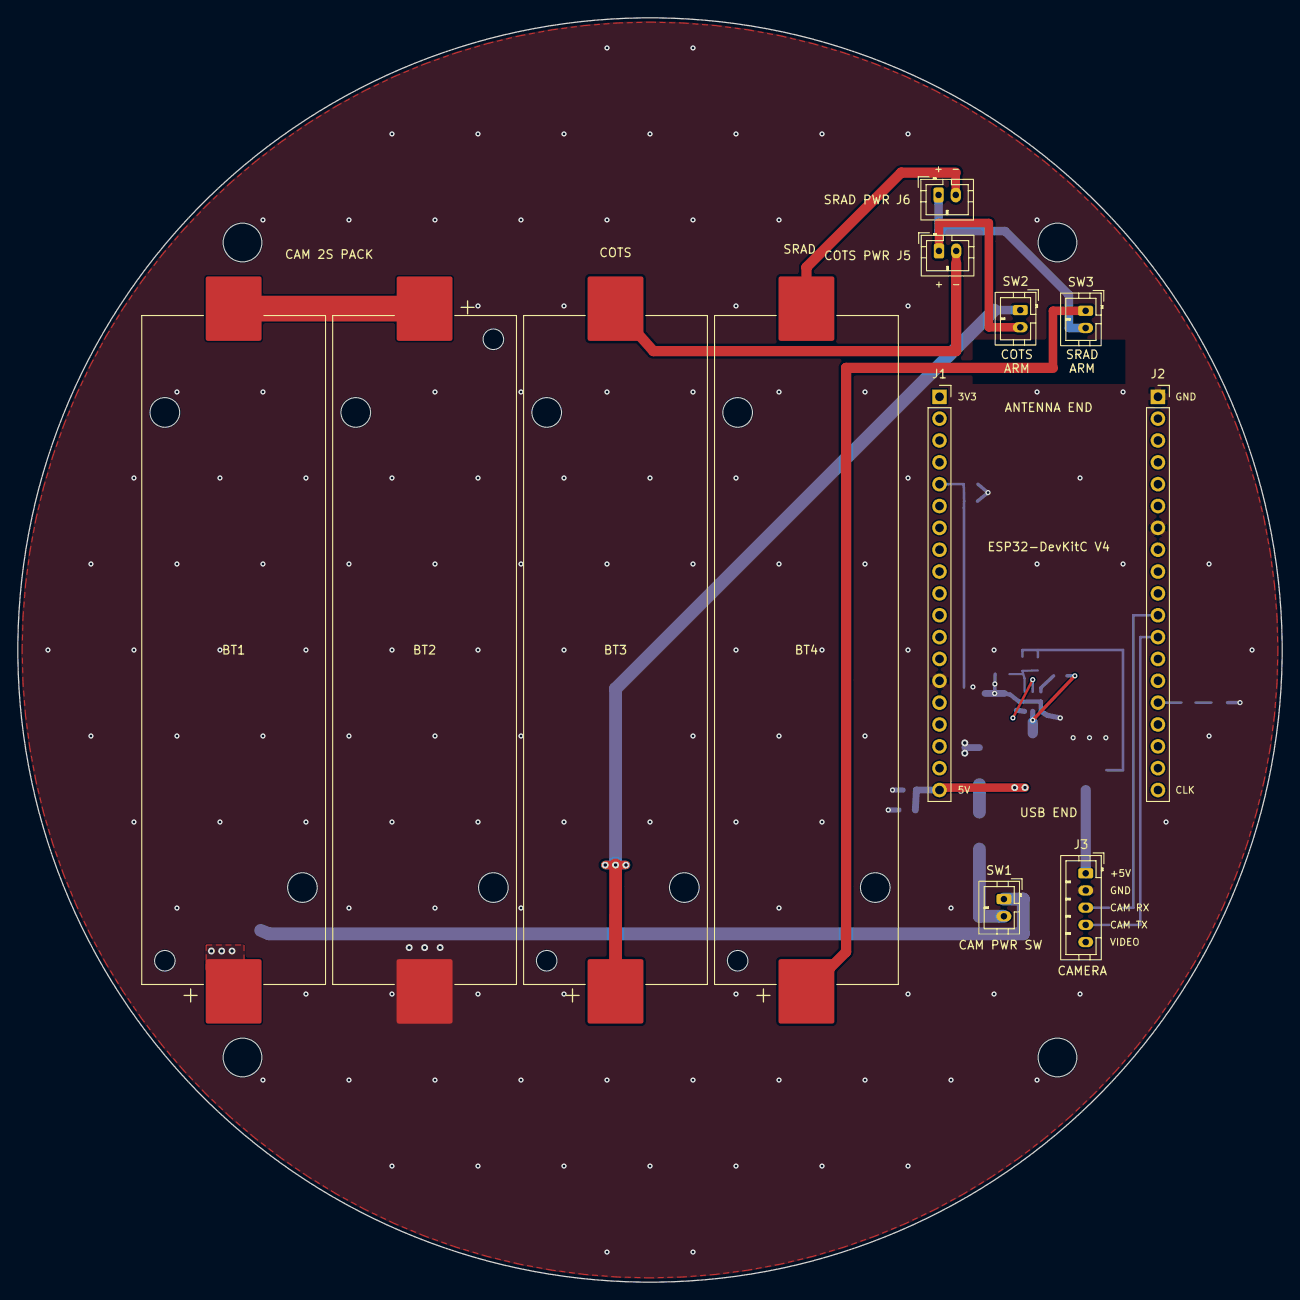
[picture p45: board seed_user_1224.kicad_pcb from above]

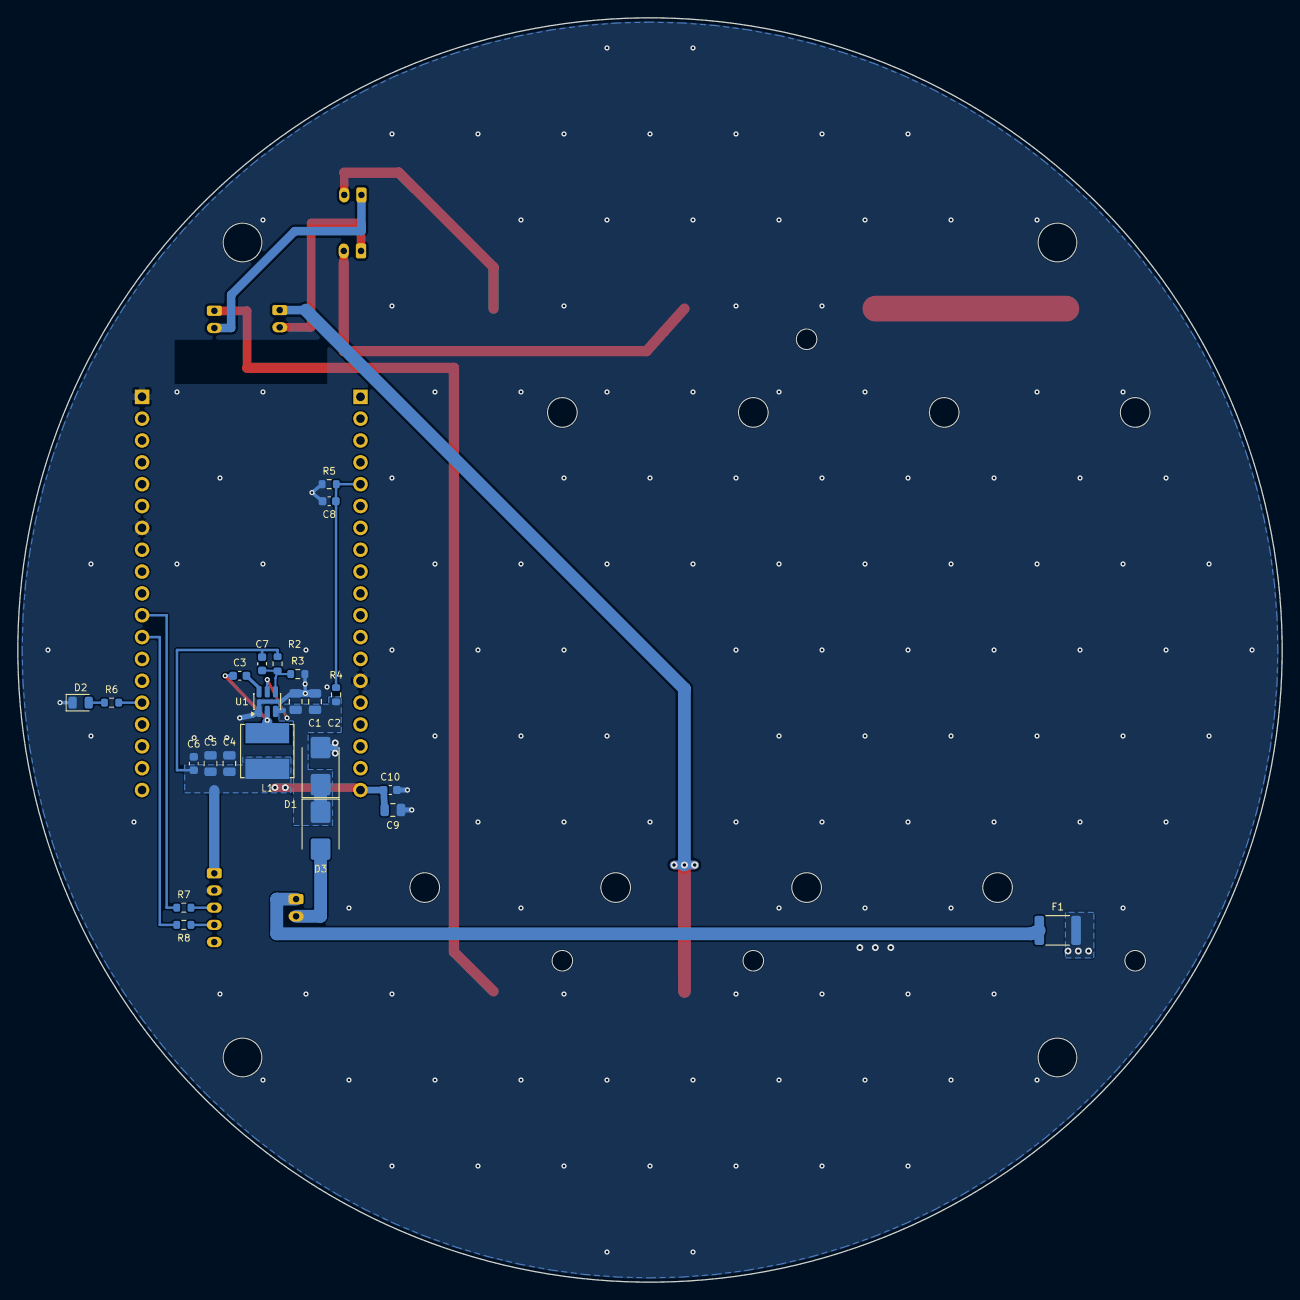
[picture p46: board seed_user_1224.kicad_pcb from below]

Board: 2 copper layers, 147.0 x 147.0 mm, 39 parts (23 on the bottom side), 23 nets.

Parts:
BT1, BT2: 18650 Li-ion; BatteryHolder_Keystone_1042_1x18650
BT3: 18650 - COTS; BatteryHolder_Keystone_1042_1x18650
BT4: 18650 - SRAD; BatteryHolder_Keystone_1042_1x18650
C1, C2: 10u / 25V; C_0805_2012Metric
C3, C6, C8, C10: 100n; C_0603_1608Metric
C4, C5: 22u / 16V; C_0805_2012Metric
C7: 22p; C_0603_1608Metric
C9: 10u; C_0805_2012Metric
D1: SMBJ12A; D_SMB
D2: STATUS; LED_0805_2012Metric
D3: SS34 reverse prot; D_SMB
F1: 2 A hold; Fuse_1812_4532Metric
H45, H135, H225, H315: MountingHole_4.5mm
J1: ESP32 left; PinSocket_1x19_P2.54mm_Vertical
J2: ESP32 right; PinSocket_1x19_P2.54mm_Vertical
J3: RunCam Split 4; JST_PH_B5B-PH-K_1x05_P2.00mm_Vertical
J5: to COTS altimeter; JST_PH_B2B-PH-K_1x02_P2.00mm_Vertical
J6: to SRAD flight computer; JST_PH_B2B-PH-K_1x02_P2.00mm_Vertical
L1: 4u7 / 3A; L_Bourns_SRN6045TA
R2: 100k 1%; R_0603_1608Metric
R3: 13k7 1%; R_0603_1608Metric
R4: 100k; R_0603_1608Metric
R5: 47k; R_0603_1608Metric
R6: 1k; R_0603_1608Metric
R7, R8: 100R; R_0603_1608Metric
SW1: CAM POWER; JST_PH_B2B-PH-K_1x02_P2.00mm_Vertical
SW2: COTS ARM; JST_PH_B2B-PH-K_1x02_P2.00mm_Vertical
SW3: SRAD ARM; JST_PH_B2B-PH-K_1x02_P2.00mm_Vertical
U1: LMR51430XFDDCR; SOT-23-6

Connections:
/1. Battery 2S + protection/VBAT+: BT1.1, F1.1
/1. Battery 2S + protection/VF: F1.2, SW1.1
/1. Battery 2S + protection/VIN: C1.1, C2.1, D1.1, D3.1, R4.1, U1.3, U1.5
/1. Battery 2S + protection/VSW: D3.2, SW1.2
/2. Buck to 5 V/+5V: C4.1, C5.1, C6.1, C7.1, C9.1, C10.1, J1.19, J3.1, L1.2, R2.1
/2. Buck to 5 V/CBOOT: C3.1, U1.6
/2. Buck to 5 V/FB: C7.2, R2.2, R3.1, U1.4
/2. Buck to 5 V/SW: C3.2, L1.1, U1.2
/3. Pack voltage sense/VBAT_SENSE: C8.1, J1.5, R4.2, R5.1
/4. ESP32 socket/ESP_RX2: J2.12, R8.1
/4. ESP32 socket/ESP_TX2: J2.11, R7.1
/4. ESP32 socket/LED_A: D2.2, R6.2
/4. ESP32 socket/LED_GPIO: J2.15, R6.1
/5. RunCam Split 4/CAM_RX: J3.3, R7.2
/5. RunCam Split 4/CAM_TX: J3.4, R8.2
/6. COTS / SRAD supplies/COTS_BAT+: BT3.1, SW2.1
/6. COTS / SRAD supplies/COTS_BAT-: BT3.2, J5.2
/6. COTS / SRAD supplies/COTS_SW: J5.1, SW2.2
/6. COTS / SRAD supplies/SRAD_BAT+: BT4.1, SW3.1
/6. COTS / SRAD supplies/SRAD_BAT-: BT4.2, J6.2
/6. COTS / SRAD supplies/SRAD_SW: J6.1, SW3.2
GND: BT2.2, C1.2, C2.2, C4.2, C5.2, C6.2, C8.2, C9.2, C10.2, D1.2, D2.1, J1.14, J2.1, J2.7, J3.2, R3.2, R5.2, U1.1
unnamed: BT1.2, BT2.1
