stanford-ssi/Aerolotl_KiCAD/pre-layout-backup/aerolotl.kicad_pcb

## KiCad design pre-layout-backup/aerolotl.kicad_pcb (2026-09-28)

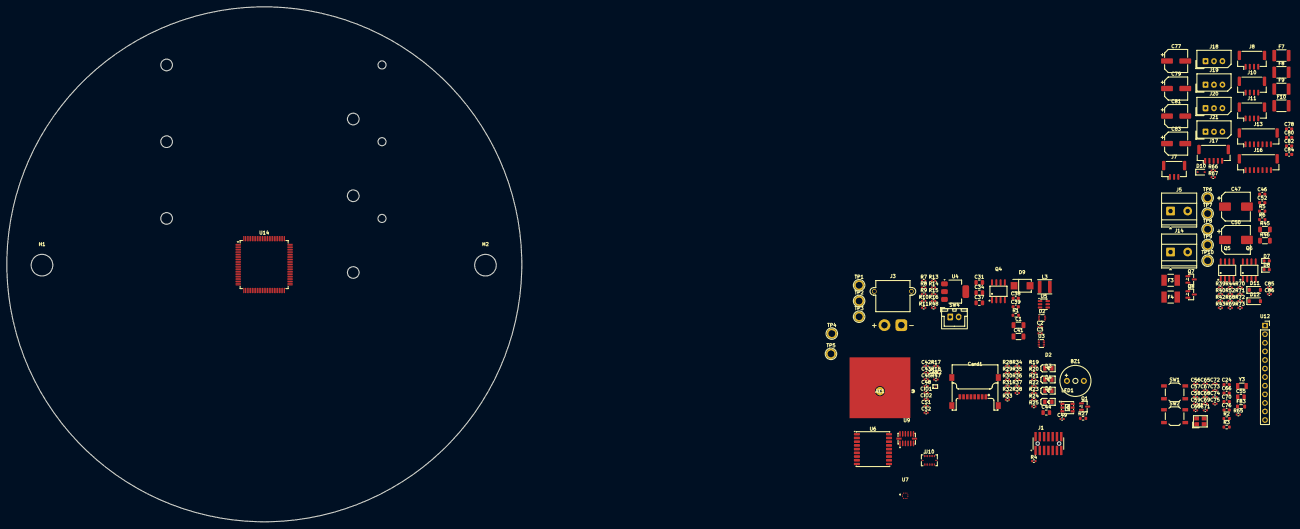
[picture p47: board pre-layout-backup/aerolotl.kicad_pcb from above]

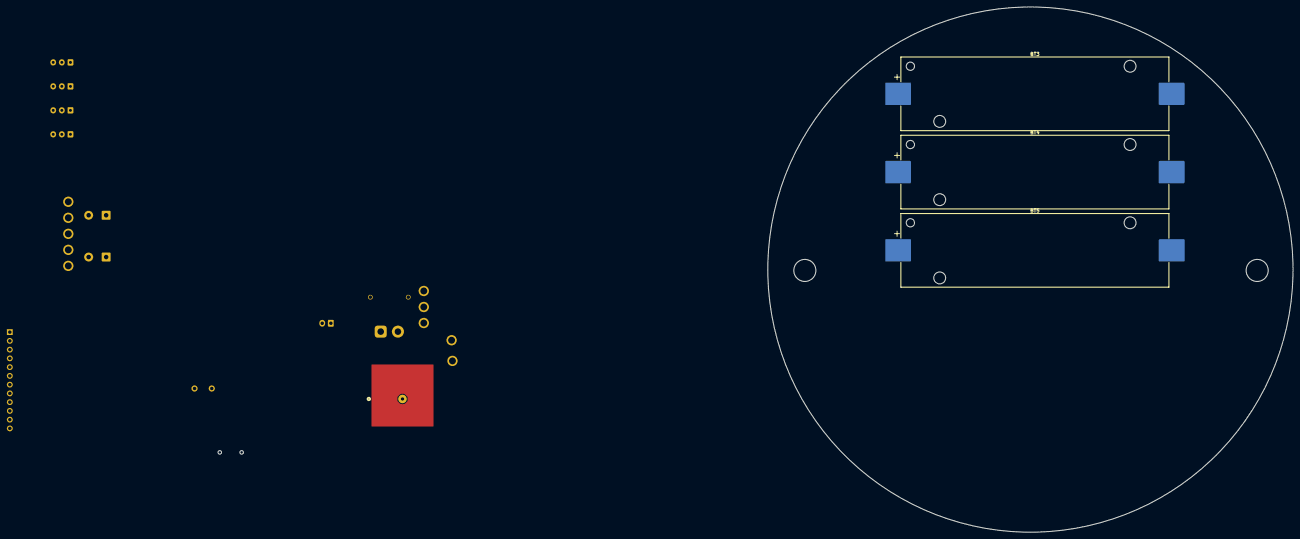
[picture p48: board pre-layout-backup/aerolotl.kicad_pcb from below]

Board: 4 copper layers, 152.4 x 152.4 mm, 181 parts (3 on the bottom side), 129 nets, no tracks yet.

Parts:
AE1: GP.1575.18.4.A.02; ANT_GP.1575.18.4.A.02_TAL
BT3, BT4, BT5: Battery_Cell; BatteryHolder_Keystone_1042_1x18650
BZ1: HNB09A03; BUZ-TH_BD9.0-P5.00-D0.6-FD
C1, C41: 100u; C_1206_3216Metric
C2, C3: 1u; C_0402_1005Metric
C24, C38, C39: 100n; C_0603_1608Metric
C31, C34, C44: 22u; C_0805_2012Metric
C37: 4u7; C_0805_2012Metric
C42, C43, C45, C48: 100nF; C_0402_1005Metric
C46, C52: 150n; C_0603_1608Metric
C47, C50: 330u; CP_Elec_8x10
C49, C56, C57, C58, C59, C60, C65, C69, C75, C85, C86: 100n; C_0402_1005Metric
C55: 4.7u; C_0805_2012Metric
C66, C70, C76: 1u; C_0603_1608Metric
C67, C68: 2u2; C_0402_1005Metric
C71, C72, C73, C74: 15p; C_0402_1005Metric
C77, C79, C81, C83: 100u 25V; CP_Elec_6.3x7.7
C78, C80, C82, C84: 100n 50V; C_0603_1608Metric
CIO1: 1u; C_0402_1005Metric
CIO2: 100n; C_0402_1005Metric
CS1: 100n; C_0402_1005Metric
CS2: 1u; C_0402_1005Metric
Card1: TF-102-15_SD_read; TF-SMD_TF-102-15
D2: STM LED; LED0805-R-RD
D3: 3V3 LED; LED0805-R-RD
D4: USB LED; LED0805-R-RD
D6: ARM LED; LED0805-R-RD
D7, D8: LED; LED_0603_1608Metric
D9: SMBJ15A; SMB_L4.6-W3.6-LS5.3-RD
D10: PESD5V0S1BA; D_SOD-323
D11, D12: 1N4148W; D_SOD-123
F3, F4: 1812L150/24MR; FUSE_1812L150&slash_24_LTF
F7, F8, F9, F10: 1812L300/24SLER; Fuse_1812_4532Metric
FB3: 100; L_0805_2012Metric
H1, H2: MountingHole; MountingHole_6.4mm_M6_ISO7380
J1: FTSH-107-STDC14; STDC14_SAMTEC_FTSH-107-01-L-DV-K-A
J3: Pin Switch Conn; AMASS_XT30PW-M_1x02_P2.50mm_Horizontal
J5, J14: Screw_Terminal_01x02; TerminalBlock_Phoenix_MKDS-1,5-2-5.08_1x02_P5.08mm_Horizont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
J7: SPARE_ADC1; JST_GH_BM03B-GHS-TBT_1x03-1MP_P1.25mm_Vertical
J8: Conn_01x04_Pin; JST_GH_BM04B-GHS-TBT_1x04-1MP_P1.25mm_Vertical
J10: USART3; JST_GH_BM04B-GHS-TBT_1x04-1MP_P1.25mm_Vertical
J11: UART8; JST_GH_BM04B-GHS-TBT_1x04-1MP_P1.25mm_Vertical
J13: GPIO_PE2-PE6; JST_GH_BM07B-GHS-TBT_1x07-1MP_P1.25mm_Vertical
J16: GPIO_PE7-PE11; JST_GH_BM07B-GHS-TBT_1x07-1MP_P1.25mm_Vertical
J17: Conn_01x05_Pin; JST_GH_BM05B-GHS-TBT_1x05-1MP_P1.25mm_Vertical
J18: SERVO1; Molex_SPOX_5267-03A_1x03_P2.50mm_Vertical
J19: SERVO2; Molex_SPOX_5267-03A_1x03_P2.50mm_Vertical
J20: SREVO3; Molex_SPOX_5267-03A_1x03_P2.50mm_Vertical
J21: SERVO4; Molex_SPOX_5267-03A_1x03_P2.50mm_Vertical
L3: 4u7; L_Sunlord_SWPA4030S
LED1: RS-3535MWAR-2JYJY-J; LED-SMD_RS-3535MWAR-2JYJY-J
Q1, Q7, Q8: AO3400A; SOT-23
Q4: AO4407A; SOIC-8_L4.9-W3.9-P1.27-LS6.0-BL
Q5, Q6: FDS6673BZ_C467780; SOIC-8_L4.9-W3.9-P1.27-LS6.0-BL
R1: 0R; R_0603_1608Metric
R2, R3: 10k; R_0603_1608Metric
R4, R39, R52: 100; R_0402_1005Metric
R5, R6, R27: 3k3; R_0603_1608Metric
R7, R13, R34, R35, R36, R37, R38, R68, R70, R71, R73: 10k; R_0402_1005Metric
R8, R9: 5k1; R_0402_1005Metric
R10: 9k53; R_0402_1005Metric
R11: 5k; R_0402_1005Metric
R14: 3k3; R_0402_1005Metric
R15, R48: 100k; R_0402_1005Metric
R16: 22k1; R_0402_1005Metric
R17, R18, R28, R29, R30, R31, R32, R33, R47: 10; R_0402_1005Metric
R19, R20, R21, R40, R43, R67: 330; R_0402_1005Metric
R22: 3.3k; R_0402_1005Metric
R23, R24: 470; R_0402_1005Metric
R25: 910; R_0402_1005Metric
R42, R44: 8.2k; R_0402_1005Metric
R45, R46: 1k; R_1206_3216Metric
R65: 47; R_0402_1005Metric
R66: 4.7k; R_0402_1005Metric
R69, R72: 33k; R_0402_1005Metric
SAW2: B39162B4300F210; FILTER-SMD_5P-L1.4-W1.1_RSFPXXXXD
SW1: SW_Push; SW_SPST_TL3342
SW2: SW_SPST; SW_SPST_TL3342
SW4: SW_SPST; JST_XH_B2B-XH-A_1x02_P2.50mm_Vertical
TP1: +BATT; TestPoint_Plated_Hole_D2.0mm
TP2: +12V; TestPoint_Plated_Hole_D2.0mm
TP3: +3V3; TestPoint_Plated_Hole_D2.0mm
TP4: VOLT_SENSE; TestPoint_Plated_Hole_D2.0mm
TP5: GND; TestPoint_Plated_Hole_D2.0mm
TP6: +12V_ARM; TestPoint_Plated_Hole_D2.0mm
TP7: SENSE_I0; TestPoint_Plated_Hole_D2.0mm
TP8: SENSE_I1; TestPoint_Plated_Hole_D2.0mm
TP9: IGNITE_0; TestPoint_Plated_Hole_D2.0mm
TP10: IGNITE_1; TestPoint_Plated_Hole_D2.0mm
U2: USBLC6-2P6; SOT-666
U3: TPS2116DRL; SOT-583-8
U4: AMS1117-3.3; SOT-223-3_TabPin2
U5: LMR51430XFDDCR; SOT-23-6
U6: MAX-M10S; ublox_MAX
U7: BMP581; LGA-10_L2.0-W2.0-P0.50-TL_BMP581
U9: ADXL375BCCZ-RL7; ADXL375_LGA-14_L5.0-W3.0-P0.80-BL
U10: BMI088; Bosch_LGA-16_4.5x3mm_P0.5mm_LayoutBorder7x1y_ClockwisePinNu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
U12: Airlift; PinSocket_1x12_P2.54mm_Vertical
U14: STM32H723VGTx; LQFP-100_14x14mm_P0.5mm
X1: X322525MOB4SI; CRYSTAL-SMD_4P-L3.2-W2.5-BL
Y3: 32k768; Crystal_SMD_3215-2Pin_3.2x1.5mm

Connections:
+3.3VA: C69.1, C70.1, FB3.1, R65.1, U14.21 (VDDA)
+3V3: BZ1.1 (+), C1.1, C44.1, C45.1, C48.1, C49.1, C55.1, C56.1, C57.1, C58.1, C59.1, C60.1, C75.1, C76.1, CIO1.1, CIO2.1, CS1.1, Card1.4 (VDD), D3.1 (+), D11.2 (A), D12.2 (A), FB3.2, J1.03, J7.2, J8.4, J10.4, J11.4, J13.7, J16.7, J17.5, LED1.4 (A), LED1.5 (A), LED1.6 (A), R2.1, R7.1, R17.1, R18.1, R34.1, R35.1, R36.1, R37.1, R38.1, R47.1, R66.1, SW2.2 (B), TP3.1 (1_1), U3.2 (VOUT), U3.7 (VOUT), U6.6 (V_BCKP), U6.7 (VCC_IO), U6.8 (VCC), U9.1 (VDDI/O), U9.3 (RESERVED), U9.6 (VS), U10.3 (VDD), U10.11 (VDDIO), U12.1 (VIN), U14.6 (VBAT), U14.11 (VDD), U14.27 (VDD), U14.50 (VDD), U14.75 (VDD), U14.100 (VDD)
+3V3_BAT: C2.1, C41.1, L3.2, R10.1, R15.1, U3.3 (VIN1), U3.5 (MODE)
+5V: D4.1 (+), R1.1
+12V: C37.1, C38.1, D9.1, F7.1, F8.1, F9.1, F10.1, Q4.1 (S), Q4.2 (S), Q4.3 (S), R13.1, SW4.1 (A), TP2.1 (1_1), U5.3 (VIN), U5.5 (EN)
+12V_ARM: C46.1, C47.1, C50.1, C52.1, D6.1 (+), Q5.1 (S), Q5.2 (S), Q5.3 (S), Q6.1 (S), Q6.2 (S), Q6.3 (S), R5.2, R6.2, R45.1, R46.1, SW4.2 (B), TP6.1 (1_1)
+BATT: J3.1, Q4.5 (D), Q4.6 (D), Q4.7 (D), Q4.8 (D), TP1.1 (1_1)
/Debugger/GNDDetect: J1.11, R4.2
/Debugger/T_NRST: C24.1, J1.12, R2.2, SW1.2, U14.14 (NRST)
/Debugger/T_SWCLK: J1.06, U14.76 (DEBUG_JTCK-SWCLK)
/Debugger/T_SWDIO: J1.04, U14.72 (DEBUG_JTMS-SWDIO)
/Debugger/T_SWO: J1.08, U14.89 (DEBUG_JTDO-SWO)
/Debugger/T_VCP_RX: J1.14, U14.68 (USART1_TX)
/Debugger/T_VCP_TX: J1.13, U14.69 (USART1_RX)
/External/GPIO.PE2: J13.2, U14.1 (PE2)
/External/GPIO.PE3: J13.3, U14.2 (PE3)
/External/GPIO.PE4: J13.4, U14.3 (PE4)
/External/GPIO.PE5: J13.5, U14.4 (PE5)
/External/GPIO.PE6: J13.6, U14.5 (PE6)
/External/GPIO.PE7: J16.2, U14.37 (PE7)
/External/GPIO.PE8: J16.3, U14.38 (PE8)
/External/GPIO.PE9: J16.4, U14.39 (PE9)
/External/GPIO.PE10: J16.5, U14.40 (PE10)
/External/GPIO.PE11: J16.6, U14.41 (PE11)
/External/I2C4.SCL: J8.2, U14.59 (PD12)
/External/I2C4.SDA: J8.3, U14.60 (PD13)
/External/SERVO_BUS: D10.2 (A2), J18.3, J19.3, J20.3, J21.3, R67.2
/External/SERVO_UART: R66.2, R67.1, U14.82 (UART4_TX)
/External/SPARE_ADC1: J7.1, U14.28 (PA4)
/External/SPI4.MISO: J17.3, U14.43 (SPI4_MISO)
/External/SPI4.MOSI: J17.2, U14.44 (SPI4_MOSI)
/External/SPI4.SCK: J17.4, U14.42 (SPI4_SCK)
/External/UART8_TARGET_RX: J11.2, U14.97 (UART8_RX)
/External/UART8_TARGET_TX: J11.3, U14.98 (UART8_TX)
/External/USART3_TARGET_RX: J10.2, U14.56 (USART3_RX)
/External/USART3_TARGET_TX: J10.3, U14.55 (USART3_TX)
/Igniter/IGN0: D8.2 (A), Q7.1 (G), R42.1, TP9.1 (1_1), U14.61 (PD14)
/Igniter/IGN0_HS: J14.1, Q5.5 (D), Q5.6 (D), Q5.7 (D), Q5.8 (D), R68.2, R69.1
/Igniter/IGN1: D7.2 (A), Q8.1 (G), R44.1, TP10.1 (1_1), U14.62 (PD15)
/Igniter/IGN1_HS: J5.1, Q6.5 (D), Q6.6 (D), Q6.7 (D), Q6.8 (D), R71.2, R72.1
/Igniter/SENSE_I0: C85.1, R69.2, R70.1, TP7.1 (1_1), U14.22 (PA0)
/Igniter/SENSE_I1: C86.1, R72.2, R73.1, TP8.1 (1_1), U14.23 (PA1)
/Indicators/BUZZER: Q1.1 (G), R22.1, U14.67 (TIM1_CH1)
/Indicators/LED: D2.1 (+), U14.77 (PA15(JTDI))
/Indicators/LED.B: R21.2, U14.63 (PC6)
/Indicators/LED.G: R20.2, U14.33 (PC5)
/Indicators/LED.R: R19.2, U14.32 (PC4)
/MCU/BOOT0: R3.1, SW2.1 (A), U14.94 (BOOT0)
/MCU/GPS_RST: U6.9 (~RESET), U14.91 (PB5)
/MCU/HS_OSC_A: C73.1, U14.12 (RCC_OSC_IN), X1.1 (OSC1)
/MCU/HS_OSC_B: C74.1, U14.13 (RCC_OSC_OUT), X1.3 (OSC2)
/MCU/LS_OSC_A: C72.1, U14.8 (RCC_OSC32_IN), Y3.2
/MCU/LS_OSC_B: C71.1, U14.9 (RCC_OSC32_OUT), Y3.1
/MCU/PWR_STS: R7.2, U3.8 (ST), U14.16 (PC1)
/MCU/SDMMC1.CK: R32.1, U14.80 (SDMMC1_CK)
/MCU/SDMMC1.CMD: R31.1, U14.83 (SDMMC1_CMD)
/MCU/SDMMC1.D0: R33.1, U14.65 (SDMMC1_D0)
/MCU/SDMMC1.D1: R28.1, U14.66 (SDMMC1_D1)
/MCU/SDMMC1.D2: R29.1, U14.78 (SDMMC1_D2)
/MCU/SDMMC1.D3: R30.1, U14.79 (SDMMC1_D3)
/MCU/SPI1.CS_375: U9.7 (~CS), U14.88 (PD7)
/MCU/SPI1.CS_BMP: U7.6 (CSB), U14.86 (PD5)
/MCU/SPI1.CS_IMU_ACC: U10.14 (~CSB1), U14.84 (PD3)
/MCU/SPI1.CS_IMU_GYRO: U10.5 (~CSB2), U14.85 (PD4)
/MCU/SPI1.INT_375: U9.8 (INT1), U14.95 (PB8)
/MCU/SPI1.INT_BMP: U7.7 (INT), U14.96 (PB9)
/MCU/SPI1.INT_IMU_ACC: U10.16 (INT1), U14.45 (PE15)
/MCU/SPI1.INT_IMU_GYRO: U10.12 (INT3), U14.36 (PB2)
/MCU/SPI1.MISO: U7.5 (SDO), U9.12 (SDO/ALTADDRESS), U10.10 (SDO2), U10.15 (SDO1), U14.30 (SPI1_MISO)
/MCU/SPI1.MOSI: U7.4 (SDI), U9.13 (SDA/SDI/SDIO), U10.9 (SDI/SDA), U14.31 (SPI1_MOSI)
/MCU/SPI1.SCK: U7.2 (SCK), U9.14 (SCL/SCLK), U10.8 (SCK/SCL), U14.29 (SPI1_SCK)
/MCU/SPI2.BUSY: U12.8 (BUSY), U14.57 (PD10)
/MCU/SPI2.CS: U12.7 (CS), U14.51 (PB12)
/MCU/SPI2.MISO: U12.5 (MISO), U14.53 (SPI2_MISO)
/MCU/SPI2.MOSI: U12.6 (MOSI), U14.54 (SPI2_MOSI)
/MCU/SPI2.RST: U12.9 (~RST), U14.58 (PD11)
/MCU/SPI2.SCK: U12.4 (SCK), U14.52 (SPI2_SCK)
/MCU/USB_D+: U2.4 (I/O2), U14.71 (USB_OTG_HS_DP)
/MCU/USB_D-: U2.6 (I/O1), U14.70 (USB_OTG_HS_DM)
/Power/P_VBUS: C31.1, R1.2, U2.5 (VBUS), U4.3 (VI)
/Power/USB_3V3: C3.1, C34.1, U3.6 (VIN2), U4.2 (VO)
/Power/VOLT_SENSE: R13.2, R14.1, TP4.1 (1_1), U14.15 (PC0)
/Sensors/GPS_RF_IN: SAW2.4 (OUT), U6.11 (RF_IN)
/Sensors/M10S.RX: U6.3 (RXD), U14.24 (USART2_TX)
/Sensors/M10S.TX: U6.2 (TXD), U14.25 (USART2_RX)
GND: BT5.2 (-), C1.2, C2.2, C3.2, C24.2, C31.2, C34.2, C37.2, C38.2, C41.2, C42.2, C43.2, C44.2, C45.2, C47.2, C48.2, C49.2, C50.2, C55.2, C56.2, C57.2, C58.2, C59.2, C60.2, C65.2, C66.2, C67.2, C68.2, C69.2, C70.2, C71.2, C72.2, C73.2, C74.2, C75.2, C76.2, C77.2, C78.2, C79.2, C80.2, C81.2, C82.2, C83.2, C84.2, C85.2, C86.2, CIO1.2, CIO2.2, CS1.2, CS2.2, Card1.6 (VSS), Card1.9 (SHELL), Card1.10 (SHELL), Card1.11 (SHELL), Card1.12 (SHELL), D9.2, D10.1 (A1), F3.1, F4.1, J1.05, J1.07, J7.3, J8.1, J10.1, J11.1, J13.1, J16.1, J17.1, J18.1, J19.1, J20.1, J21.1, Q1.2 (S), Q7.2 (S), Q8.2 (S), R3.2, R4.1, R5.1, R6.1, R8.2, R9.2, R11.2, R14.2, R16.2, R22.2, R23.2, R24.2, R25.2, R27.2, R40.2, R42.2, R43.2, R44.2, R48.2, R70.2, R73.2, SAW2.2 (GND), SAW2.3 (GND), SAW2.5 (GND), SW1.1, TP5.1 (1_1), U2.2 (GND), U3.1 (GND), U4.1 (GND), U5.1 (GND), U6.1 (GND), U6.10 (GND), U6.12 (GND), U7.3 (VSS), U7.8 (VSS), U7.9 (VSS), U9.2 (GND), U9.4 (GND), U9.5 (GND), U9.11 (RESERVED), U10.2 (GNDA), U10.4 (GNDA), U10.6 (GNDIO), U10.7 (PS), U12.3 (GND), U14.10 (VSS), U14.19 (VSSA), U14.26 (VSS), U14.49 (VSS), U14.74 (VSS), U14.99 (VSS), X1.2 (GND), X1.4 (GND)
unnamed: BT3.1 (+), J3.2
unnamed: BT3.2 (-), BT4.1 (+)
unnamed: BT4.2 (-), BT5.1 (+)
unnamed: BZ1.2 (-), Q1.3 (D)
unnamed: C67.1, U14.48 (VCAP)
unnamed: C68.1, U14.73 (VCAP)
unnamed: Card1.2 (CD/DAT3), R30.2, R37.2
unnamed: Card1.5 (CLK), R32.2
unnamed: Card1.3 (CMD), R31.2, R36.2
unnamed: Card1.7 (DAT0), R33.2, R35.2
unnamed: Card1.8 (DAT1), R28.2, R34.2
unnamed: Card1.1 (DAT2), R29.2, R38.2
unnamed: D2.2 (-), R23.1
unnamed: D3.2 (-), R24.1
unnamed: D4.2 (-), R25.1
unnamed: D6.2 (-), R27.1
unnamed: D7.1 (K), R43.1
unnamed: D8.1 (K), R40.1
unnamed: D11.1 (K), R68.1
unnamed: D12.1 (K), R71.1
unnamed: F3.2, J5.2
unnamed: F4.2, J14.2
unnamed: C77.1, C78.1, F7.2, J18.2
unnamed: C79.1, C80.1, F8.2, J19.2
unnamed: C81.1, C82.1, F9.2, J20.2
unnamed: C83.1, C84.1, F10.2, J21.2
unnamed: LED1.1 (K), R21.1
unnamed: LED1.2 (K), R20.1
unnamed: LED1.3 (K), R19.1
unnamed: Q4.4 (G), R48.1
unnamed: C46.2, Q5.4 (G), R39.1, R46.2
unnamed: C52.2, Q6.4 (G), R45.2, R52.1
unnamed: Q7.3 (D), R39.2
unnamed: Q8.3 (D), R52.2
unnamed: AE1.1 (1_1), SAW2.1 (IN)
unnamed: CS2.1, R47.2
unnamed: R10.2, R11.1, U3.4 (PR1)
unnamed: C39.1, U5.6 (CB)
unnamed: R15.2, R16.1, U5.4 (FB)
unnamed: C39.2, L3.1, U5.2 (SW)
unnamed: C43.1, R18.2, U7.10 (VDD)
unnamed: C42.1, R17.2, U7.1 (VDDIO)
unnamed: C65.1, C66.1, R65.2, U14.20 (VREF+)
