stanford-ssi/Aerolotl_KiCAD/(commit log)

2026-02-20 Initial commit for kicad collaboration
    [ADXL345BCCZ-RL7.step, BNO085.step, FTSH-107-01-L-DV-K-A.step, FTSH-107-01-L-DV-K-A.stp, NEO-M9N.step, aerolotl.kicad_pcb, aerolotl.kicad_sch, external.kicad_sch]
2026-02-21 added load capacitors to oscillator
    [aerolotl.kicad_sch, mcu.kicad_sch, power.kicad_sch, sd.kicad_sch]
2026-02-21 Add voltage step down 12V to 3V3
    [power.kicad_sch]
2026-02-21 Added voltage step down form 12V to 3V3
    [power.kicad_sch]
2026-02-21 Added todo list
    [imu.kicad_sch, indicators.kicad_sch]
2026-02-21 added usbc receptacle back
    [power.kicad_sch]
2026-02-21 made stemma qt footprint and symbol and 3d model
2026-02-21 changed stemma qt connector name
2026-02-22 Modified schematics for IMUs
    [aerolotl.kicad_sch, imu.kicad_sch]
2026-02-22 Power Schematic semi-finalized
    [imu.kicad_sch]
2026-02-22 Added indicator circuits
    [indicators.kicad_sch]
2026-02-22 Began external circuitry
    [external.kicad_sch]
2026-02-22 Current progress on externals
    [external.kicad_sch]
2026-02-22 Commit current state before applying gitignore
2026-02-22 Untrack junk KiCad files and enforce .gitignore
2026-02-22 Refactor repository: consolidate custom libraries, move hierarchical sheets, and clean up root directory
    [ADXL345BCCZ-RL7.step, BNO085.step, FTSH-107-01-L-DV-K-A.step, FTSH-107-01-L-DV-K-A.stp, NEO-M9N.step, aerolotl.kicad_pcb, external.kicad_sch, ftdi.kicad_sch]
2026-02-23 added current rush limiting resistors to bmp581
    [aerolotl.kicad_sch, external.kicad_sch, igniter.kicad_sch, imu.kicad_sch, indicators.kicad_sch, mcu.kicad_sch, power.kicad_sch, sd.kicad_sch]
2026-02-23 Untrack kicad auto save file, hopefully caleb won't have issues pulling anymore lol
2026-02-23 added SparkFunM9N breakout board footprint
2026-02-23 Added NEOM9N breakout symbol
    [aerolotl.kicad_sch, external.kicad_sch, imu.kicad_sch, mcu.kicad_sch]
2026-02-23 Wired NEOM9N breakout
    [imu.kicad_sch]
2026-02-23 Fixed up power, added remaining to do
    [aerolotl.kicad_pcb, external.kicad_sch, imu.kicad_sch, indicators.kicad_sch, mcu.kicad_sch, power.kicad_sch]
2026-02-24 polished up circuit, added new 16.8V to 7.4V step down circuit components
    [aerolotl.kicad_pcb, aerolotl.kicad_sch, external.kicad_sch, igniter.kicad_sch, indicators.kicad_sch, mcu.kicad_sch, power.kicad_sch, swd.kicad_sch]
2026-02-24 Made 7.4V stepdown circuit in power sheet
2026-02-24 checked up w Lawton
    [sensors.kicad_sch]
2026-02-24 second push
    [aerolotl.kicad_sch, external.kicad_sch, mcu.kicad_sch, power.kicad_sch, sensors.kicad_sch]
2026-02-24 Added pinouts for I2C
    [aerolotl.kicad_sch, external.kicad_sch]
2026-02-24 Deleted I2C3
    [external.kicad_sch]
2026-02-24 Routed all external I2C connectors
    [mcu.kicad_sch]
2026-02-24 connected pwm, spare uarts, i2cs, etc.
2026-02-24 removed fd can
    [aerolotl.kicad_sch, external.kicad_sch, mcu.kicad_sch, sensors.kicad_sch]
2026-02-25 added spi
2026-02-25 led pwm
    [aerolotl.kicad_sch, indicators.kicad_sch, mcu.kicad_sch]
2026-02-25 added Capacitor values for sensors
    [sensors.kicad_sch]
2026-02-25 assigned gpio pin to led (pg6)
    [aerolotl.kicad_sch, indicators.kicad_sch, mcu.kicad_sch, sensors.kicad_sch]
2026-02-25 added gpio connections in root, UART8, ADC2
    [aerolotl.kicad_sch, external.kicad_sch, igniter.kicad_sch, indicators.kicad_sch, mcu.kicad_sch, power.kicad_sch]
2026-02-25 final pwm channels added
    [external.kicad_sch, mcu.kicad_sch]
2026-02-25 final rev1
    [aerolotl.kicad_sch, igniter.kicad_sch, sensors.kicad_sch]
2026-02-25 Rev1 schematic done
    [external.kicad_sch, igniter.kicad_sch, indicators.kicad_sch, mcu.kicad_sch, power.kicad_sch, sd.kicad_sch, sensors.kicad_sch, swd.kicad_sch]
2026-02-25 Cleared all ERC errors
    [indicators.kicad_sch]
2026-02-25 moving onto pcb layout and footprinting
2026-02-26 Cleared ALL ERC warnings
    [aerolotl.kicad_sch, external.kicad_sch, igniter.kicad_sch, indicators.kicad_sch, mcu.kicad_sch, power.kicad_sch, sd.kicad_sch, sensors.kicad_sch]
2026-02-26 added capacitor values to sensors
    [sensors.kicad_sch]
2026-02-27 some footprints assigned
    [aerolotl.kicad_pcb, external.kicad_sch, mcu.kicad_sch, power.kicad_sch, sensors.kicad_sch]
2026-02-27 letter size schematic pages formatted
    [aerolotl.kicad_sch, external.kicad_sch, igniter.kicad_sch, indicators.kicad_sch, mcu.kicad_sch, mcu_power.kicad_sch, power.kicad_sch, sd.kicad_sch]
2026-09-05 some changes for 2027 aerolotl
    [aerolotl.kicad_pcb, aerolotl.kicad_sch, airlift.kicad_sch, external.kicad_sch, igniter.kicad_sch, indicators.kicad_sch, mcu.kicad_sch, power.kicad_sch]
2026-09-28 Save Aerolotl PCB and schematic progress
    [aerolotl.kicad_pcb, aerolotl.kicad_sch, airlift.kicad_sch, external.kicad_sch, igniter.kicad_sch, indicators.kicad_sch, mcu.kicad_sch, power.kicad_sch]
2026-10-06 Add CamControl AV bay battery/arming/camera board, ready to order
    CamControl is the round 5.72 in board that powers the AV bay: 2S pack + buck
    for the camera and ESP32, an isolated cell and pin-switch plug for each of the
    COTS (TeleMetrum) and SRAD (Aerolotl) flight computers, and a RunCam Split 4
    on standoffs on the back.
    - KiCad 10 project (v16): ERC 0 errors, DRC 0 with schematic parity, verify ALL PASS
    - fab/: ordering BOM with manufacturer part numbers, Gerbers + drill zip, schematic PDF
    - cad/: board STEP and the board + pin-switch stack STEP used by the AVBay1 Onshape doc
    - tools/: scripts that rebuild the layout, annotate MPNs and regenerate the BOM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
    [Molex_Micro-Fit_3.0_43650-0215_1x02_P3.00mm_Vertical.step, RunCam_Split4_placeholder.step, avbay1_board_and_pin_switch_stack.step, buck_5v.kicad_sch, camcontrol.kicad_pcb, camcontrol.kicad_sch, camcontrol_BOM.csv, camcontrol_power_pcb.step]
2026-10-06 Rename CamControl to Battery PCB; include the Gerber zip
    - Folder CamControl/ -> BatteryPCB/, project camcontrol.* -> battery_pcb.*,
    footprint library camcontrol -> battery_pcb, outputs renamed to match
    - Gerbers, schematic PDF, BOM, STEPs and renders regenerated under the new name
    - .gitignore ignores *.zip; add an exception so BatteryPCB/fab/battery_pcb_gerbers.zip
    is committed (it was missing from the first commit)
    - Re-checked after the rename: ERC 0 errors, DRC 0 with schematic parity,
    layout checks ALL PASS, full scripted rebuild passes
    [Molex_Micro-Fit_3.0_43650-0215_1x02_P3.00mm_Vertical.step, RunCam_Split4_placeholder.step, avbay1_board_and_pin_switch_stack.step, battery_pcb.kicad_pcb, battery_pcb.kicad_sch, battery_pcb.step, battery_pcb_BOM.csv, buck_5v.kicad_sch]
2026-10-06 Battery PCB v17: test points, strict design rules, review fixes
    - Test points: TP1 +5V (buck output), TP2 VBAT+ (2S pack), TP3/TP4 GND;
    2 mm through-hole pads placed where both sides are open
    - Strict rules in the project: 0.25/0.3/0.4 mm clearance (signal/power/pyro),
    0.3 mm hole clearance, 0.5 mm hole-to-hole, 0.15 mm via ring, silk spacing;
    every DRC check is an error. Fixed the spots they flagged around U1, R4, C8,
    D1/D3 silk and the TP4 label
    - R5 47k -> 39k so VBAT_SENSE stays inside the ESP32 ADC range at a full pack
    - BOM note: the RunCam needs a built harness (3-pin power/video + RX/TX pads)
    - README: exact ESP32 to buy (ESP32-DevKitC-32E, not WROVER or 30-pin clones),
    des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
    [avbay1_board_and_pin_switch_stack.step, battery_pcb.kicad_pcb, battery_pcb.step, battery_pcb_BOM.csv, buck_5v.kicad_sch, power_in.kicad_sch, sense.kicad_sch]
2026-10-08 Battery PCB: add the whole KiCad project as one ZIP for sharing
    Downloading only battery_pcb.kicad_sch opens a blank schematic because
    its six pages live in sheets/. The ZIP holds the project, all sheets, the
    board, the custom footprints and 3D models.
2026-10-08 Battery PCB v18: antenna clearance, stack outline, cut-outs, XT30 outputs
    Second design review:
    - ESP32 antenna: back-copper keep-out (no pour, tracks or vias) 15 mm to
    each side of and past the DevKitC antenna, outlined on the back silk;
    COTS_SW rerouted around it; nylon M3 note for H5, the stack bolt over it.
    - Pin-switch stack outlined on the front silk.
    - Two spare 12 x 7 mm wire pass-throughs at the upper left.
    - J5/J6 battery outputs are AMASS XT30UPB-F (pin 1 minus, pin 2 plus);
    schematic labels swapped to match, BOM and cable-side parts updated.
    ERC 0 errors, DRC 0 (strict, schematic parity), verify_A all pass.
    [AMASS_XT30UPB-F_1x02_P5.0mm_Vertical.step, avbay1_board_and_pin_switch_stack.step, battery_pcb.kicad_pcb, battery_pcb.step, battery_pcb_BOM.csv, supplies.kicad_sch]
2026-10-09 Battery PCB v19: UVLO on the buck, input caps, 6.8 uH, wired schematic
    Third review (design check of the power path):
    - U1 EN gets an R9/R10 divider (UVLO: on 6.3 V, off 5.5 V at VIN) so
    the 2S pack is no longer run down to 1.8 V per cell.
    - Input caps per the LMR51430 datasheet: C1 is the 100 nF at U1's pins,
    C2 + new C11 (10 uF) are the bulk.
    - L1 6.8 uH (TI's value for 500 kHz / 5 V out), same footprint.
    - Sheets 1-3 redrawn with wires; C1/C2 moved next to U1; stale 47k
    divider note and the SS34 value on D3 corrected.
    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
    [avbay1_board_and_pin_switch_stack.step, battery_pcb.kicad_pcb, battery_pcb.step, battery_pcb_BOM.csv, buck_5v.kicad_sch, power_in.kicad_sch, sense.kicad_sch]
2026-10-09 Battery PCB v19.1: LCSC part numbers, R9 402k (412k out of stock)
    - BOM: checked LCSC numbers for every soldered part LCSC sells, DigiKey/
    Mouser numbers for the rest (Keystone 1042, Wurth 9774050243R, ESP32).
    J1/J2 LCSC alternative HCTL PM254-1-19-Z-8.5 (Sullins out of stock).
    - JLCPCB assembly BOM + CPL (optional).
    - R9 412k -> 402k (412k has no LCSC stock): UVLO on 6.2 V, off 5.4 V.
    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
    [battery_pcb.kicad_pcb, battery_pcb_BOM.csv, battery_pcb_JLCPCB_BOM.csv, buck_5v.kicad_sch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]
2026-10-09 Battery PCB v20: thermal reliefs for hand soldering, dimensions, assembly notes
    - GND pours meet every pad through thermal spokes (SMD pads included) so
    the board can be hand-soldered.
    - README: mechanical dimensions table and a hand-assembly order (ESP32
    sockets before the battery holders).
    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
    [battery_pcb.kicad_pcb]
2026-10-09 Battery PCB v21: R8 1k camera-RX protection, separate drill files
    - R8 (camera TX -> ESP32 RX) 100R -> 1k: protects GPIO16 if the
    RunCam's UART turns out to be 5 V.
    - Separate PTH/NPTH drill files; tools/make_fab.sh rebuilds fab/.
    - README: camera logic-level check, USB + board power is safe (DevKitC
    feeds 5V from USB through a Schottky).
    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
    [battery_pcb.kicad_pcb, battery_pcb_BOM.csv, battery_pcb_JLCPCB_BOM.csv, camera.kicad_sch]
2026-10-09 Battery PCB: centred STEP export for Onshape; AVBay1 updated to v21
    - tools/make_step.sh exports the board STEP centred (--user-origin
    150x150mm), as the v17 files were; v18-v21 had dropped that option and
    the board landed 150 mm off the pin-switch stack.
    - cad/battery_pcb.step and cad/avbay1_board_and_pin_switch_stack.step
    regenerated; AVBay1's board import and main assembly updated.
    [avbay1_board_and_pin_switch_stack.step, battery_pcb.step]
2026-10-09 Battery PCB: schematic as re-saved by KiCad 10 (format only)
    [battery_pcb.kicad_sch, buck_5v.kicad_sch, camera.kicad_sch, esp32.kicad_sch, power_in.kicad_sch, sense.kicad_sch, supplies.kicad_sch]
2026-10-09 Battery PCB v22: RunCam standoffs moved out to the upper-left rim
    The four SMT camera standoffs (no holes through the board) move from
    (-24, 14.75) to (-35.5, -30), about 46 mm from the centre instead of 28,
    clear of the ESP32, buck, J3, rod nut, cut-outs and antenna keep-out.
    DRC 0 with schematic parity, verify_A all pass. Fab outputs, STEP and
    renders regenerated.
    [avbay1_board_and_pin_switch_stack.step, battery_pcb.kicad_pcb, battery_pcb.step]
2026-10-09 Battery PCB schematic: ESP32, camera and pack-sense sheets merged; C9/C10 on the buck output
    Schematic only: sheets 3-5 become one wired sheet (3. ESP32 + camera), C9/C10 move
    to the buck sheet's +5V output, supplies renumbered 6 -> 4. Every connection,
    part, value and footprint is unchanged; the board only gets the new sheet paths
    and net-name prefixes (tools/sync_from_sch.py). Gerbers and drills are
    geometrically identical to v22. DRC 0 with schematic parity.
    [battery_pcb.kicad_pcb, battery_pcb.kicad_sch, buck_5v.kicad_sch, camera.kicad_sch, esp32.kicad_sch, esp32_camera.kicad_sch, sense.kicad_sch, supplies.kicad_sch]
2026-10-09 Battery PCB: schematic sheets re-saved after cleanup; board net names re-escaped
    Same design as 428171c: identical netlist (42 parts, 55 nets, same pins,
    values, footprints and MPNs) and identical board geometry. The board only
    changes the sheet-name escaping inside net names ("COTS / SRAD" ->
    "COTS {slash} SRAD").
    Checks on this commit: ERC 0 errors; strict DRC 0 violations, 0 unconnected,
    0 schematic parity issues (also with zones refilled); verify_A.py ALL PASS.
    New ERC warnings: 16 endpoint_off_grid on the root and COTS/SRAD sheets
    (half-grid wire ends and J6 pin 1); connectivity is unaffected.
    [battery_pcb.kicad_pcb, battery_pcb.kicad_sch, buck_5v.kicad_sch, esp32_camera.kicad_sch, supplies.kicad_sch]
2026-10-09 Battery PCB README: camera harness wiring table (J3 pin to Split 4 pad)
    The Split 4 pads run RX, TX, Video, GND, VCC (RunCam manual, Side B);
    J3 runs +5V, GND, CAM_RX, CAM_TX, VIDEO, so the harness must be wired
    by label, not straight across.
2026-10-10 Battery PCB v23: review 3 fixes (5 V setpoint, boot cap, GND vias, antenna keep-out)
    - R3 13k7 -> 13k (RC0603FR-0713KL, LCSC C137796): 5.22 V nominal,
    5.05-5.39 V worst case, so the RunCam always gets >= 5.0 V.
    - C3 moved beside U1; its SW side lands directly on L1's pad (no vias).
    - New GND via ~1 mm from U1 pin 1; 5 stitching vias in open GND pour.
    - Front antenna no-pour area now matches the back keep-out (48 x 21 mm).
    - R10 pad 2 solid to the pour plus a trace to its via.
    - fab/ regenerated (BOM, Gerbers, drills, schematic PDF, project zip).
    ERC 0 errors; DRC 0 violations / 0 unconnected / 0 parity (also with
    zones refilled); verify_A ALL PASS.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
    [battery_pcb.kicad_pcb, battery_pcb_BOM.csv, battery_pcb_JLCPCB_BOM.csv, buck_5v.kicad_sch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]
2026-10-10 Battery PCB BOM: stock alternates for C2/C9/C11 and C3/C6/C8/C10, D1 listing note
    Every LCSC number re-checked against lcsc.com on 9 Oct 2026 (all 26 resolve
    to the intended MPN). Two were low on stock, so the Notes column now lists
    in-stock equivalents:
    - CL21A106KAYNNNE (C15850, 20 pcs): Murata GRM21BR61E106KA73L (C84416)
    or FH 0805X106K250NT (C40894)
    - CL10B104KB8NNNC (C1591, 100 pcs, MOQ 100): FH 0603B104K500NT (C30926)
    D1: LCSC's spec rows for C151251 show SMBJ13A values; noted.
    No part numbers, LCSC numbers or schematic fields changed.
    [battery_pcb_BOM.csv]
2026-10-10 Battery PCB BOM: J5/J6 XT30 male on the board, female plugs on the cables
    BOM-only change. J5/J6 order XT30UPB-M (LCSC C428721) instead of
    XT30UPB-F; KiCad's male and female XT30UPB footprints have identical
    copper, holes and courtyard, so the schematic and board are unchanged
    (their MPN/footprint fields still say -F; make_bom.py maps it). The
    cable side becomes XT30U-F (LCSC C99102).
    [battery_pcb_BOM.csv, battery_pcb_JLCPCB_BOM.csv]
2026-10-10 Battery PCB README: J5/J6 are male XT30 (XT30UPB-M), cables take XT30U-F
    Matches the BOM change in f6b333f. Notes that the male part shares the
    female footprint and that the exposed plus pin is live once armed.
2026-10-11 Preserve battery PCB progress and prepare partial JLC assembly files
2026-10-11 Correct Q1 and D2 JLC assembly rotations and record placement audit
2026-10-11 Battery PCB BOM: ESP32 sourcing, camera version, camera screw length
    - ESP32-DevKitC-32E: Mouser has 676 (11 Oct 2026); DigiKey has 0 until
    Jun 2027. Notes that it must be the genuine 38-pin WROOM-32E board.
    - Camera: RunCam Split 4 V3, with board size, hole square and supply.
    - Camera screws: M2 x 5 (4-6 mm fit), matching LAYOUT_NOTES.
2026-10-11 Battery PCB v24: 3.0 mm pin holes for the camera standoffs (H7-H10)
    The Wurth 9774050243R SMT standoff has a 1.4 mm, 2.8 mm-diameter locating
    pin on its base; the old _NoHole footprint had nowhere for it, so the
    standoffs would have sat 1.4 mm off their pads. H7-H10 now use Wurth's
    land pattern with the 3.0 mm non-plated hole (same positions). The pin
    stays inside the 1.6 mm board; no front copper within 3.5 mm.
    - Front silk line through H8 gets a gap.
    - 3 documented DRC exclusions: H9/H10 holes inside BT1/BT2 courtyards,
    BT1 outline silk over H9's hole.
    - place_A.py points at the new footprint; old footprint removed.
    - fab/ regenerated (NPTH drill now has 4 x 3.0 mm at the standoffs).
    E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
2026-10-11 Battery PCB order package: sync the hand-fit shopping list with the BOM
    ESP32 sourcing (Mouser; DigiKey has none until Jun 2027), RunCam Split 4
    V3, and M2 x 5 camera screws, matching fab/battery_pcb_BOM.csv.
2026-10-11 Battery PCB 30-pin version: copy of BatteryPCB for a 30-pin ESP32 DevKit V1
    BatteryPCB_30pin/ is a separate copy of BatteryPCB (v26, b50faa4) for the
    team's 30-pin ESP32 DevKit V1 (DOIT layout, ESP-WROOM-32, 2 x 15 pins,
    rows 25.4 mm apart). BatteryPCB itself is unchanged.
    - J1/J2: 1x15 sockets (Sullins PPTC151LFBN-RC / LCSC C2897378), same
    columns, pin 1 where the DevKitC's was. Every pin checked against the
    DOIT DevKit V1 schematic and the board's silkscreen.
    - Same GPIOs, re-routed: VIN/+5V J1-15, GND J1-14/J2-14, GPIO34 battery
    sense J1-4, GPIO17/16 camera UART J2-9/10, GPIO2 LED J2-12.
    - R7/R8 and their vias moved up 5.08 mm; C9/C10, their GND vias and TP1
    up 10.16 mm, next to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
2026-10-11 Battery PCB 30-pin: J3 pin order matches the RunCam Split 4 pads
    J3 pins 3 and 5 swapped (3 = CAM_VIDEO, 5 = CAM_RX), so J3 pin 1..5 =
    VCC, GND, Video, TX, RX, the camera's own pad order: the camera harness
    is now a straight cable with no crossed wires.
    - Schematic sheet 3 and the board pad nets updated; CAM_RX now drops to
    the back right beside pin 5 (route 2.5 mm shorter, old via removed).
    - Back-silk legend reads 3 VID / 4 TX / 5 RX; README harness table, BOM
    camera note and hand-fit list updated; Gerbers, order-package zip,
    schematic PDF, project zip and STEP regenerated.
    - ERC 0 errors, DRC 0 (schematic parity, zones refilled, same 3
    exclusions), verify_A unchanged, all 27 CPL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
2026-10-11 Battery PCB 30-pin: test-point block on the right edge (5V, GND, COTS +/-, SRAD +/-)
    Six through-hole test points together on the front right edge, between
    the right rod's washer keep-out and the lower zip-tie cut-out, labelled
    on the silk: top row TP1 +5V, TP5 COTS +, TP7 SRAD +; bottom row TP3 GND,
    TP6 COTS -, TP8 SRAD -.
    - TP1/TP3 moved out of the BT3/BT4 gap (hard to reach with cells in).
    - TP5-TP8 are new (schematic sheet 4): the COTS and SRAD cells are
    isolated from GND, so each gets its own + / - pair, before the pin
    switch, so they read the cell whether armed or not.
    - Routing: +5V from J1-15 (front, via at (44, 2), back); COTS/SRAD +
    from the top tabs down a channel beside BT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
2026-10-12 Battery PCB 30-pin: XT30 and battery-holder holes to the datasheets; notes, check script
    - XT30 J5/J6 pin holes 1.8 -> 1.9 mm (Amass drawing: 1.9 mm for the
    1.6 mm pins); 0.55 mm copper ring left on the 3.0 mm pads.
    - Keystone 1042 holder peg holes 3.45 -> 3.5 mm and locator hole
    2.39 -> 2.4 mm on BT1-BT4 (Keystone M65p27; positions unchanged).
    Footprints updated in battery_pcb.pretty and on the board.
    - Only those 16 hole sizes changed on the board: no part, trace, via,
    outline or silk moved. Tightest new gap: COTS_SW to a BT4 peg hole
    0.375 mm (rule 0.3).
    - Schematic notes brought up to date: Q1 drop ~0.05 V (was 0.35 V from
    the old diode), J5/J6 are XT30 not Micro-Fit, C9/C10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
2026-10-12 Battery PCB (38-pin): regenerate the STEP models for the camera-standoff pin holes
    cad/battery_pcb.step and cad/avbay1_board_and_pin_switch_stack.step
    re-exported with tools/make_step.sh from the current board (v26, the
    3.0 mm camera-standoff pin holes), for the Onshape AVBay1 update. No
    board, schematic or fab change.
2026-10-12 Battery PCBs: one MPN per part, and a DRC rule for the standoff pads (KiCad 10.0.6)
    C1, C4, C5, D2, J5 and J6 each carried two Manufacturer / MPN fields. KiCad 10.0.0
    read the second (the annotate_mpn.py value); 10.0.6 reads the first (an old value),
    so a 10.0.6 BOM would have ordered CL21A226MOQNNNE (16 V) for C4/C5, a Lite-On LED,
    a Samsung C1 and XT30UPB-F. Each part now has one field with the annotate_mpn.py
    value. BOM and CPL regenerate byte-identical; board and Gerbers unchanged.
    10.0.6 also checks pads against a hole in the same footprint, which flags Wuerth's
    standoff land pattern (solder ring at its own 3.0 mm pin hole) 16 times. The new
    .kicad_dru relaxes only that pad-to-own-hole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
